zwmurray23/ncsu-freedm-srdes-21/Existing IC Models/CONMMCX001/CONMMCX001.step

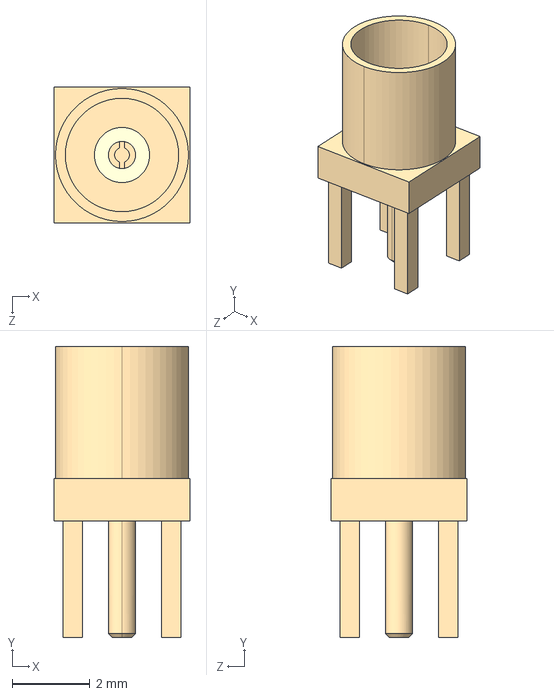
[picture p2: CAD file, 2022-02-21]
Existing IC Models/CONMMCX001/CONMMCX001.step
3.50 x 7.50 x 3.50 mm
