zwmurray23/ncsu-freedm-srdes-21/Existing IC Models/TLV3501AID/3D/TLV3501AID.stp

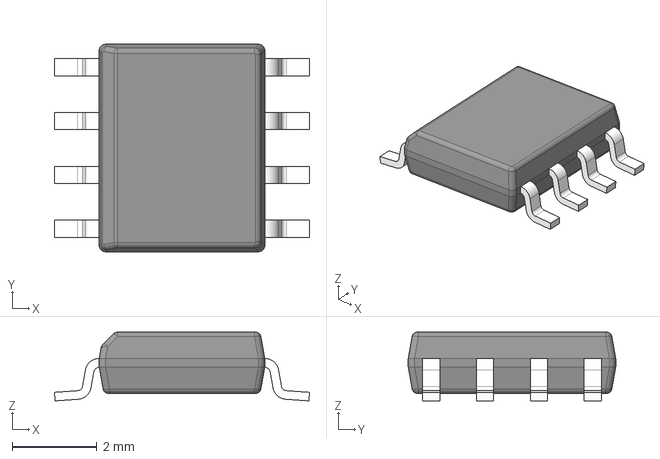
[picture p3: CAD file, 2021-10-21]
Existing IC Models/TLV3501AID/3D/TLV3501AID.stp
6.02 x 4.90 x 1.63 mm
BODY-SO
LEAD-D0008A x 8
