zwmurray23/ncsu-freedm-srdes-21/Existing IC Models/TPS3305-33D/TPS3305-33D.step

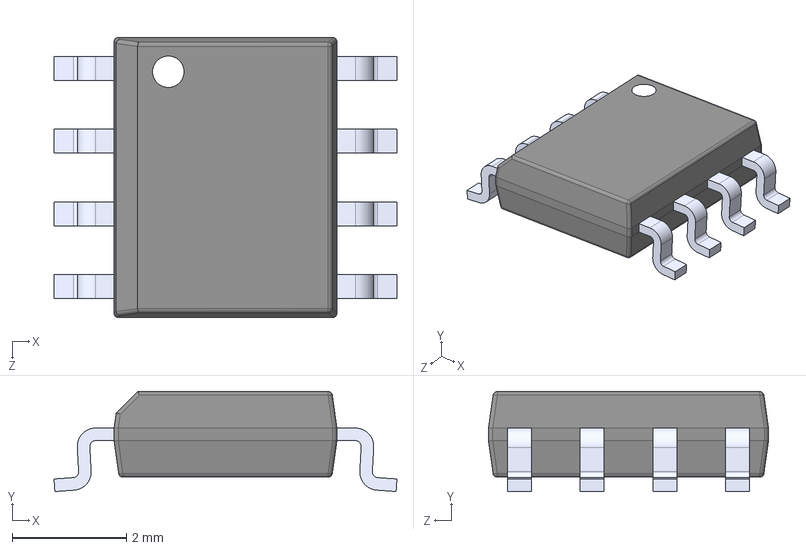
[picture p4: CAD file, 2021-11-08]
Existing IC Models/TPS3305-33D/TPS3305-33D.step
6.00 x 1.75 x 4.90 mm
