zwmurray23/ncsu-freedm-srdes-21/MC-DSP/MC-DSP Libraries/74ACT08SCX/3D/74ACT08SCX.stp

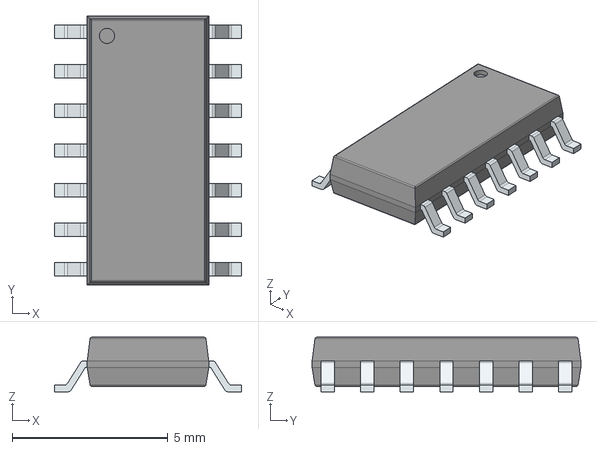
[picture p5: CAD file, 2021-10-21]
MC-DSP/MC-DSP Libraries/74ACT08SCX/3D/74ACT08SCX.stp
6.00 x 8.62 x 1.75 mm
PinsArrayLR
