zwmurray23/ncsu-freedm-srdes-21/MC-DSP/MC-DSP Libraries/CDCLVC1104PW/eec.models/Texas_Instruments_-_CDCLVC1104PW.step

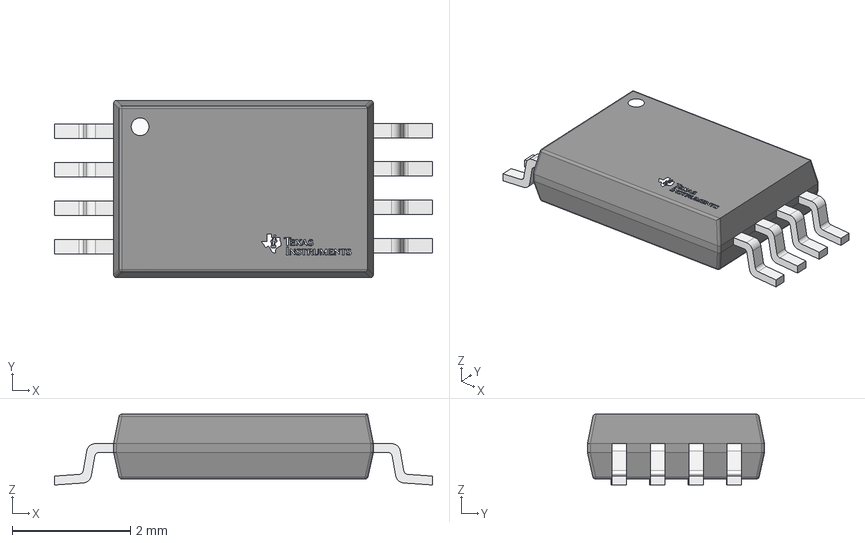
[picture p6: CAD file, 2021-11-08]
MC-DSP/MC-DSP Libraries/CDCLVC1104PW/eec.models/Texas_Instruments_-_CDCLVC1104PW.step
6.40 x 3.00 x 1.20 mm
IC_BODY
IC_LEG x 4
circle
IC_LEG_MIR7 x 4
Texas Instruments
