zwmurray23/ncsu-freedm-srdes-21/MC-DSP/MC-DSP Libraries/DSP_parts/TPS3702CX33DDCR 3.3V Supervisor/TPS3702CX33DDCR.step

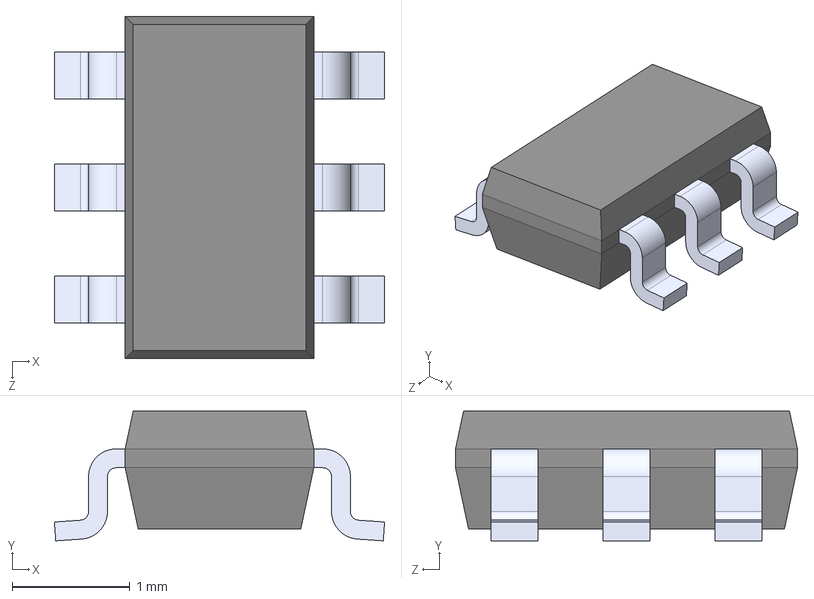
[picture p7: CAD file, 2021-11-08]
MC-DSP/MC-DSP Libraries/DSP_parts/TPS3702CX33DDCR 3.3V Supervisor/TPS3702CX33DDCR.step
2.80 x 1.10 x 2.90 mm
