zwmurray23/ncsu-freedm-srdes-21/MC-DSP/MC-DSP Libraries/R-78E5.0-0.5/3D/R-78E5.0-0.5.stp

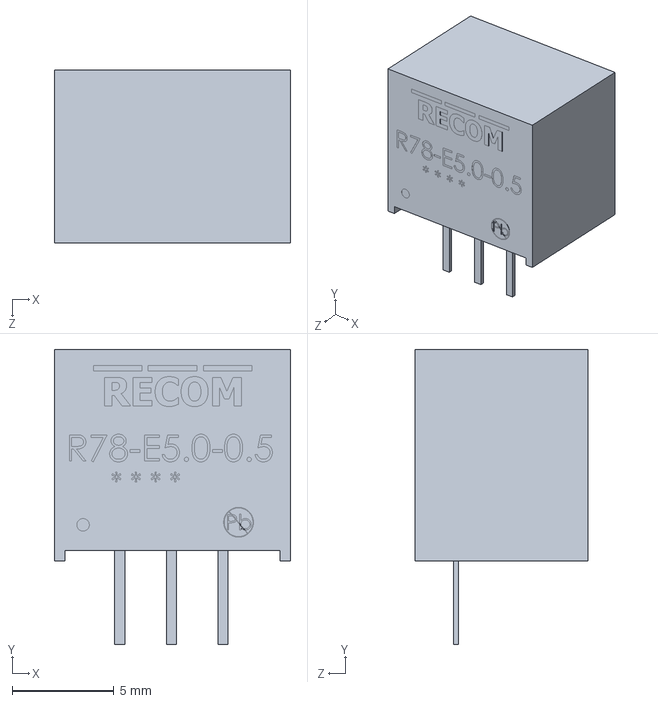
[picture p9: CAD file, 2021-10-21]
MC-DSP/MC-DSP Libraries/R-78E5.0-0.5/3D/R-78E5.0-0.5.stp
11.6 x 14.5 x 8.51 mm
