zwmurray23/ncsu-freedm-srdes-21/MC-FO/Footprints_MC-FO/FOport-IFE98-IFD97.STEP

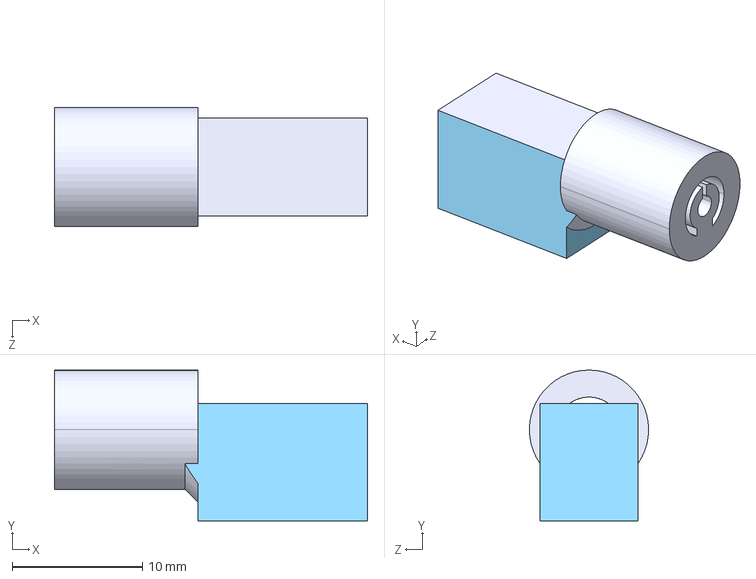
[picture p10: CAD file, 2022-01-19]
MC-FO/Footprints_MC-FO/FOport-IFE98-IFD97.STEP
24.0 x 11.6 x 9.14 mm
