zwmurray23/ncsu-freedm-srdes-21/Existing IC Models/DP83822IRHBR/DP83822IRHBR.step

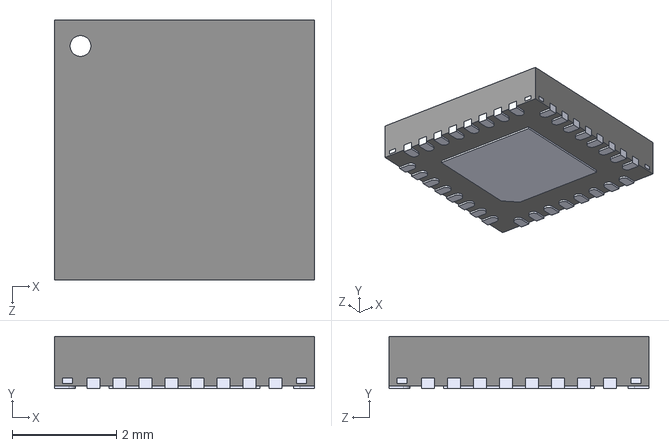
[picture p11: CAD file, 2021-11-08]
Existing IC Models/DP83822IRHBR/DP83822IRHBR.step
5.00 x 1.00 x 5.00 mm
