zwmurray23/ncsu-freedm-srdes-21/(list of files, cad)

Other CAD files:
MC-DSP/MC-DSP Libraries/74ACT08SCX/3D/74ACT08SCX.stl
MC-DSP/MC-DSP Libraries/TPS3703A5500DSER/3D/TPS3703A5500DSER.stl
