zwmurray23/ncsu-freedm-srdes-21/LTSpice/senior_design_attenuator_offset.asc

C1: cap; 470p
C2: cap; 43n
R1: res; 1.5k
R2: res; 5k
R3: res; 1.75k
R4: res; 1.5k
R16: res; {Ri}
R17: res; {Rf}
U1: LT6238
U3: LT6238
V1: voltage; 3
V2: voltage; 3.3
V3: voltage; 0.4
V4: voltage; SINE(0 1 10k); AC 0.1
V5: voltage; 5
V6: voltage; 5
V9: voltage; {Vref}
V11: voltage; SINE(0 10 10k); AC 0.1
Named nets: VSE+, 0, VSE-, V2+, V2-
.tran 0 150u 0 1n
;.ac dec 30 1k 100Meg
.param Rf=330 G=3/20 Ri=Rf/G Vref=Ri/(Rf+Ri) *1.5
;.step param Cs list 15n 16n 18n 20n 22n 24n 27n 30n 33n 36n 39n 43n 47n 51n 56n 62n 68n 75n
Schematic Design
Proposed Alternative Design
