zwmurray23/ncsu-freedm-srdes-21/LTSpice/TI_DSP_single_ended_adc_with_offset.asc

C1: cap; 470p
C2: cap; 43n
C31: cap; 6p
C33: cap; 14.5p
C34: cap; 1p
E4: e2; -1
L7: ind; 1f
R1: res; {Ri}
R2: res; 250
R3: res; {Rf}
S10: sw; SW3
S12: sw; SW2
U1: LT6238
V1: voltage; 3.3
V2: voltage; 5
V3: voltage; 0.4
V4: voltage; {Vref}
V5: voltage; SINE(0 10 10k); AC 0.1
V7: voltage; PULSE(0 1 0 1n 1n 75n 295n)
V9: voltage; 5
Named nets: 0, 5V, sw2+, -5V, VSE+, VSE-
.tran 0 150u 0 1n
.model SW1 SW(Ron=700 Roff=1Meg Vt=.5 Vh=-.4)
.model SW2 SW(Ron=1 Roff=1Meg Vt=-.5 Vh=-0.1)
;.ac dec 30 1k 10G
.model SW3 SW(Ron=425 Roff=1Meg Vt=.5 Vh=-.4)
TI Single-ended 12-Bit, 3MSPS ADC Model
.param Rf=330 G=3/20 Ri=Rf/G Vref=Ri/(Rf+Ri) *1.5
;.step param Cs list 15n 16n 18n 20n 22n 24n 27n 30n 33n 36n 39n 43n 47n 51n 56n 62n 68n 75n
