zwmurray23/ncsu-freedm-srdes-21/MC-FO/MC-FO.kicad_pcb

## KiCad design MC-FO/MC-FO.kicad_pcb (2022-04-28)

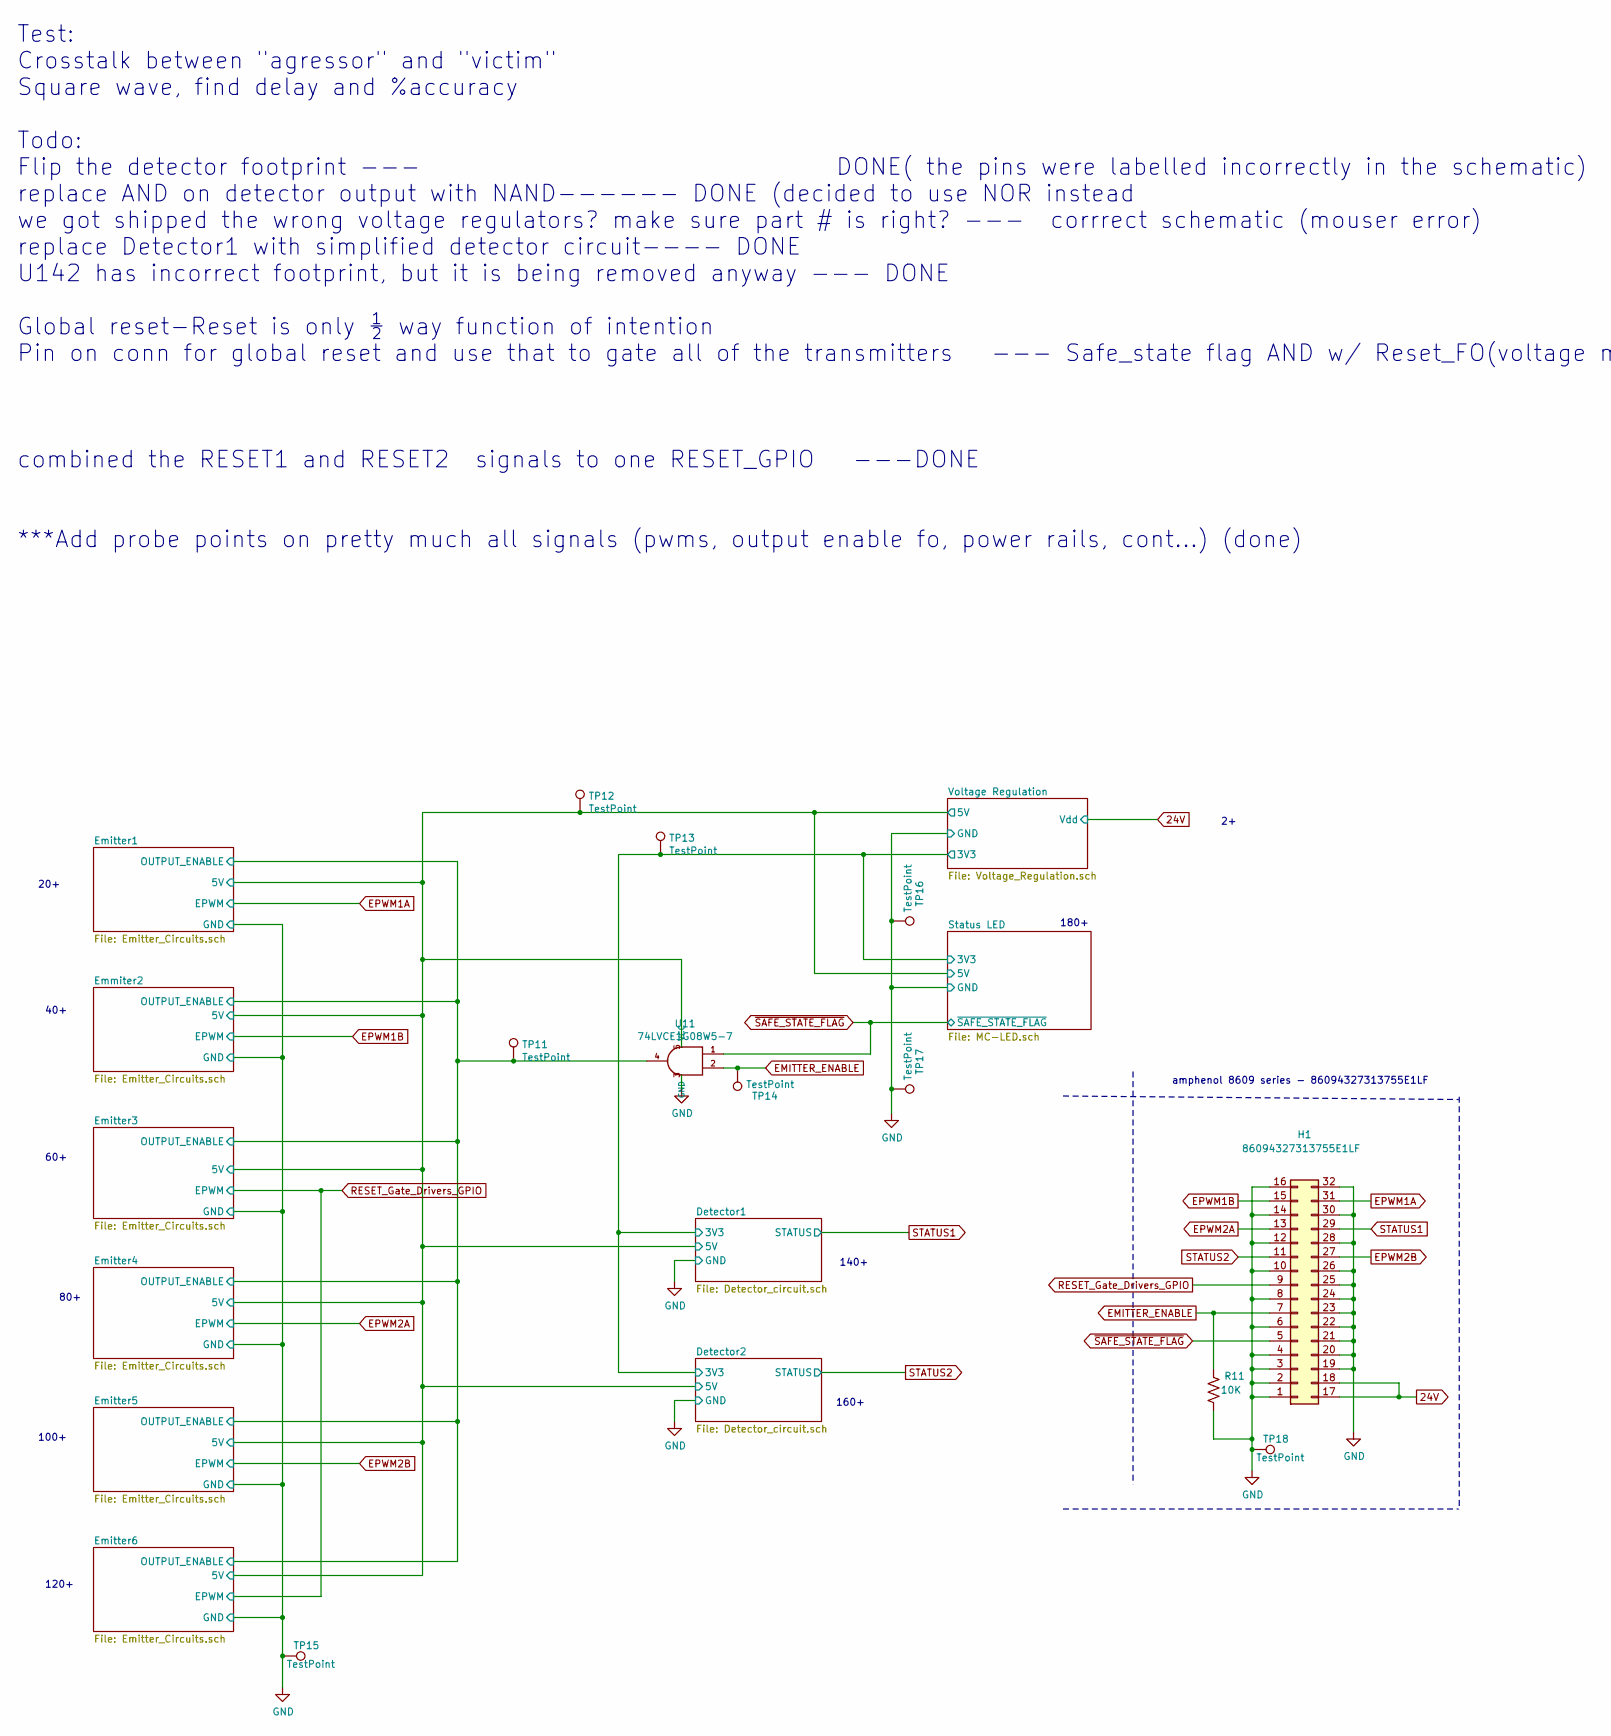
[picture p12: schematic MC-FO.sch, part in row 1, column 1]

Parts:
H1: 86094327313755E1LF
R11: 10K; R_0603_1608Metric
TP11, TP12, TP13, TP14, TP15, TP16, TP17, TP18: TestPoint; TestPoint_Pad_D2.0mm
U11: 74LVCE1G08W5-7; SOT-23-5_HandSoldering

Connections:
24V: H1.17, H1.18; also elsewhere on the board
/Detector1/3V3: TP13.1; also elsewhere on the board
/Detector1/5V: TP12.1, U11.5 (VCC); also elsewhere on the board
/Emitter1/OUTPUT_ENABLE: TP11.1, U11.4; also elsewhere on the board
EMITTER_ENABLE: H1.7, R11.2, TP14.1, U11.2
EPWM1A: H1.31; also elsewhere on the board
EPWM1B: H1.15; also elsewhere on the board
EPWM2A: H1.13; also elsewhere on the board
EPWM2B: H1.27; also elsewhere on the board
GND: H1.1, H1.2, H1.3, H1.4, H1.6, H1.8, H1.10, H1.12, H1.14, H1.16, H1.19, H1.20, H1.21, H1.22, H1.23, H1.24, H1.25, H1.26, H1.28, H1.30, H1.32, R11.1, TP15.1, TP16.1, TP17.1, TP18.1, U11.3 (GND); also elsewhere on the board
RESET_Gate_Drivers_GPIO: H1.9; also elsewhere on the board
STATUS1: H1.29; also elsewhere on the board
STATUS2: H1.11; also elsewhere on the board
~SAFE_STATE_FLAG~: H1.5, U11.1; also elsewhere on the board

Notes on the sheet:
amphenol 8609 series - 86094327313755E1LF
20+
40+
60+
80+
100+
120+
180+
Test: Crosstalk between "agressor" and "victim" Square wave, find delay and %accuracy Todo: Flip the detector footprint --- DONE( the pins were labelled incorrectly in the schematic) replace AND on detector output with NAND------ DONE (decided to use NOR instead we got shipped the wrong voltage reg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
140+
160+

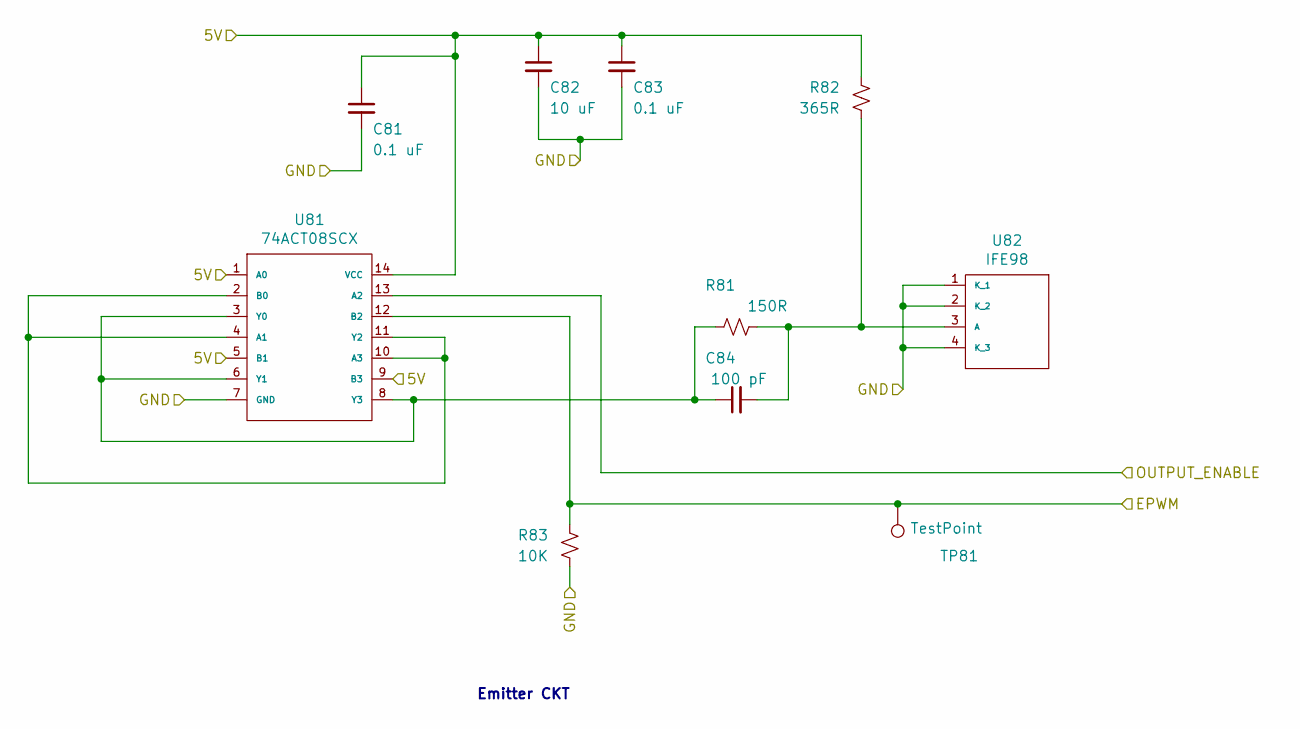
[picture p13: schematic Emitter_Circuits.sch]

Parts:
C21, C23: 0.1 uF; C_0603_1608Metric
C22: 10 uF; C_0603_1608Metric
C24: 100 pF; C_0603_1608Metric
R21: 10K; R_0603_1608Metric
R22: 150R; R_0603_1608Metric
R23: 365R; R_0603_1608Metric
TP21: TestPoint; TestPoint_Pad_D2.0mm
U21: 74ACT08SCX; SOIC-14_3.9x8.7mm_P1.27mm
U22: IFE98

Connections:
/Detector1/5V: C21.1, C22.1, C23.1, R23.2, U21.1 (A0), U21.5 (B1), U21.9 (B3), U21.14 (VCC); also elsewhere on the board
/Emitter1/OUTPUT_ENABLE: U21.13 (A2); also elsewhere on the board
EPWM1A: R21.2, TP21.1, U21.12 (B2); also elsewhere on the board
GND: C21.2, C22.2, C23.2, R21.1, U21.7 (GND), U22.1 (K_1), U22.2 (K_2), U22.4 (K_3); also elsewhere on the board
unnamed: C24.1, R22.1, U21.3 (Y0), U21.6 (Y1), U21.8 (Y3)
unnamed: C24.2, R22.2, R23.1, U22.3 (A)
unnamed: U21.2 (B0), U21.4 (A1), U21.10 (A3), U21.11 (Y2)

Parts of its further copies:
C41, C43, C61, C63, C81, C83, C101, C103, C121, C123: 0.1 uF; C_0603_1608Metric
C42, C62, C82, C102, C122: 10 uF; C_0603_1608Metric
C44, C64, C84, C104, C124: 100 pF; C_0603_1608Metric
R41, R61, R81, R101, R121: 150R; R_0603_1608Metric
R42, R62, R82, R102, R122: 365R; R_0603_1608Metric
R43, R63, R83, R103, R123: 10K; R_0603_1608Metric
TP41, TP61, TP81, TP101, TP121: TestPoint; TestPoint_Pad_D2.0mm
U41, U61, U81, U101, U121: 74ACT08SCX; SOIC-14_3.9x8.7mm_P1.27mm
U42, U62, U82, U102, U122: IFE98

Connections of its further copies:
/Detector1/5V: C41.1, C42.1, C43.1, C61.1, C62.1, C63.1, C81.1, C82.1, C83.1, C101.1, C102.1, C103.1, C121.1, C122.1, C123.1, R42.2, R62.2, R82.2, R102.2, R122.2, U41.1 (A0), U41.5 (B1), U41.9 (B3), U41.14 (VCC), U61.1 (A0), U61.5 (B1), U61.9 (B3), U61.14 (VCC), U81.1 (A0), U81.5 (B1), U81.9 (B3), U81.14 (VCC), U101.1 (A0), U101.5 (B1), U101.9 (B3), U101.14 (VCC), U121.1 (A0), U121.5 (B1), U121.9 (B3), U121.14 (VCC); also elsewhere on the board
/Emitter1/OUTPUT_ENABLE: U41.13 (A2), U61.13 (A2), U81.13 (A2), U101.13 (A2), U121.13 (A2); also elsewhere on the board
EPWM1B: R43.2, TP41.1, U41.12 (B2); also elsewhere on the board
EPWM2A: R83.2, TP81.1, U81.12 (B2); also elsewhere on the board
EPWM2B: R103.2, TP101.1, U101.12 (B2); also elsewhere on the board
GND: C41.2, C42.2, C43.2, C61.2, C62.2, C63.2, C81.2, C82.2, C83.2, C101.2, C102.2, C103.2, C121.2, C122.2, C123.2, R43.1, R63.1, R83.1, R103.1, R123.1, U41.7 (GND), U42.1 (K_1), U42.2 (K_2), U42.4 (K_3), U61.7 (GND), U62.1 (K_1), U62.2 (K_2), U62.4 (K_3), U81.7 (GND), U82.1 (K_1), U82.2 (K_2), U82.4 (K_3), U101.7 (GND), U102.1 (K_1), U102.2 (K_2), U102.4 (K_3), U121.7 (GND), U122.1 (K_1), U122.2 (K_2), U122.4 (K_3); also elsewhere on the board
unnamed: C44.1, R41.1, U41.3 (Y0), U41.6 (Y1), U41.8 (Y3)
unnamed: C44.2, R41.2, R42.1, U42.3 (A)
unnamed: C64.1, R61.1, U61.3 (Y0), U61.6 (Y1), U61.8 (Y3)
unnamed: C64.2, R61.2, R62.1, U62.3 (A)
unnamed: C84.1, R81.1, U81.3 (Y0), U81.6 (Y1), U81.8 (Y3)
unnamed: C84.2, R81.2, R82.1, U82.3 (A)
unnamed: C104.1, R101.1, U101.3 (Y0), U101.6 (Y1), U101.8 (Y3)
unnamed: C104.2, R101.2, R102.1, U102.3 (A)
unnamed: C124.1, R121.1, U121.3 (Y0), U121.6 (Y1), U121.8 (Y3)
unnamed: C124.2, R121.2, R122.1, U122.3 (A)
unnamed: U41.2 (B0), U41.4 (A1), U41.10 (A3), U41.11 (Y2)
unnamed: U61.2 (B0), U61.4 (A1), U61.10 (A3), U61.11 (Y2)
unnamed: U81.2 (B0), U81.4 (A1), U81.10 (A3), U81.11 (Y2)
unnamed: U101.2 (B0), U101.4 (A1), U101.10 (A3), U101.11 (Y2)
unnamed: U121.2 (B0), U121.4 (A1), U121.10 (A3), U121.11 (Y2)
RESET_Gate_Drivers_GPIO: R63.2, R123.2, TP61.1, TP121.1, U61.12 (B2), U121.12 (B2); also elsewhere on the board

Notes on the sheet:
Emitter CKT

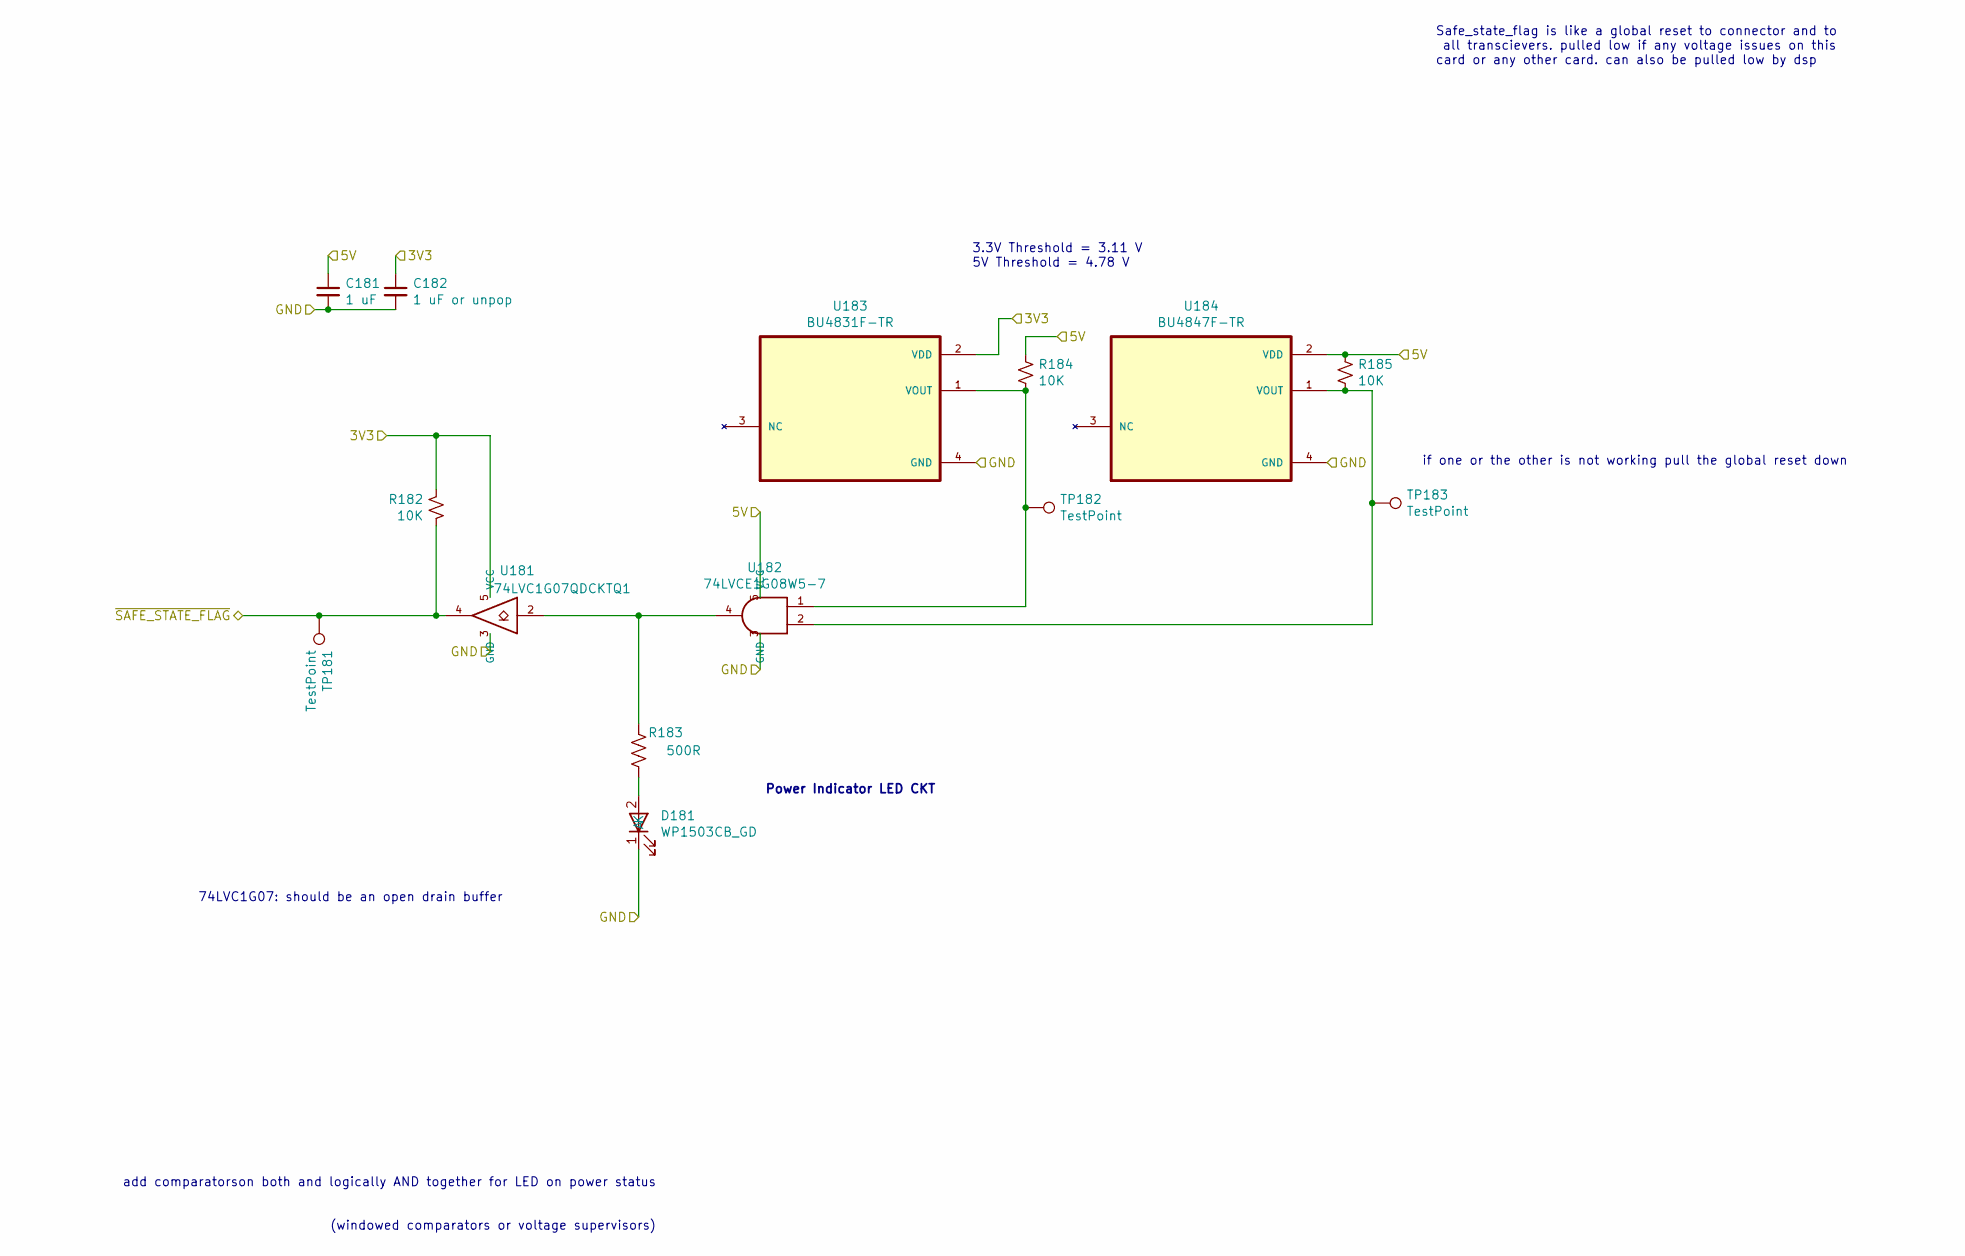
[picture p14: schematic MC-LED.sch]

Parts:
C181: 1 uF; C_0603_1608Metric
C182: 1 uF or unpop; C_0603_1608Metric
D181: WP1503CB_GD; WP1503CBGD
R182, R184, R185: 10K; R_0603_1608Metric
R183: 500R; R_0603_1608Metric
TP181, TP182, TP183: TestPoint; TestPoint_Pad_D2.0mm
U181: 74LVC1G07QDCKTQ1; SOT-353_SC-70-5_Handsoldering
U182: 74LVCE1G08W5-7; SOT-23-5_HandSoldering
U183: BU4831F-TR; BU4847F-TR
U184: BU4847F-TR

Connections:
/Detector1/3V3: C182.1, R182.1, U181.5 (VCC), U183.2 (VDD); also elsewhere on the board
/Detector1/5V: C181.1, R184.1, R185.1, U182.5 (VCC), U184.2 (VDD); also elsewhere on the board
GND: C181.2, C182.2, D181.1 (K), U181.3 (GND), U182.3 (GND), U183.4 (GND), U184.4 (GND); also elsewhere on the board
unnamed: D181.2 (A), R183.1
unnamed: R183.2, U181.2, U182.4
unnamed: R184.2, TP182.1, U182.1, U183.1 (VOUT)
unnamed: R185.2, TP183.1, U182.2, U184.1 (VOUT)
~SAFE_STATE_FLAG~: R182.2, TP181.1, U181.4; also elsewhere on the board

Notes on the sheet:
Power Indicator LED CKT
add comparatorson both and logically AND together for LED on power status (windowed comparators or voltage supervisors)
if one or the other is not working pull the global reset down
74LVC1G07: should be an open drain buffer
Safe_state_flag is like a global reset to connector and to all transcievers. pulled low if any voltage issues on this card or any other card. can also be pulled low by dsp
3.3V Threshold = 3.11 V 5V Threshold = 4.78 V

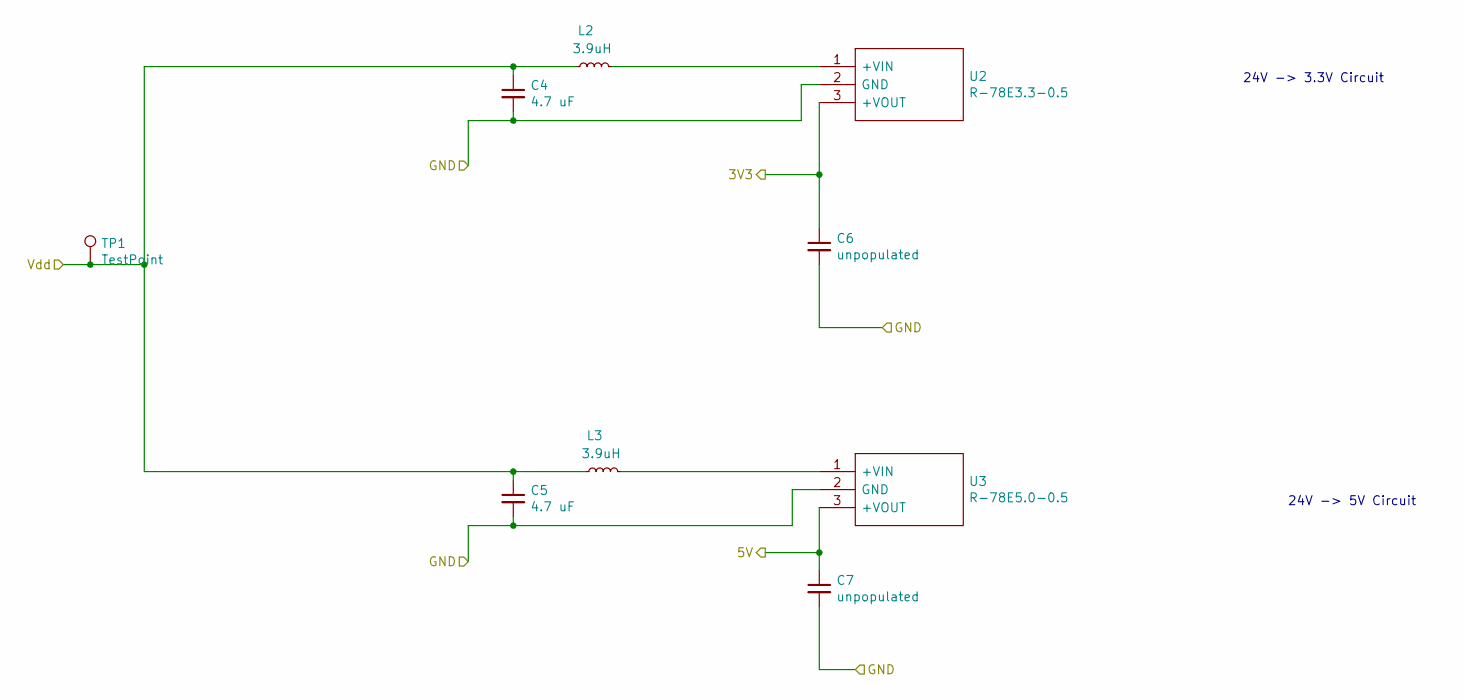
[picture p15: schematic Voltage_Regulation.sch]

Parts:
C4, C5: 4.7 uF; C_1210_3225Metric
C6, C7: unpopulated; C_1210_3225Metric
L2, L3: 3.9uH; L_1812_4532Metric_Pad1.30x3.40mm_HandSolder
TP1: TestPoint; TestPoint_Pad_D2.0mm
U2: R-78E3.3-0.5; SIP3_11.6x8.5mm; Manufacturer_Part_Number R-78E3.3-0.5; Mouser Part Number 919-R-78E3.3-0.5
U3: R-78E5.0-0.5; SIP3_11.6x8.5mm; Manufacturer_Part_Number R-78E5.0-0.5; Mouser Part Number 919-R-78E5.0-0.5

Connections:
24V: C4.1, C5.1, L2.1, L3.1, TP1.1; also elsewhere on the board
/Detector1/3V3: C6.1, U2.3 (+VOUT); also elsewhere on the board
/Detector1/5V: C7.1, U3.3 (+VOUT); also elsewhere on the board
GND: C4.2, C5.2, C6.2, C7.2, U2.2 (GND), U3.2 (GND); also elsewhere on the board
unnamed: L2.2, U2.1 (+VIN)
unnamed: L3.2, U3.1 (+VIN)

Notes on the sheet:
24V -> 5V Circuit
24V -> 3.3V Circuit

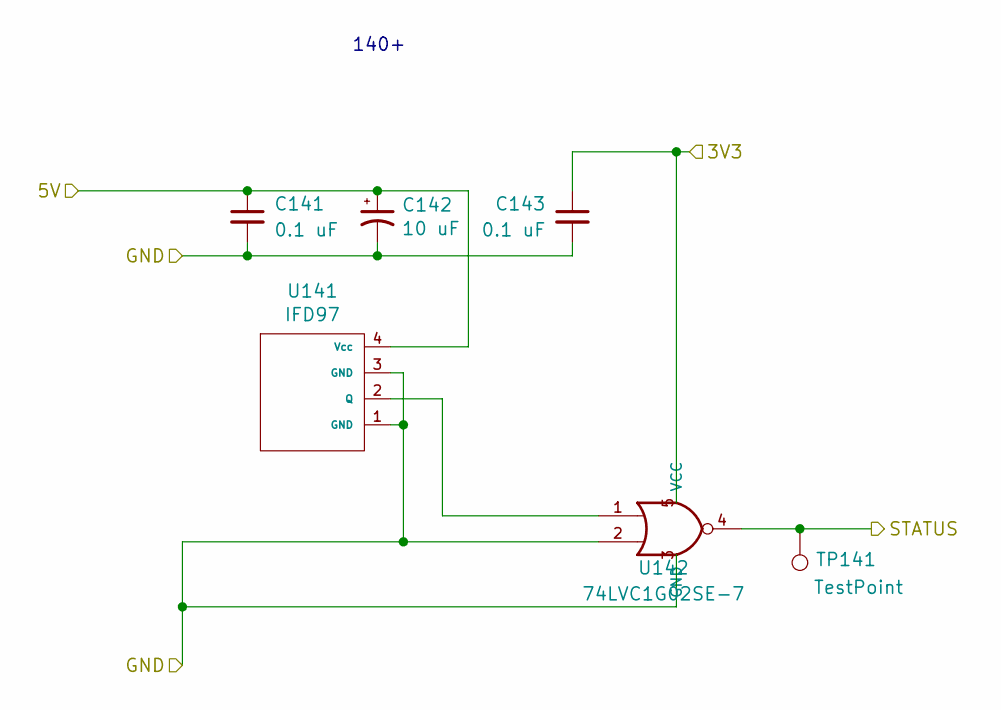
[picture p16: schematic Detector_circuit.sch]

Parts:
C141, C143: 0.1 uF; C_0603_1608Metric
C142: 10 uF; C_0603_1608Metric
TP141: TestPoint; TestPoint_Pad_D2.0mm
U141: IFD97
U142: 74LVC1G02SE-7; SOT-353_SC-70-5_Handsoldering

Connections:
/Detector1/3V3: C143.1, U142.5 (VCC); also elsewhere on the board
/Detector1/5V: C141.1, C142.1, U141.4 (Vcc); also elsewhere on the board
GND: C141.2, C142.2, C143.2, U141.1 (GND), U141.3 (GND), U142.2, U142.3 (GND); also elsewhere on the board
unnamed: U141.2 (Q), U142.1
STATUS1: TP141.1, U142.4; also elsewhere on the board

Parts of its further copies:
C161, C163: 0.1 uF; C_0603_1608Metric
C162: 10 uF; C_0603_1608Metric
TP161: TestPoint; TestPoint_Pad_D2.0mm
U161: IFD97
U162: 74LVC1G02SE-7; SOT-353_SC-70-5_Handsoldering

Connections of its further copies:
/Detector1/3V3: C163.1, U162.5 (VCC); also elsewhere on the board
/Detector1/5V: C161.1, C162.1, U161.4 (Vcc); also elsewhere on the board
GND: C161.2, C162.2, C163.2, U161.1 (GND), U161.3 (GND), U162.2, U162.3 (GND); also elsewhere on the board
unnamed: U161.2 (Q), U162.1
STATUS2: TP161.1, U162.4; also elsewhere on the board

Notes on the sheet:
140+

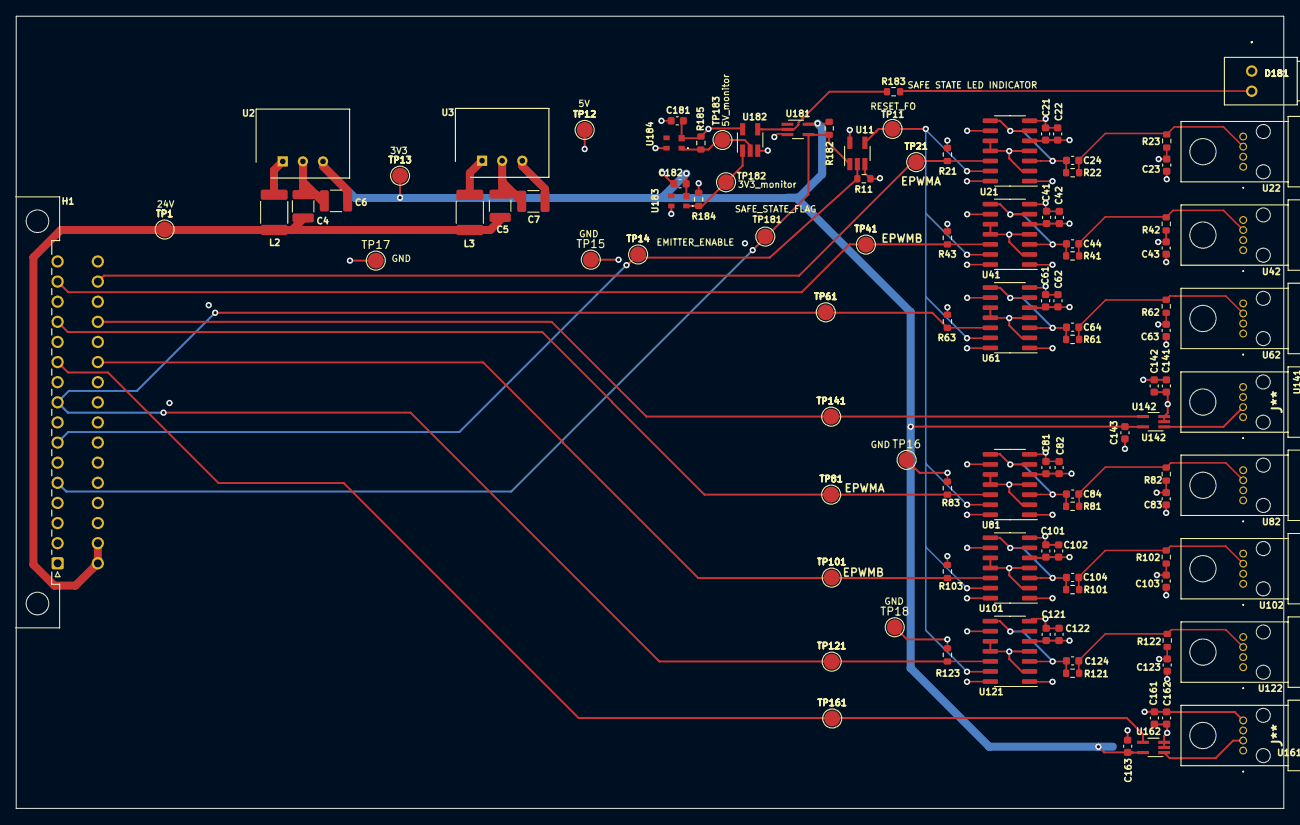
[picture p17: board MC-FO.kicad_pcb from above]

Board: 4 copper layers, 160.0 x 100.0 mm, 106 parts (0 on the bottom side), 40 nets.
