zwmurray23/ncsu-freedm-srdes-21/MC-Backplane/Backplane.kicad_pcb

## KiCad design MC-Backplane/Backplane.kicad_pcb (2022-04-28)

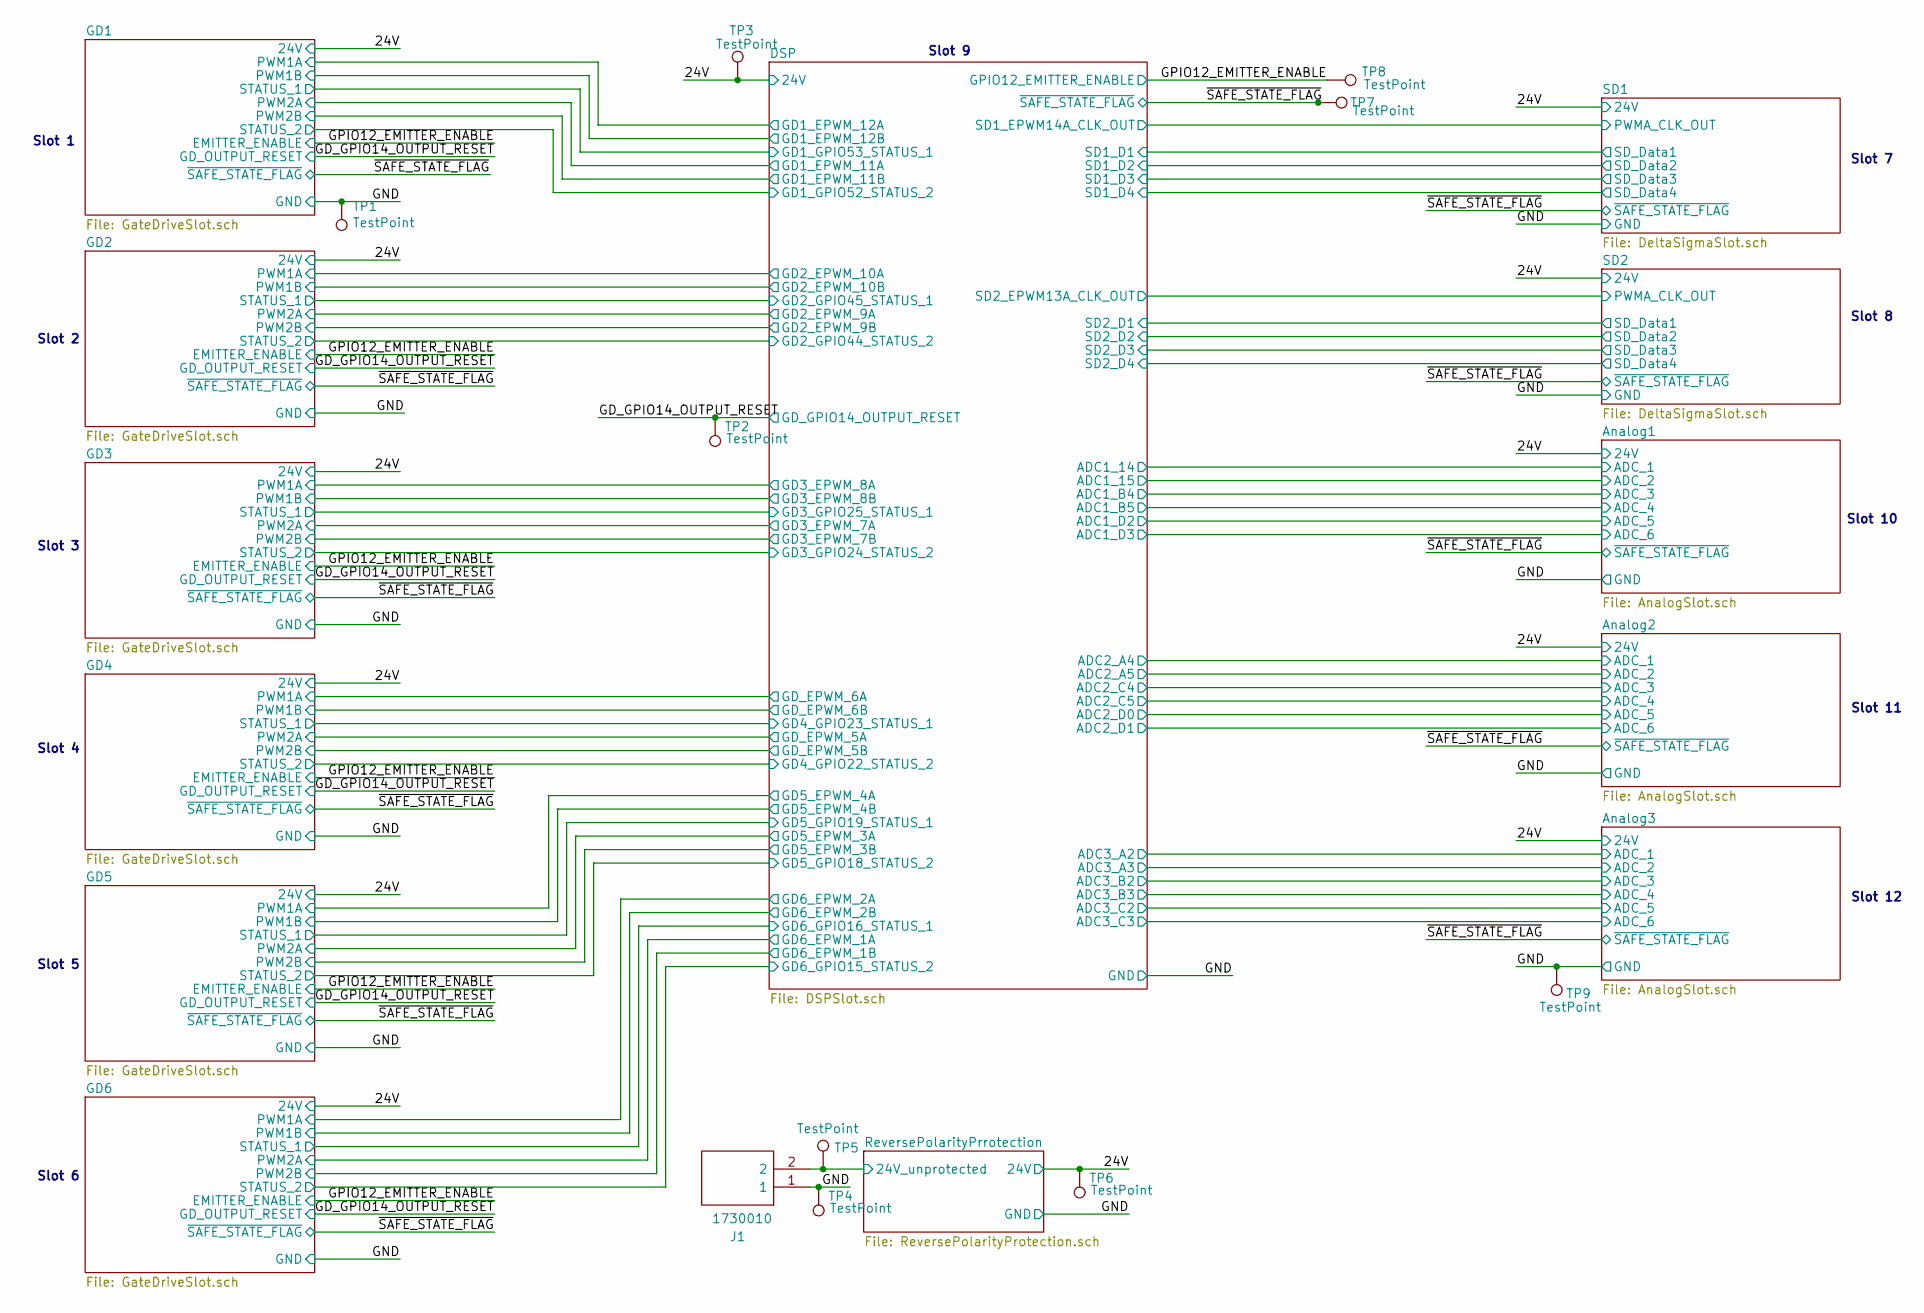
[picture p18: schematic Backplane.sch]

Parts:
J1: 1730010
TP1, TP2, TP3, TP4, TP5, TP6, TP7, TP8, TP9: TestPoint; TestPoint_Plated_Hole_D2.0mm

Connections:
/24V: TP3.1, TP6.1; also elsewhere on the board
/GD_GPIO14_OUTPUT_RESET: TP2.1; also elsewhere on the board
/GND: J1.1, TP1.1, TP4.1, TP9.1; also elsewhere on the board
/GPIO12_EMITTER_ENABLE: TP8.1; also elsewhere on the board
/ReversePolarityPrrotection/24V_unprotected: J1.2, TP5.1; also elsewhere on the board
/~SAFE_STATE_FLAG~: TP7.1; also elsewhere on the board

Notes on the sheet:
Slot 1
Slot 2
Slot 3
Slot 4
Slot 5
Slot 6
Slot 8
Slot 10
Slot 7
Slot 9
Slot 12
Slot 11

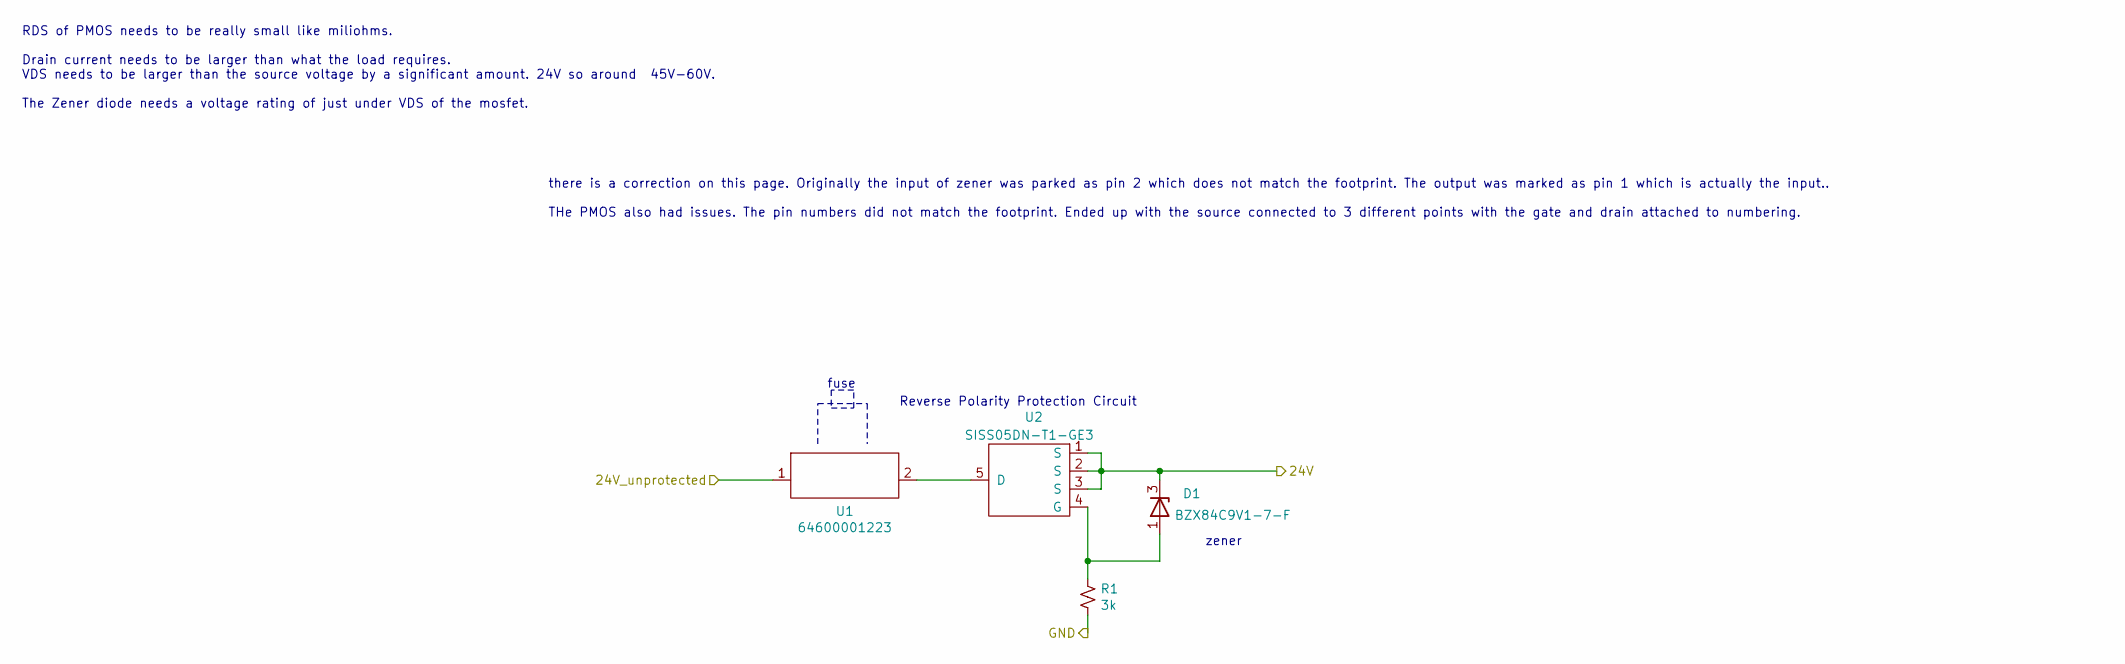
[picture p19: schematic ReversePolarityProtection.sch]

Parts:
D1: BZX84C9V1-7-F; SOT-23_Handsoldering
R1: 3k; R_1206_3216Metric
U1: 64600001223
U2: SISS05DN-T1-GE3; Vishay_PowerPAK_1212-8_Single

Connections:
/24V: D1.3 (out), U2.1 (S), U2.2 (S), U2.3 (S); also elsewhere on the board
/GND: R1.2; also elsewhere on the board
/ReversePolarityPrrotection/24V_unprotected: U1.1 (in); also elsewhere on the board
unnamed: D1.1 (A), R1.1, U2.4 (G)
unnamed: U1.2 (out), U2.5 (D)

Notes on the sheet:
Reverse Polarity Protection Circuit
RDS of PMOS needs to be really small like miliohms. Drain current needs to be larger than what the load requires. VDS needs to be larger than the source voltage by a significant amount. 24V so around 45V-60V. The Zener diode needs a voltage rating of just under VDS of the mosfet.
zener
fuse
there is a correction on this page. Originally the input of zener was parked as pin 2 which does not match the footprint. The output was marked as pin 1 which is actually the input.. THe PMOS also had issues. The pin numbers did not match the footprint. Ended up with the source connected to 3 diffe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

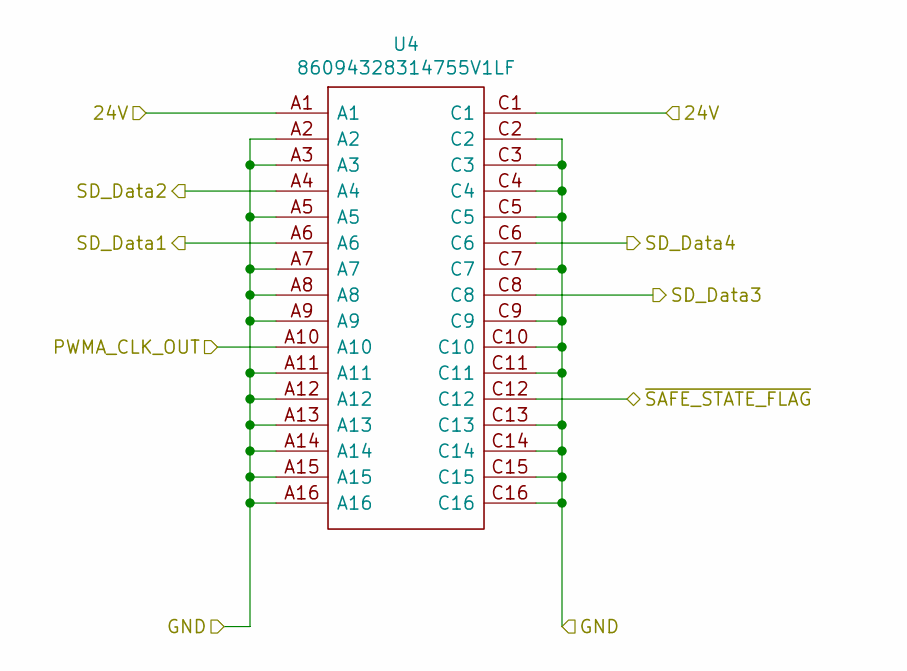
[picture p20: schematic DeltaSigmaSlot.sch]

Parts:
U3: 86094328314755V1LF; Manufacturer_Part_Number 86094328314755V1LF; Mouser Part Number 649-94328314755V1LF

Connections:
/24V: U3.A1, U3.C1; also elsewhere on the board
/DSP/SD1_D1: U3.A6; also elsewhere on the board
/DSP/SD1_D2: U3.A4; also elsewhere on the board
/DSP/SD1_D3: U3.C8; also elsewhere on the board
/DSP/SD1_D4: U3.C6; also elsewhere on the board
/GND: U3.A2, U3.A3, U3.A5, U3.A7, U3.A8, U3.A9, U3.A11, U3.A12, U3.A13, U3.A14, U3.A15, U3.A16, U3.C2, U3.C3, U3.C4, U3.C5, U3.C7, U3.C9, U3.C10, U3.C11, U3.C13, U3.C14, U3.C15, U3.C16; also elsewhere on the board
/SD1/PWMA_CLK_OUT: U3.A10; also elsewhere on the board
/~SAFE_STATE_FLAG~: U3.C12; also elsewhere on the board

Parts of its further copies:
U4: 86094328314755V1LF; Manufacturer_Part_Number 86094328314755V1LF; Mouser Part Number 649-94328314755V1LF

Connections of its further copies:
/24V: U4.A1, U4.C1; also elsewhere on the board
/DSP/SD2_D1: U4.A6; also elsewhere on the board
/DSP/SD2_D2: U4.A4; also elsewhere on the board
/DSP/SD2_D3: U4.C8; also elsewhere on the board
/DSP/SD2_D4: U4.C6; also elsewhere on the board
/GND: U4.A2, U4.A3, U4.A5, U4.A7, U4.A8, U4.A9, U4.A11, U4.A12, U4.A13, U4.A14, U4.A15, U4.A16, U4.C2, U4.C3, U4.C4, U4.C5, U4.C7, U4.C9, U4.C10, U4.C11, U4.C13, U4.C14, U4.C15, U4.C16; also elsewhere on the board
/SD2/PWMA_CLK_OUT: U4.A10; also elsewhere on the board
/~SAFE_STATE_FLAG~: U4.C12; also elsewhere on the board

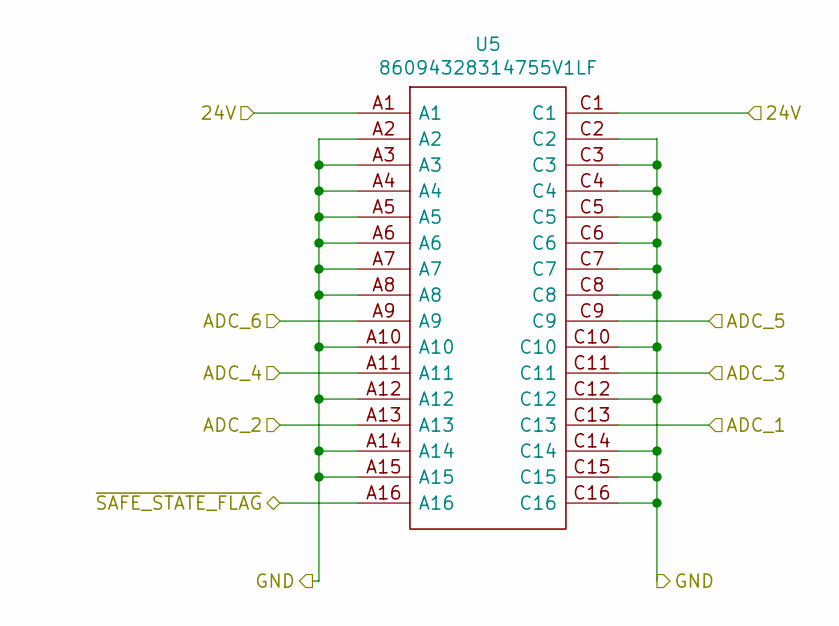
[picture p21: schematic AnalogSlot.sch]

Parts:
U5: 86094328314755V1LF; Manufacturer_Part_Number 86094328314755V1LF; Mouser Part Number 649-94328314755V1LF

Connections:
/24V: U5.A1, U5.C1; also elsewhere on the board
/DSP/ADC2_A4: U5.C13; also elsewhere on the board
/DSP/ADC2_A5: U5.A13; also elsewhere on the board
/DSP/ADC2_C4: U5.C11; also elsewhere on the board
/DSP/ADC2_C5: U5.A11; also elsewhere on the board
/DSP/ADC2_D0: U5.C9; also elsewhere on the board
/DSP/ADC2_D1: U5.A9; also elsewhere on the board
/GND: U5.A2, U5.A3, U5.A4, U5.A5, U5.A6, U5.A7, U5.A8, U5.A10, U5.A12, U5.A14, U5.A15, U5.C2, U5.C3, U5.C4, U5.C5, U5.C6, U5.C7, U5.C8, U5.C10, U5.C12, U5.C14, U5.C15, U5.C16; also elsewhere on the board
/~SAFE_STATE_FLAG~: U5.A16; also elsewhere on the board

Parts of its further copies:
U10, U11: 86094328314755V1LF; Manufacturer_Part_Number 86094328314755V1LF; Mouser Part Number 649-94328314755V1LF

Connections of its further copies:
/24V: U10.A1, U10.C1, U11.A1, U11.C1; also elsewhere on the board
/DSP/ADC1_14: U10.C13; also elsewhere on the board
/DSP/ADC1_15: U10.A13; also elsewhere on the board
/DSP/ADC1_B4: U10.C11; also elsewhere on the board
/DSP/ADC1_B5: U10.A11; also elsewhere on the board
/DSP/ADC1_D2: U10.C9; also elsewhere on the board
/DSP/ADC1_D3: U10.A9; also elsewhere on the board
/DSP/ADC3_A2: U11.C13; also elsewhere on the board
/DSP/ADC3_A3: U11.A13; also elsewhere on the board
/DSP/ADC3_B2: U11.C11; also elsewhere on the board
/DSP/ADC3_B3: U11.A11; also elsewhere on the board
/DSP/ADC3_C2: U11.C9; also elsewhere on the board
/DSP/ADC3_C3: U11.A9; also elsewhere on the board
/GND: U10.A2, U10.A3, U10.A4, U10.A5, U10.A6, U10.A7, U10.A8, U10.A10, U10.A12, U10.A14, U10.A15, U10.C2, U10.C3, U10.C4, U10.C5, U10.C6, U10.C7, U10.C8, U10.C10, U10.C12, U10.C14, U10.C15, U10.C16, U11.A2, U11.A3, U11.A4, U11.A5, U11.A6, U11.A7, U11.A8, U11.A10, U11.A12, U11.A14, U11.A15, U11.C2, U11.C3, U11.C4, U11.C5, U11.C6, U11.C7, U11.C8, U11.C10, U11.C12, U11.C14, U11.C15, U11.C16; also elsewhere on the board
/~SAFE_STATE_FLAG~: U10.A16, U11.A16; also elsewhere on the board
