zwmurray23/ncsu-freedm-srdes-21/MC-Backplane/Backplane.kicad_pcb

## KiCad design MC-Backplane/Backplane.kicad_pcb (continued)

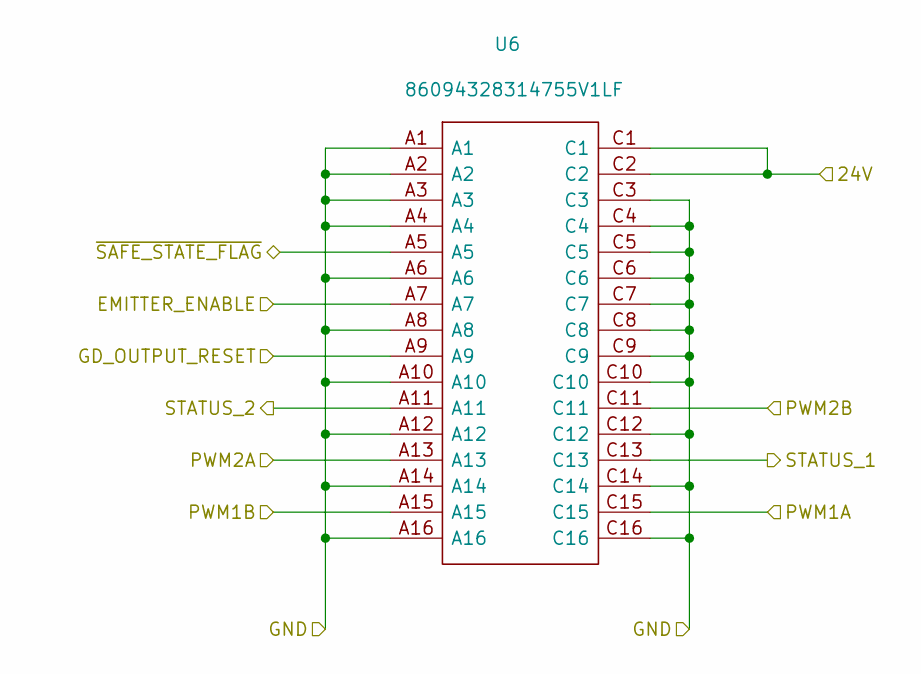
[picture p22: schematic GateDriveSlot.sch]

Parts:
U6: 86094328314755V1LF

Connections:
/24V: U6.C1, U6.C2; also elsewhere on the board
/DSP/GD1_EPWM_11A: U6.A13; also elsewhere on the board
/DSP/GD1_EPWM_11B: U6.C11; also elsewhere on the board
/DSP/GD1_EPWM_12A: U6.C15; also elsewhere on the board
/DSP/GD1_EPWM_12B: U6.A15; also elsewhere on the board
/DSP/GD1_GPIO52_STATUS_2: U6.A11; also elsewhere on the board
/DSP/GD1_GPIO53_STATUS_1: U6.C13; also elsewhere on the board
/GD_GPIO14_OUTPUT_RESET: U6.A9; also elsewhere on the board
/GND: U6.A1, U6.A2, U6.A3, U6.A4, U6.A6, U6.A8, U6.A10, U6.A12, U6.A14, U6.A16, U6.C3, U6.C4, U6.C5, U6.C6, U6.C7, U6.C8, U6.C9, U6.C10, U6.C12, U6.C14, U6.C16; also elsewhere on the board
/GPIO12_EMITTER_ENABLE: U6.A7; also elsewhere on the board
/~SAFE_STATE_FLAG~: U6.A5; also elsewhere on the board

Parts of its further copies:
U7, U8, U9, U13, U14: 86094328314755V1LF

Connections of its further copies:
/24V: U7.C1, U7.C2, U8.C1, U8.C2, U9.C1, U9.C2, U13.C1, U13.C2, U14.C1, U14.C2; also elsewhere on the board
/DSP/GD2_EPWM_9A: U13.A13; also elsewhere on the board
/DSP/GD2_EPWM_9B: U13.C11; also elsewhere on the board
/DSP/GD2_EPWM_10A: U13.C15; also elsewhere on the board
/DSP/GD2_EPWM_10B: U13.A15; also elsewhere on the board
/DSP/GD2_GPIO44_STATUS_2: U13.A11; also elsewhere on the board
/DSP/GD2_GPIO45_STATUS_1: U13.C13; also elsewhere on the board
/DSP/GD3_EPWM_7A: U14.A13; also elsewhere on the board
/DSP/GD3_EPWM_7B: U14.C11; also elsewhere on the board
/DSP/GD3_EPWM_8A: U14.C15; also elsewhere on the board
/DSP/GD3_EPWM_8B: U14.A15; also elsewhere on the board
/DSP/GD3_GPIO24_STATUS_2: U14.A11; also elsewhere on the board
/DSP/GD3_GPIO25_STATUS_1: U14.C13; also elsewhere on the board
/DSP/GD4_GPIO22_STATUS_2: U7.A11; also elsewhere on the board
/DSP/GD4_GPIO23_STATUS_1: U7.C13; also elsewhere on the board
/DSP/GD5_EPWM_3A: U9.A13; also elsewhere on the board
/DSP/GD5_EPWM_3B: U9.C11; also elsewhere on the board
/DSP/GD5_EPWM_4A: U9.C15; also elsewhere on the board
/DSP/GD5_EPWM_4B: U9.A15; also elsewhere on the board
/DSP/GD5_GPIO18_STATUS_2: U9.A11; also elsewhere on the board
/DSP/GD5_GPIO19_STATUS_1: U9.C13; also elsewhere on the board
/DSP/GD6_EPWM_1A: U8.A13; also elsewhere on the board
/DSP/GD6_EPWM_1B: U8.C11; also elsewhere on the board
/DSP/GD6_EPWM_2A: U8.C15; also elsewhere on the board
/DSP/GD6_EPWM_2B: U8.A15; also elsewhere on the board
/DSP/GD6_GPIO15_STATUS_2: U8.A11; also elsewhere on the board
/DSP/GD6_GPIO16_STATUS_1: U8.C13; also elsewhere on the board
/DSP/GD_EPWM_5A: U7.A13; also elsewhere on the board
/DSP/GD_EPWM_5B: U7.C11; also elsewhere on the board
/DSP/GD_EPWM_6A: U7.C15; also elsewhere on the board
/DSP/GD_EPWM_6B: U7.A15; also elsewhere on the board
/GD_GPIO14_OUTPUT_RESET: U7.A9, U8.A9, U9.A9, U13.A9, U14.A9; also elsewhere on the board
/GND: U7.A1, U7.A2, U7.A3, U7.A4, U7.A6, U7.A8, U7.A10, U7.A12, U7.A14, U7.A16, U7.C3, U7.C4, U7.C5, U7.C6, U7.C7, U7.C8, U7.C9, U7.C10, U7.C12, U7.C14, U7.C16, U8.A1, U8.A2, U8.A3, U8.A4, U8.A6, U8.A8, U8.A10, U8.A12, U8.A14, U8.A16, U8.C3, U8.C4, U8.C5, U8.C6, U8.C7, U8.C8, U8.C9, U8.C10, U8.C12, U8.C14, U8.C16, U9.A1, U9.A2, U9.A3, U9.A4, U9.A6, U9.A8, U9.A10, U9.A12, U9.A14, U9.A16, U9.C3, U9.C4, U9.C5, U9.C6, U9.C7, U9.C8, U9.C9, U9.C10, U9.C12, U9.C14, U9.C16, U13.A1, U13.A2, U13.A3, U13.A4, U13.A6, U13.A8, U13.A10, U13.A12, U13.A14, U13.A16, U13.C3, U13.C4, U13.C5, U13.C6, U13.C7, U13.C8, U13.C9, U13.C10, U13.C12, U13.C14, U13.C16, U14.A1, U14.A2, U14.A3, U14.A4, U14.A6, U14.A8, U14.A10, U14.A12, U14.A14, U14.A16, U14.C3, U14.C4, U14.C5, U14.C6, U14.C7, U14.C8, U14.C9, U14.C10, U14.C12, U14.C14, U14.C16; also elsewhere on the board
/GPIO12_EMITTER_ENABLE: U7.A7, U8.A7, U9.A7, U13.A7, U14.A7; also elsewhere on the board
/~SAFE_STATE_FLAG~: U7.A5, U8.A5, U9.A5, U13.A5, U14.A5; also elsewhere on the board

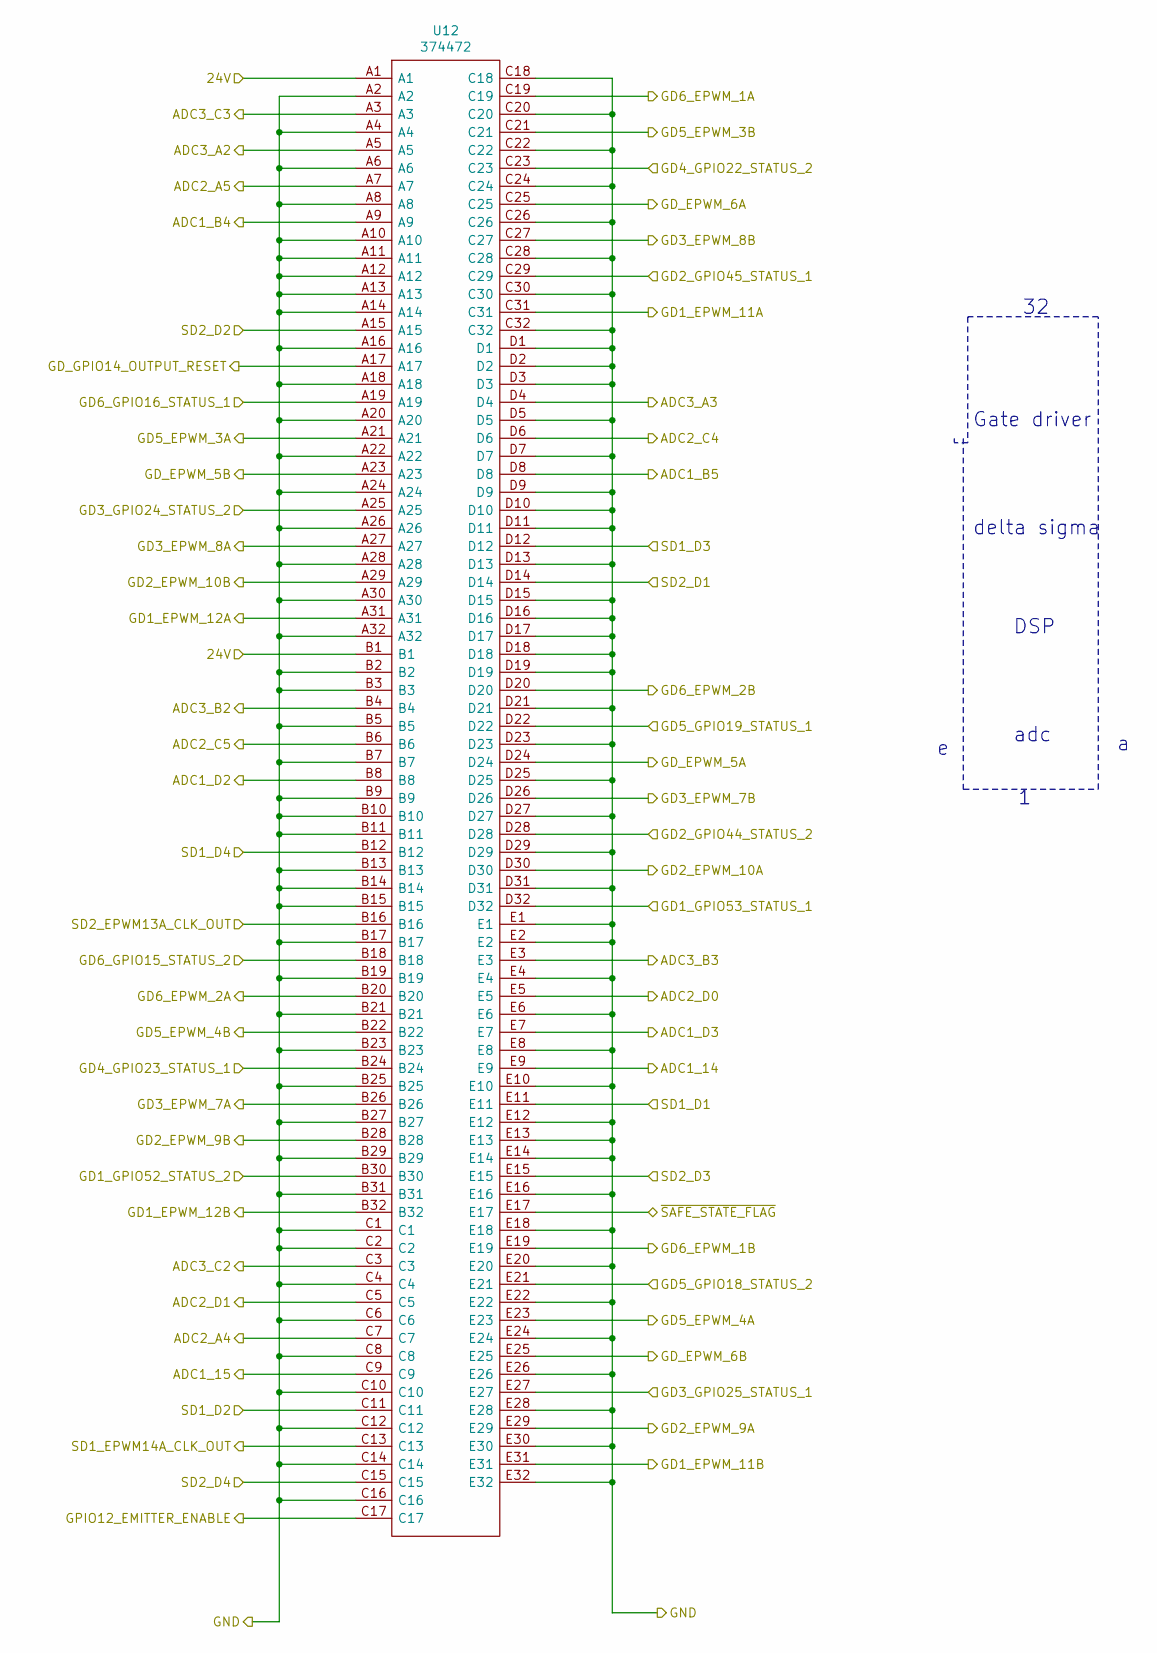
[picture p23: schematic DSPSlot.sch]

Parts:
U12: 374472; Manufacturer_Part_Number 374472; Mouser Part Number 305-374472

Connections:
/24V: U12.A1, U12.B1; also elsewhere on the board
/DSP/ADC1_14: U12.E9; also elsewhere on the board
/DSP/ADC1_15: U12.C9; also elsewhere on the board
/DSP/ADC1_B4: U12.A9; also elsewhere on the board
/DSP/ADC1_B5: U12.D8; also elsewhere on the board
/DSP/ADC1_D2: U12.B8; also elsewhere on the board
/DSP/ADC1_D3: U12.E7; also elsewhere on the board
/DSP/ADC2_A4: U12.C7; also elsewhere on the board
/DSP/ADC2_A5: U12.A7; also elsewhere on the board
/DSP/ADC2_C4: U12.D6; also elsewhere on the board
/DSP/ADC2_C5: U12.B6; also elsewhere on the board
/DSP/ADC2_D0: U12.E5; also elsewhere on the board
/DSP/ADC2_D1: U12.C5; also elsewhere on the board
/DSP/ADC3_A2: U12.A5; also elsewhere on the board
/DSP/ADC3_A3: U12.D4; also elsewhere on the board
/DSP/ADC3_B2: U12.B4; also elsewhere on the board
/DSP/ADC3_B3: U12.E3; also elsewhere on the board
/DSP/ADC3_C2: U12.C3; also elsewhere on the board
/DSP/ADC3_C3: U12.A3; also elsewhere on the board
/DSP/GD1_EPWM_11A: U12.C31; also elsewhere on the board
/DSP/GD1_EPWM_11B: U12.E31; also elsewhere on the board
/DSP/GD1_EPWM_12A: U12.A31; also elsewhere on the board
/DSP/GD1_EPWM_12B: U12.B32; also elsewhere on the board
/DSP/GD1_GPIO52_STATUS_2: U12.B30; also elsewhere on the board
/DSP/GD1_GPIO53_STATUS_1: U12.D32; also elsewhere on the board
/DSP/GD2_EPWM_9A: U12.E29; also elsewhere on the board
/DSP/GD2_EPWM_9B: U12.B28; also elsewhere on the board
/DSP/GD2_EPWM_10A: U12.D30; also elsewhere on the board
/DSP/GD2_EPWM_10B: U12.A29; also elsewhere on the board
/DSP/GD2_GPIO44_STATUS_2: U12.D28; also elsewhere on the board
/DSP/GD2_GPIO45_STATUS_1: U12.C29; also elsewhere on the board
/DSP/GD3_EPWM_7A: U12.B26; also elsewhere on the board
/DSP/GD3_EPWM_7B: U12.D26; also elsewhere on the board
/DSP/GD3_EPWM_8A: U12.A27; also elsewhere on the board
/DSP/GD3_EPWM_8B: U12.C27; also elsewhere on the board
/DSP/GD3_GPIO24_STATUS_2: U12.A25; also elsewhere on the board
/DSP/GD3_GPIO25_STATUS_1: U12.E27; also elsewhere on the board
/DSP/GD4_GPIO22_STATUS_2: U12.C23; also elsewhere on the board
/DSP/GD4_GPIO23_STATUS_1: U12.B24; also elsewhere on the board
/DSP/GD5_EPWM_3A: U12.A21; also elsewhere on the board
/DSP/GD5_EPWM_3B: U12.C21; also elsewhere on the board
/DSP/GD5_EPWM_4A: U12.E23; also elsewhere on the board
/DSP/GD5_EPWM_4B: U12.B22; also elsewhere on the board
/DSP/GD5_GPIO18_STATUS_2: U12.E21; also elsewhere on the board
/DSP/GD5_GPIO19_STATUS_1: U12.D22; also elsewhere on the board
/DSP/GD6_EPWM_1A: U12.C19; also elsewhere on the board
/DSP/GD6_EPWM_1B: U12.E19; also elsewhere on the board
/DSP/GD6_EPWM_2A: U12.B20; also elsewhere on the board
/DSP/GD6_EPWM_2B: U12.D20; also elsewhere on the board
/DSP/GD6_GPIO15_STATUS_2: U12.B18; also elsewhere on the board
/DSP/GD6_GPIO16_STATUS_1: U12.A19; also elsewhere on the board
/DSP/GD_EPWM_5A: U12.D24; also elsewhere on the board
/DSP/GD_EPWM_5B: U12.A23; also elsewhere on the board
/DSP/GD_EPWM_6A: U12.C25; also elsewhere on the board
/DSP/GD_EPWM_6B: U12.E25; also elsewhere on the board
/DSP/SD1_D1: U12.E11; also elsewhere on the board
/DSP/SD1_D2: U12.C11; also elsewhere on the board
/DSP/SD1_D3: U12.D12; also elsewhere on the board
/DSP/SD1_D4: U12.B12; also elsewhere on the board
/DSP/SD2_D1: U12.D14; also elsewhere on the board
/DSP/SD2_D2: U12.A15; also elsewhere on the board
/DSP/SD2_D3: U12.E15; also elsewhere on the board
/DSP/SD2_D4: U12.C15; also elsewhere on the board
/GD_GPIO14_OUTPUT_RESET: U12.A17; also elsewhere on the board
/GND: U12.A2, U12.A4, U12.A6, U12.A8, U12.A10, U12.A11, U12.A12, U12.A13, U12.A14, U12.A16, U12.A18, U12.A20, U12.A22, U12.A24, U12.A26, U12.A28, U12.A30, U12.A32, U12.B2, U12.B3, U12.B5, U12.B7, U12.B9, U12.B10, U12.B11, U12.B13, U12.B14, U12.B15, U12.B17, U12.B19, U12.B21, U12.B23, U12.B25, U12.B27, U12.B29, U12.B31, U12.C1, U12.C2, U12.C4, U12.C6, U12.C8, U12.C10, U12.C12, U12.C14, U12.C16, U12.C18, U12.C20, U12.C22, U12.C24, U12.C26, U12.C28, U12.C30, U12.C32, U12.D1, U12.D2, U12.D3, U12.D5, U12.D7, U12.D9, U12.D10, U12.D11, U12.D13, U12.D15, U12.D16, U12.D17, U12.D18, U12.D19, U12.D21, U12.D23, U12.D25, U12.D27, U12.D29, U12.D31, U12.E1, U12.E2, U12.E4, U12.E6, U12.E8, U12.E10, U12.E12, U12.E13, U12.E14, U12.E16, U12.E18, U12.E20, U12.E22, U12.E24, U12.E26, U12.E28, U12.E30, U12.E32; also elsewhere on the board
/GPIO12_EMITTER_ENABLE: U12.C17; also elsewhere on the board
/SD1/PWMA_CLK_OUT: U12.C13; also elsewhere on the board
/SD2/PWMA_CLK_OUT: U12.B16; also elsewhere on the board
/~SAFE_STATE_FLAG~: U12.E17; also elsewhere on the board

Notes on the sheet:
adc
DSP
delta sigma
Gate driver

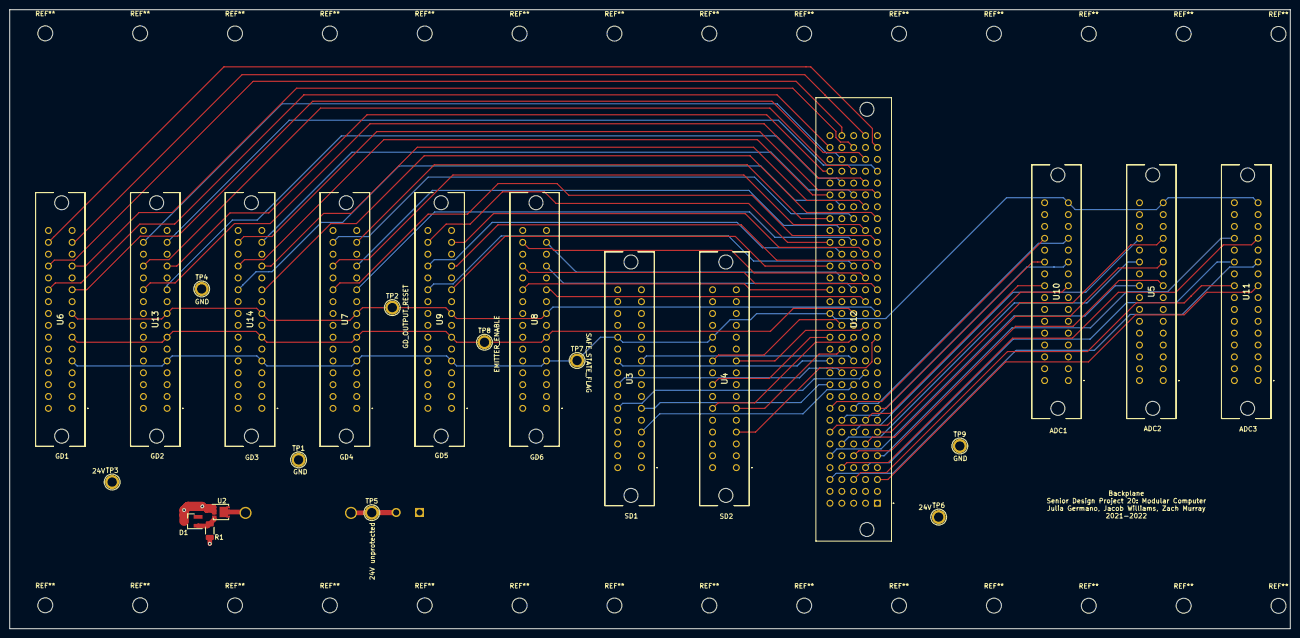
[picture p24: board Backplane.kicad_pcb from above]

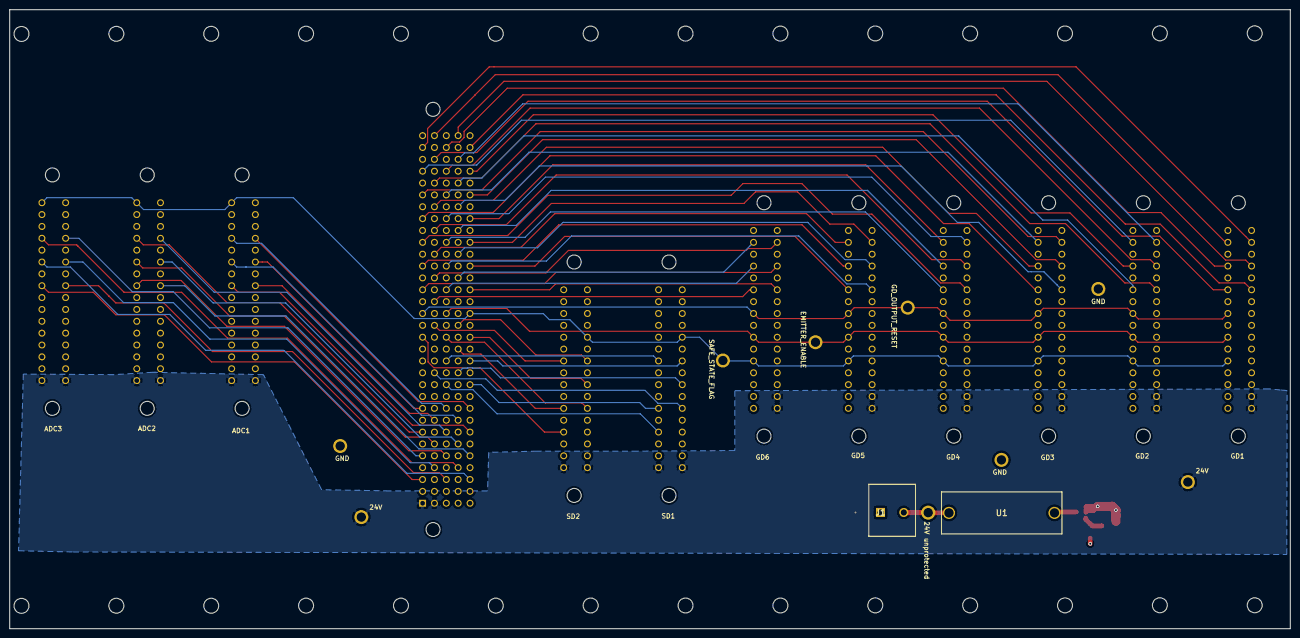
[picture p25: board Backplane.kicad_pcb from below]

Board: 4 copper layers, 274.3 x 132.6 mm, 26 parts (2 on the bottom side), 72 nets.
