zwmurray23/ncsu-freedm-srdes-21/MC-DSP/MC-DSP.kicad_pcb

## KiCad design MC-DSP/MC-DSP.kicad_pcb (2022-04-01)

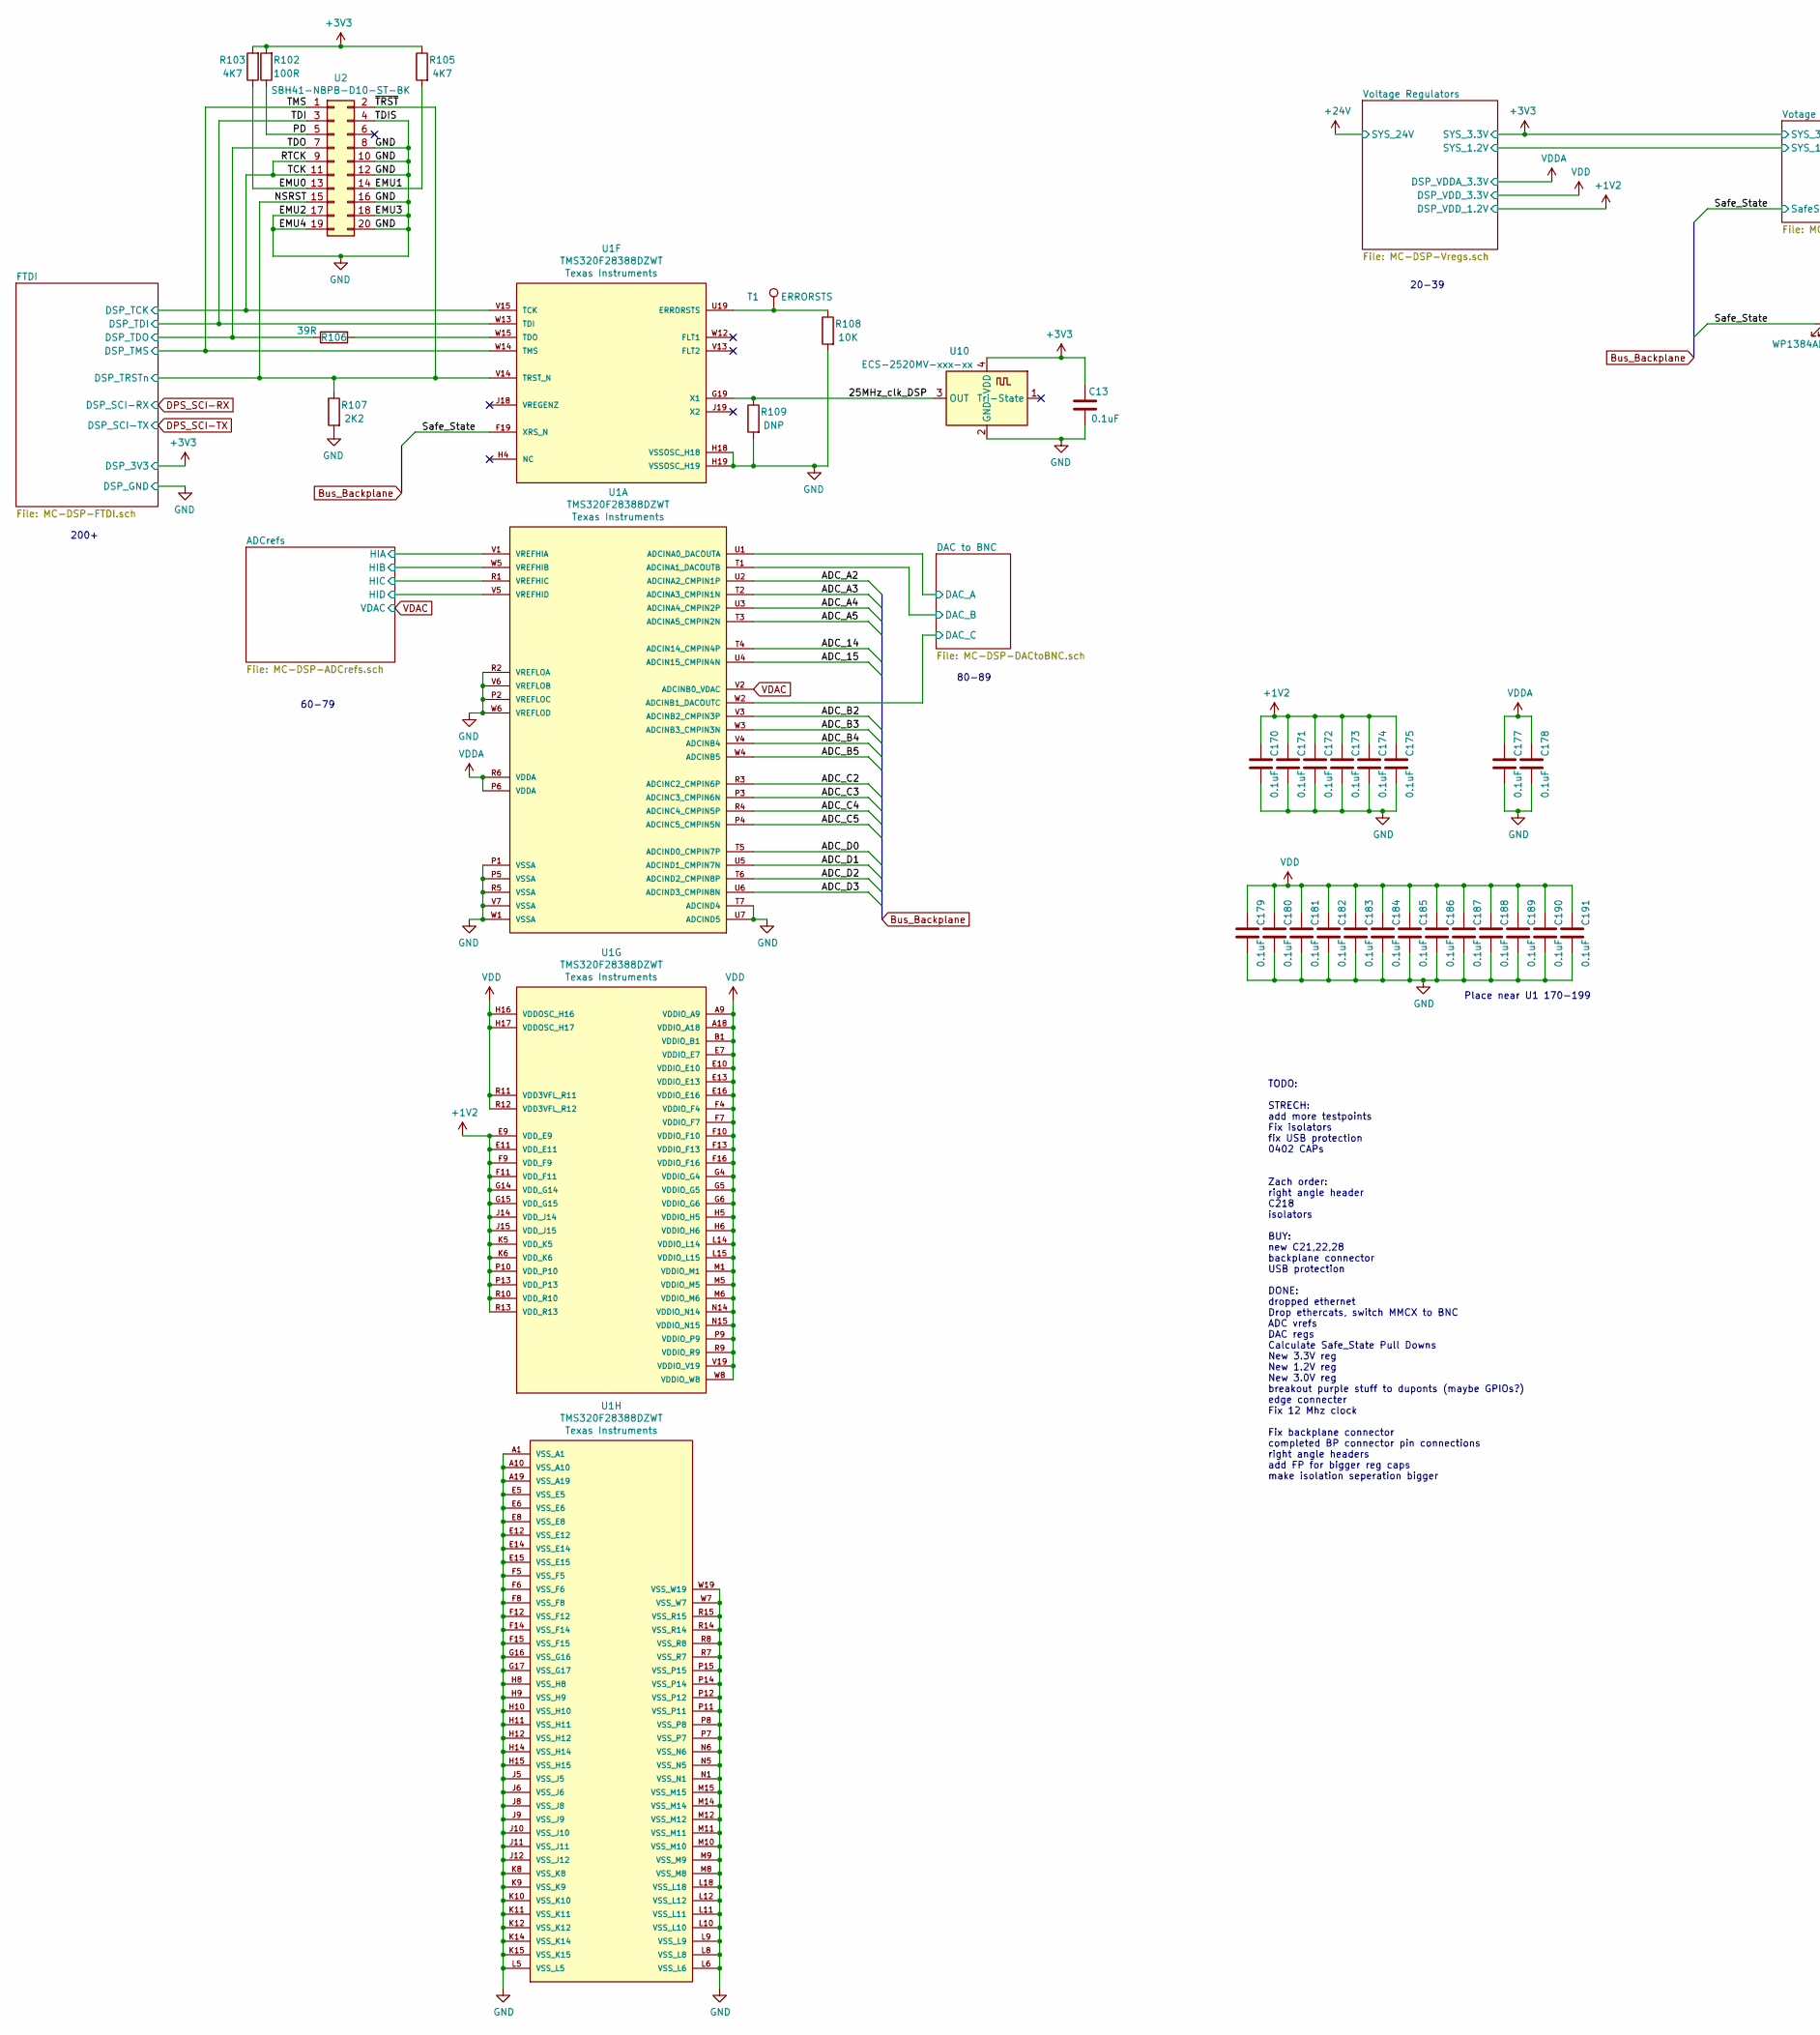
[picture p26: schematic MC-DSP.sch, part in row 1, column 1]

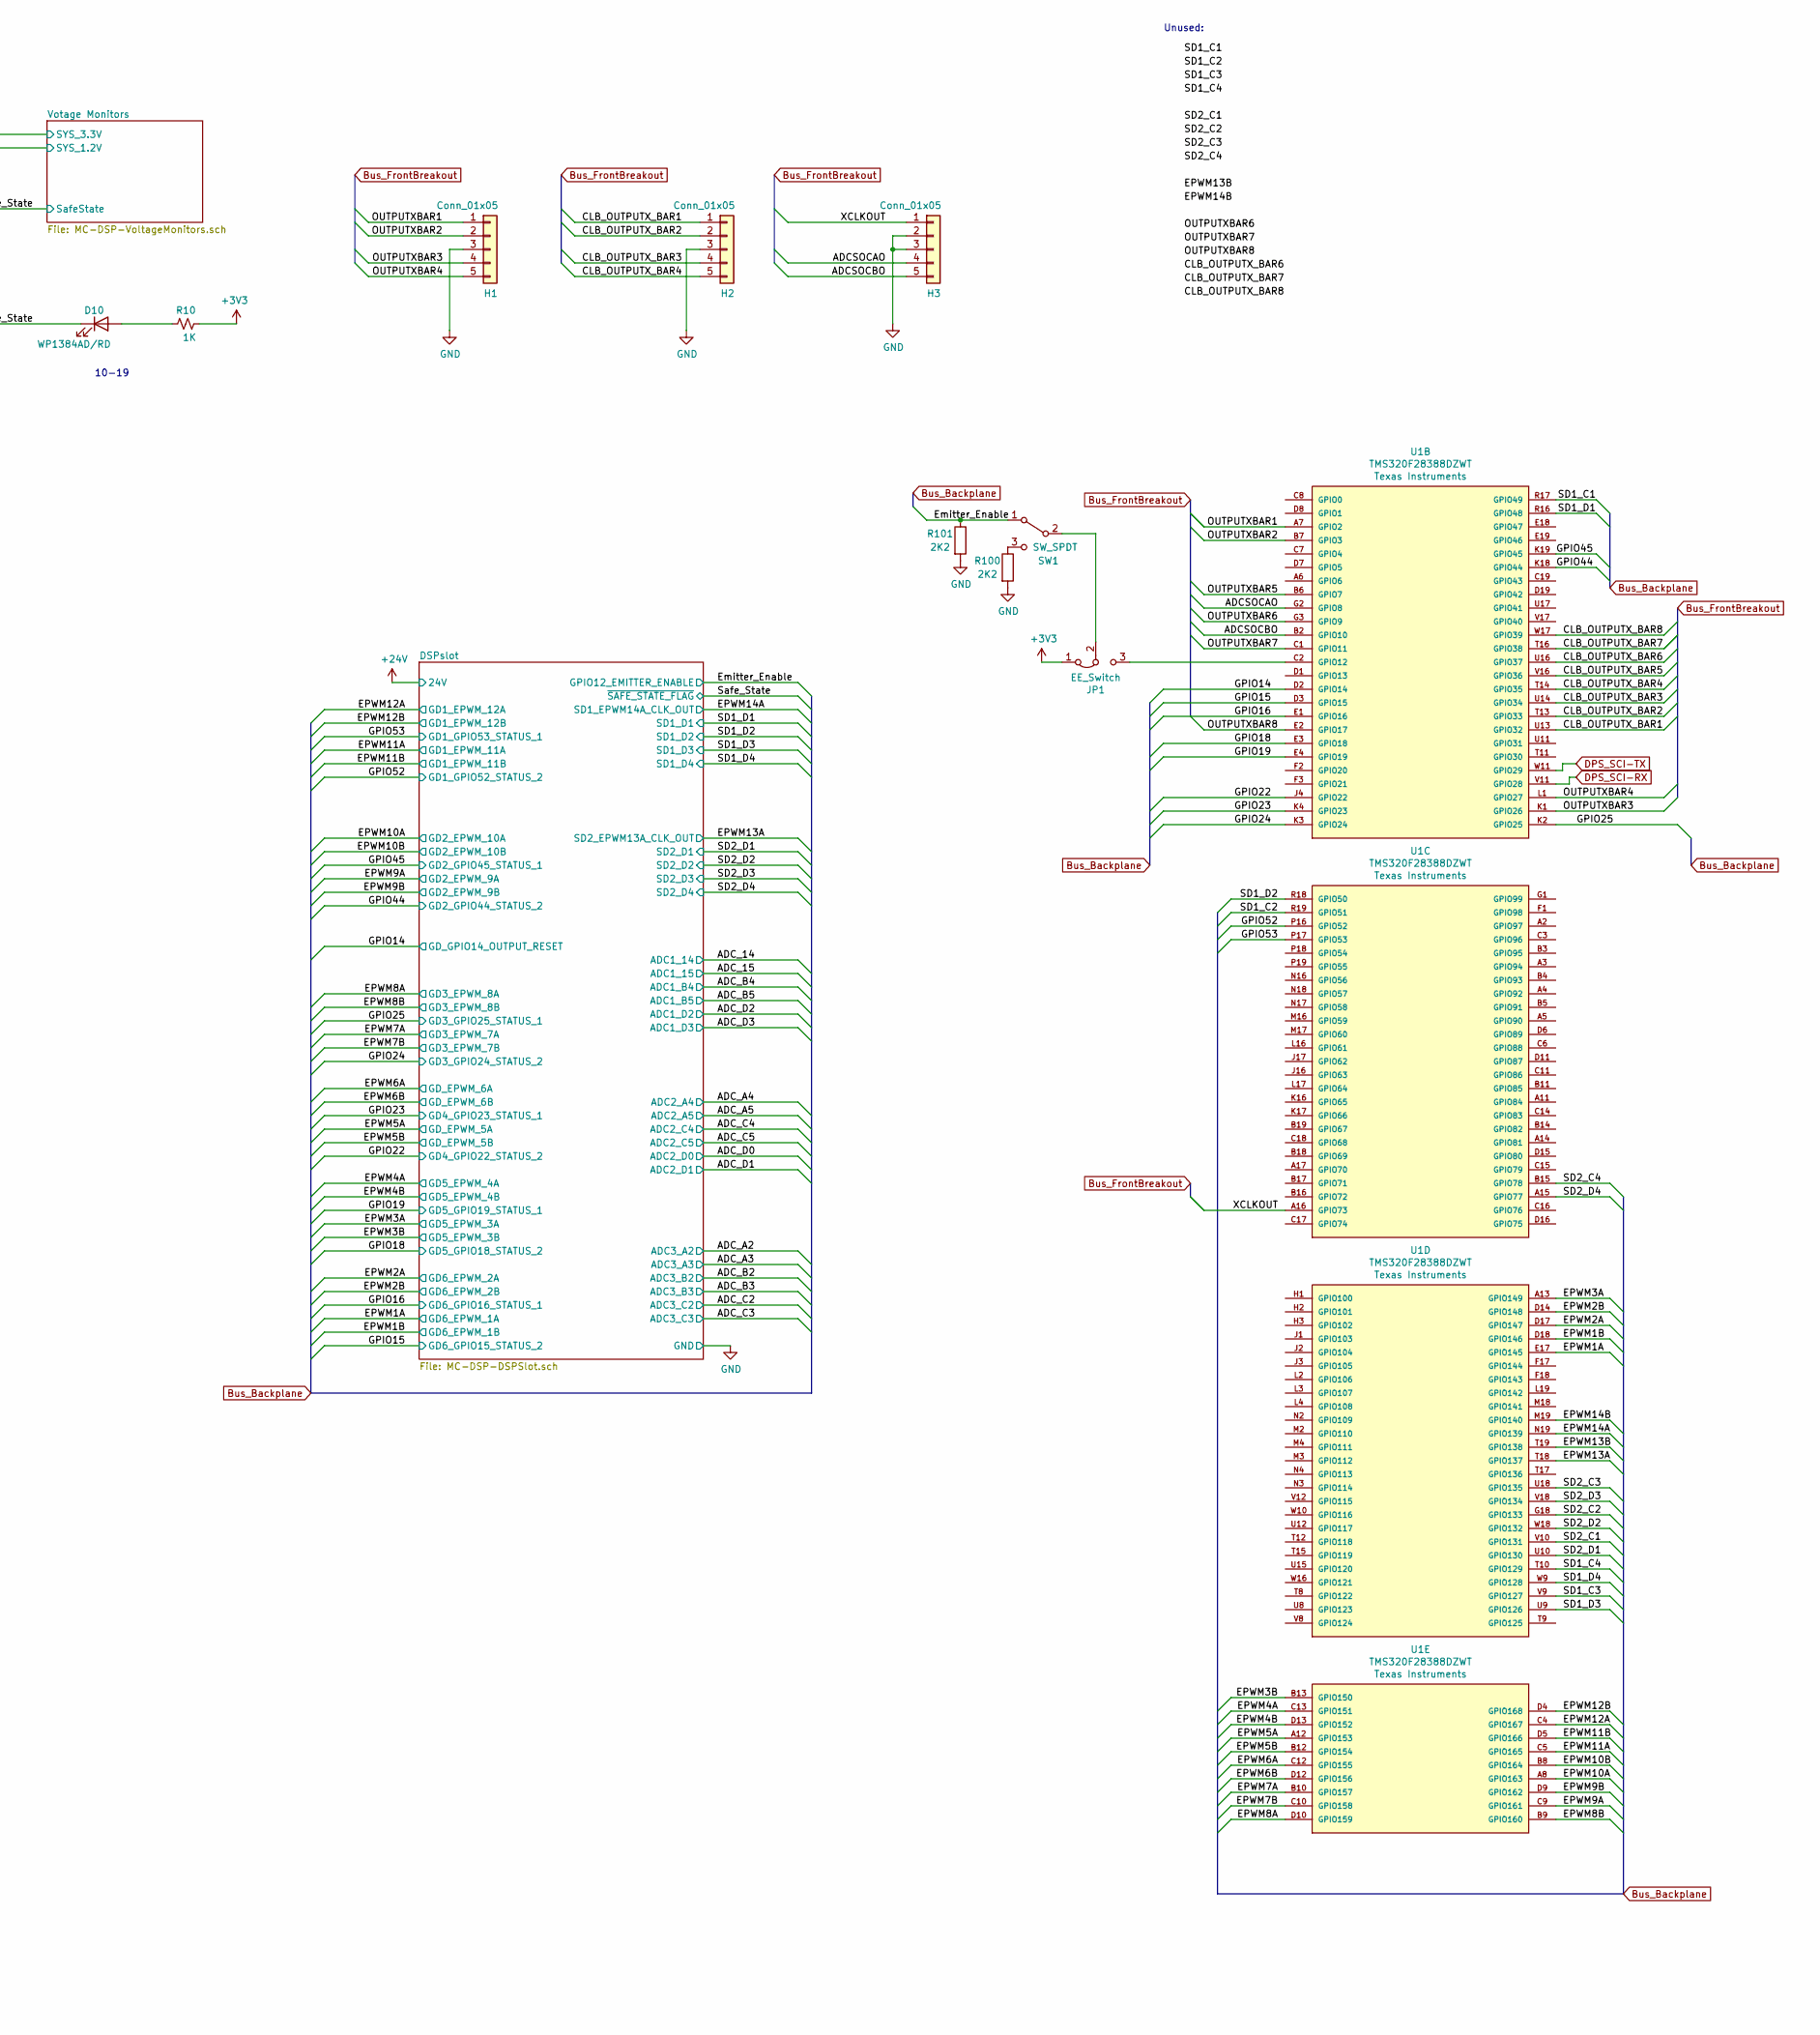
[picture p27: schematic MC-DSP.sch, part in row 1, column 2]

Parts:
C13: 0.1uF; C_0603_1608Metric_Pad1.08x0.95mm_HandSolder
C170, C171, C172, C173, C174, C175, C177, C178, C179, C180, C181, C182, C183, C184, C185, C186, C187, C188, C189, C190, C191: 0.1uF; C_0402_1005Metric_Pad0.74x0.62mm_HandSolder
D10: WP1384AD/RD; LED_D3.0mm
H1, H2, H3: Conn_01x05; PinSocket_1x05_P2.54mm_Vertical
JP1: EE_Switch; PinSocket_1x03_P2.54mm_Vertical
R10: 1K; R_0603_1608Metric_Pad0.98x0.95mm_HandSolder
R100, R101, R107: 2K2; R_0603_1608Metric_Pad0.98x0.95mm_HandSolder
R102: 100R; R_0603_1608Metric_Pad0.98x0.95mm_HandSolder
R103, R105: 4K7; R_0603_1608Metric_Pad0.98x0.95mm_HandSolder
R106: 39R; R_0603_1608Metric_Pad0.98x0.95mm_HandSolder
R108: 10K; R_0603_1608Metric_Pad0.98x0.95mm_HandSolder
R109: DNP; R_0603_1608Metric_Pad0.98x0.95mm_HandSolder
SW1: SW_SPDT; GT12MABE
T1: ERRORSTS; TestPoint_Pad_D1.5mm
U1: TMS320F28388DZWT; BGA337C80P19X19_1600X1600X140N
U2: SBH41-NBPB-D10-ST-BK
U10: ECS-2520MV-xxx-xx; Oscillator_SMD_ECS_2520MV-xxx-xx-4Pin_2.5x2.0mm

Connections:
+1V2: C170.2, C171.2, C172.2, C173.2, C174.2, C175.2, U1.E9 (VDD_E9), U1.E11 (VDD_E11), U1.F9 (VDD_F9), U1.F11 (VDD_F11), U1.G14 (VDD_G14), U1.G15 (VDD_G15), U1.J14 (VDD_J14), U1.J15 (VDD_J15), U1.K5 (VDD_K5), U1.K6 (VDD_K6), U1.P10 (VDD_P10), U1.P13 (VDD_P13), U1.R10 (VDD_R10), U1.R13 (VDD_R13); also elsewhere on the board
+3V3: C13.2, JP1.1 (A), R10.1, R102.2, R103.2, R105.1, U10.4 (VDD); also elsewhere on the board
/25MHz_clk_DSP: R109.1, U1.G19 (X1), U10.3 (OUT)
/ADCSOCAO: H3.4, U1.G2 (GPIO8)
/ADCSOCBO: H3.5, U1.B2 (GPIO10)
/ADC_14: U1.T4 (ADCIN14_CMPIN4P); also elsewhere on the board
/ADC_15: U1.U4 (ADCIN15_CMPIN4N); also elsewhere on the board
/ADC_A2: U1.U2 (ADCINA2_CMPIN1P); also elsewhere on the board
/ADC_A3: U1.T2 (ADCINA3_CMPIN1N); also elsewhere on the board
/ADC_A4: U1.U3 (ADCINA4_CMPIN2P); also elsewhere on the board
/ADC_A5: U1.T3 (ADCINA5_CMPIN2N); also elsewhere on the board
/ADC_B2: U1.V3 (ADCINB2_CMPIN3P); also elsewhere on the board
/ADC_B3: U1.W3 (ADCINB3_CMPIN3N); also elsewhere on the board
/ADC_B4: U1.V4 (ADCINB4); also elsewhere on the board
/ADC_B5: U1.W4 (ADCINB5); also elsewhere on the board
/ADC_C2: U1.R3 (ADCINC2_CMPIN6P); also elsewhere on the board
/ADC_C3: U1.P3 (ADCINC3_CMPIN6N); also elsewhere on the board
/ADC_C4: U1.R4 (ADCINC4_CMPIN5P); also elsewhere on the board
/ADC_C5: U1.P4 (ADCINC5_CMPIN5N); also elsewhere on the board
/ADC_D0: U1.T5 (ADCIND0_CMPIN7P); also elsewhere on the board
/ADC_D1: U1.U5 (ADCIND1_CMPIN7N); also elsewhere on the board
/ADC_D2: U1.T6 (ADCIND2_CMPIN8P); also elsewhere on the board
/ADC_D3: U1.U6 (ADCIND3_CMPIN8N); also elsewhere on the board
/ADCrefs/HIA: U1.V1 (VREFHIA); also elsewhere on the board
/ADCrefs/HIB: U1.W5 (VREFHIB); also elsewhere on the board
/ADCrefs/HIC: U1.R1 (VREFHIC); also elsewhere on the board
/ADCrefs/HID: U1.V5 (VREFHID); also elsewhere on the board
/CLB_OUTPUTX_BAR1: H2.1, U1.U13 (GPIO32)
/CLB_OUTPUTX_BAR2: H2.2, U1.T13 (GPIO33)
/CLB_OUTPUTX_BAR3: H2.4, U1.U14 (GPIO34)
/CLB_OUTPUTX_BAR4: H2.5, U1.T14 (GPIO35)
/CLB_OUTPUTX_BAR5: U1.V16 (GPIO36)
/CLB_OUTPUTX_BAR6: U1.U16 (GPIO37)
/CLB_OUTPUTX_BAR7: U1.T16 (GPIO38)
/CLB_OUTPUTX_BAR8: U1.W17 (GPIO39)
/DAC to BNC/DAC_A: U1.U1 (ADCINA0_DACOUTA); also elsewhere on the board
/DAC to BNC/DAC_B: U1.T1 (ADCINA1_DACOUTB); also elsewhere on the board
/DAC to BNC/DAC_C: U1.W2 (ADCINB1_DACOUTC); also elsewhere on the board
/EMU0: R103.1, U2.13
/EMU1: R105.2, U2.14
/EPWM1A: U1.E17 (GPIO145); also elsewhere on the board
/EPWM1B: U1.D18 (GPIO146); also elsewhere on the board
/EPWM2A: U1.D17 (GPIO147); also elsewhere on the board
/EPWM2B: U1.D14 (GPIO148); also elsewhere on the board
/EPWM3A: U1.A13 (GPIO149); also elsewhere on the board
/EPWM3B: U1.B13 (GPIO150); also elsewhere on the board
/EPWM4A: U1.C13 (GPIO151); also elsewhere on the board
/EPWM4B: U1.D13 (GPIO152); also elsewhere on the board
/EPWM5A: U1.A12 (GPIO153); also elsewhere on the board
/EPWM5B: U1.B12 (GPIO154); also elsewhere on the board
/EPWM6A: U1.C12 (GPIO155); also elsewhere on the board
/EPWM6B: U1.D12 (GPIO156); also elsewhere on the board
/EPWM7A: U1.B10 (GPIO157); also elsewhere on the board
/EPWM7B: U1.C10 (GPIO158); also elsewhere on the board
/EPWM8A: U1.D10 (GPIO159); also elsewhere on the board
/EPWM8B: U1.B9 (GPIO160); also elsewhere on the board
/EPWM9A: U1.C9 (GPIO161); also elsewhere on the board
/EPWM9B: U1.D9 (GPIO162); also elsewhere on the board
/EPWM10A: U1.A8 (GPIO163); also elsewhere on the board
/EPWM10B: U1.B8 (GPIO164); also elsewhere on the board
/EPWM11A: U1.C5 (GPIO165); also elsewhere on the board
/EPWM11B: U1.D5 (GPIO166); also elsewhere on the board
/EPWM12A: U1.C4 (GPIO167); also elsewhere on the board
/EPWM12B: U1.D4 (GPIO168); also elsewhere on the board
/EPWM13A: U1.T18 (GPIO137); also elsewhere on the board
/EPWM13B: U1.T19 (GPIO138)
/EPWM14A: U1.N19 (GPIO139); also elsewhere on the board
/EPWM14B: U1.M19 (GPIO140)
/Emitter_Enable: R101.1, SW1.1 (A); also elsewhere on the board
/GPIO14: U1.D2 (GPIO14); also elsewhere on the board
/GPIO15: U1.D3 (GPIO15); also elsewhere on the board
/GPIO16: U1.E1 (GPIO16); also elsewhere on the board
/GPIO18: U1.E3 (GPIO18); also elsewhere on the board
/GPIO19: U1.E4 (GPIO19); also elsewhere on the board
/GPIO22: U1.J4 (GPIO22); also elsewhere on the board
/GPIO23: U1.K4 (GPIO23); also elsewhere on the board
/GPIO24: U1.K3 (GPIO24); also elsewhere on the board
/GPIO25: U1.K2 (GPIO25); also elsewhere on the board
/GPIO44: U1.K18 (GPIO44); also elsewhere on the board
/GPIO45: U1.K19 (GPIO45); also elsewhere on the board
/GPIO52: U1.P16 (GPIO52); also elsewhere on the board
/GPIO53: U1.P17 (GPIO53); also elsewhere on the board
/NSRST: R107.1, U1.V14 (TRST_N), U2.2, U2.15; also elsewhere on the board
/OUTPUTXBAR1: H1.1, U1.A7 (GPIO2)
/OUTPUTXBAR2: H1.2, U1.B7 (GPIO3)
/OUTPUTXBAR3: H1.4, U1.K1 (GPIO26)
/OUTPUTXBAR4: H1.5, U1.L1 (GPIO27)
/OUTPUTXBAR5: U1.B6 (GPIO7)
/OUTPUTXBAR6: U1.G3 (GPIO9)
/OUTPUTXBAR7: U1.C1 (GPIO11)
/OUTPUTXBAR8: U1.E2 (GPIO17)
/PD: R102.1, U2.5
/RTCK: U1.V15 (TCK), U2.9, U2.11; also elsewhere on the board
/SD1_C1: U1.R17 (GPIO49)
/SD1_C2: U1.R19 (GPIO51)
/SD1_C3: U1.V9 (GPIO127)
/SD1_C4: U1.T10 (GPIO129)
/SD1_D1: U1.R16 (GPIO48); also elsewhere on the board
/SD1_D2: U1.R18 (GPIO50); also elsewhere on the board
/SD1_D3: U1.U9 (GPIO126); also elsewhere on the board
/SD1_D4: U1.W9 (GPIO128); also elsewhere on the board
/SD2_C1: U1.V10 (GPIO131)
/SD2_C2: U1.G18 (GPIO133)
/SD2_C3: U1.U18 (GPIO135)
/SD2_C4: U1.B15 (GPIO78)
/SD2_D1: U1.U10 (GPIO130); also elsewhere on the board
/SD2_D2: U1.W18 (GPIO132); also elsewhere on the board
/SD2_D3: U1.V18 (GPIO134); also elsewhere on the board
/SD2_D4: U1.A15 (GPIO77); also elsewhere on the board
/Safe_State: D10.1 (K), U1.F19 (XRS_N); also elsewhere on the board
/TDI: U1.W13 (TDI), U2.3; also elsewhere on the board
/TDO: R106.1, U2.7; also elsewhere on the board
/TMS: U1.W14 (TMS), U2.1; also elsewhere on the board
/XCLKOUT: H3.1, U1.A16 (GPIO73)
DPS_SCI-RX: U1.V11 (GPIO28); also elsewhere on the board
DPS_SCI-TX: U1.W11 (GPIO29); also elsewhere on the board
GND: C13.1, C170.1, C171.1, C172.1, C173.1, C174.1, C175.1, C177.1, C178.1, C179.1, C180.1, C181.1, C182.1, C183.1, C184.1, C185.1, C186.1, C187.1, C188.1, C189.1, C190.1, C191.1, H1.3, H2.3, H3.2, H3.3, R100.2, R101.2, R107.2, R108.2, R109.2, U1.A1 (VSS_A1), U1.A10 (VSS_A10), U1.A19 (VSS_A19), U1.E5 (VSS_E5), U1.E6 (VSS_E6), U1.E8 (VSS_E8), U1.E12 (VSS_E12), U1.E14 (VSS_E14), U1.E15 (VSS_E15), U1.F5 (VSS_F5), U1.F6 (VSS_F6), U1.F8 (VSS_F8), U1.F12 (VSS_F12), U1.F14 (VSS_F14), U1.F15 (VSS_F15), U1.G16 (VSS_G16), U1.G17 (VSS_G17), U1.H8 (VSS_H8), U1.H9 (VSS_H9), U1.H10 (VSS_H10), U1.H11 (VSS_H11), U1.H12 (VSS_H12), U1.H14 (VSS_H14), U1.H15 (VSS_H15), U1.H18 (VSSOSC_H18), U1.H19 (VSSOSC_H19), U1.J5 (VSS_J5), U1.J6 (VSS_J6), U1.J8 (VSS_J8), U1.J9 (VSS_J9), U1.J10 (VSS_J10), U1.J11 (VSS_J11), U1.J12 (VSS_J12), U1.K8 (VSS_K8), U1.K9 (VSS_K9), U1.K10 (VSS_K10), U1.K11 (VSS_K11), U1.K12 (VSS_K12), U1.K14 (VSS_K14), U1.K15 (VSS_K15), U1.L5 (VSS_L5), U1.L6 (VSS_L6), U1.L8 (VSS_L8), U1.L9 (VSS_L9), U1.L10 (VSS_L10), U1.L11 (VSS_L11), U1.L12 (VSS_L12), U1.L18 (VSS_L18), U1.M8 (VSS_M8), U1.M9 (VSS_M9), U1.M10 (VSS_M10), U1.M11 (VSS_M11), U1.M12 (VSS_M12), U1.M14 (VSS_M14), U1.M15 (VSS_M15), U1.N1 (VSS_N1), U1.N5 (VSS_N5), U1.N6 (VSS_N6), U1.P1 (VSSA), U1.P2 (VREFLOC), U1.P5 (VSSA), U1.P7 (VSS_P7), U1.P8 (VSS_P8), U1.P11 (VSS_P11), U1.P12 (VSS_P12), U1.P14 (VSS_P14), U1.P15 (VSS_P15), U1.R2 (VREFLOA), U1.R5 (VSSA), U1.R7 (VSS_R7), U1.R8 (VSS_R8), U1.R14 (VSS_R14), U1.R15 (VSS_R15), U1.T7 (ADCIND4), U1.U7 (ADCIND5), U1.V6 (VREFLOB), U1.V7 (VSSA), U1.W1 (VSSA), U1.W6 (VREFLOD), U1.W7 (VSS_W7), U1.W19 (VSS_W19), U2.4, U2.8, U2.10, U2.12, U2.16, U2.17, U2.18, U2.19, U2.20, U10.2 (GND); also elsewhere on the board
unnamed: D10.2 (A), R10.2
unnamed: JP1.2 (C), SW1.2 (B)
unnamed: JP1.3 (B), U1.C2 (GPIO12)
unnamed: R100.1, SW1.3 (C)
unnamed: R106.2, U1.W15 (TDO)
unnamed: R108.1, T1.1, U1.U19 (ERRORSTS)
VDAC: U1.V2 (ADCINB0_VDAC); also elsewhere on the board
VDD: C179.2, C180.2, C181.2, C182.2, C183.2, C184.2, C185.2, C186.2, C187.2, C188.2, C189.2, C190.2, C191.2, U1.A9 (VDDIO_A9), U1.A18 (VDDIO_A18), U1.B1 (VDDIO_B1), U1.E7 (VDDIO_E7), U1.E10 (VDDIO_E10), U1.E13 (VDDIO_E13), U1.E16 (VDDIO_E16), U1.F4 (VDDIO_F4), U1.F7 (VDDIO_F7), U1.F10 (VDDIO_F10), U1.F13 (VDDIO_F13), U1.F16 (VDDIO_F16), U1.G4 (VDDIO_G4), U1.G5 (VDDIO_G5), U1.G6 (VDDIO_G6), U1.H5 (VDDIO_H5), U1.H6 (VDDIO_H6), U1.H16 (VDDOSC_H16), U1.H17 (VDDOSC_H17), U1.L14 (VDDIO_L14), U1.L15 (VDDIO_L15), U1.M1 (VDDIO_M1), U1.M5 (VDDIO_M5), U1.M6 (VDDIO_M6), U1.N14 (VDDIO_N14), U1.N15 (VDDIO_N15), U1.P9 (VDDIO_P9), U1.R9 (VDDIO_R9), U1.R11 (VDD3VFL_R11), U1.R12 (VDD3VFL_R12), U1.V19 (VDDIO_V19), U1.W8 (VDDIO_W8); also elsewhere on the board
VDDA: C177.2, C178.2, U1.P6 (VDDA), U1.R6 (VDDA); also elsewhere on the board

Notes on the sheet:
60-79
80-89
200+
10-19
20-39
Place near U1 170-199
TODO: STRECH: add more testpoints Fix isolators fix USB protection 0402 CAPs Zach order: right angle header C218 isolators BUY: new C21,22,28 backplane connector USB protection DONE: dropped ethernet Drop ethercats, switch MMCX to BNC ADC vrefs DAC regs Calculate Safe_State Pull Downs New 3.3V reg 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
Unused:

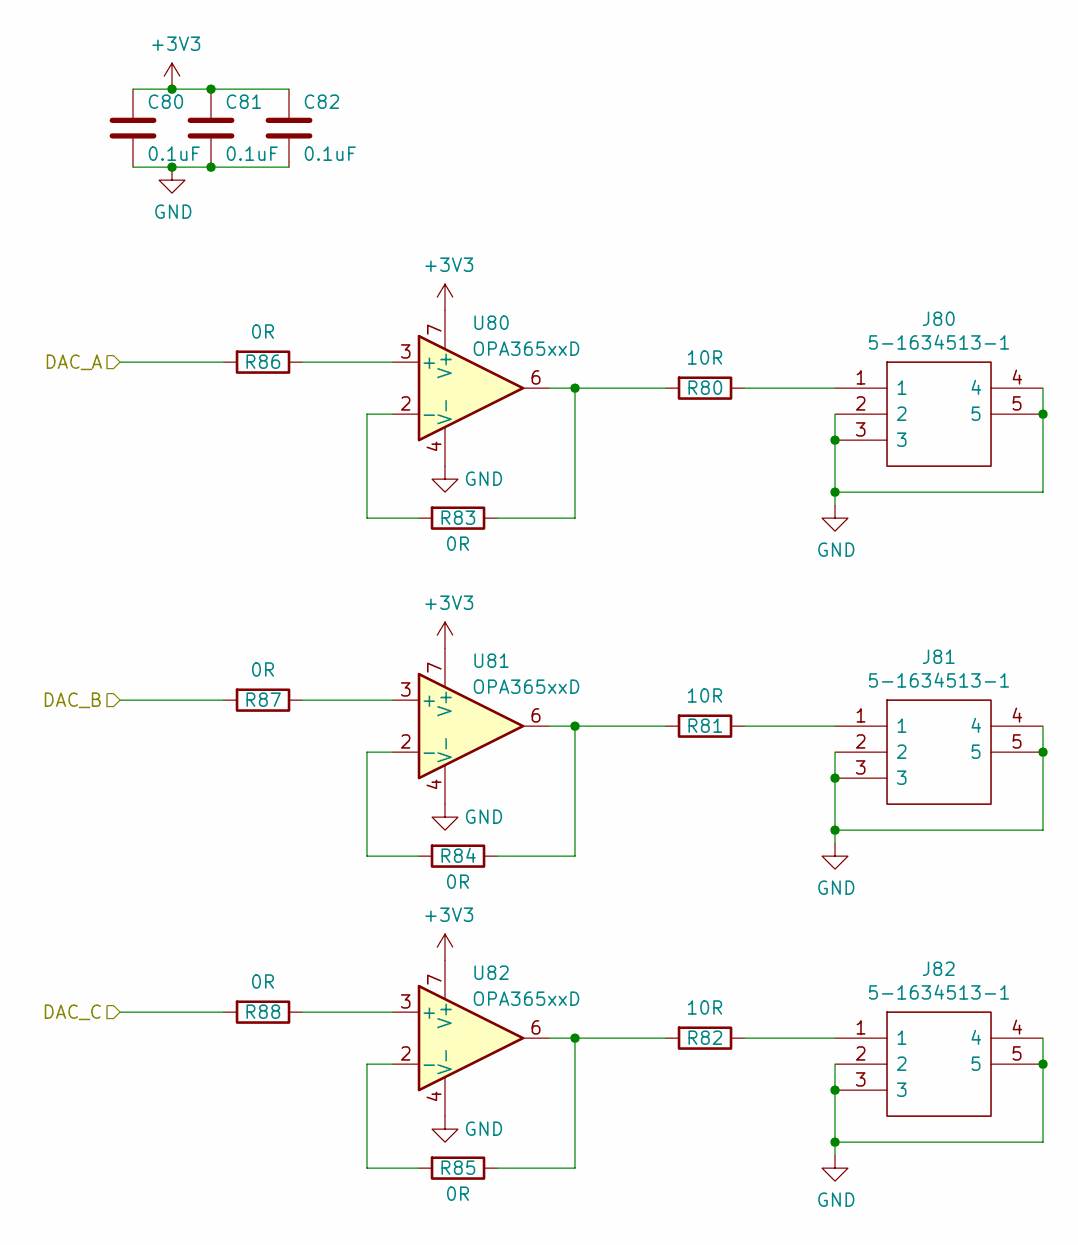
[picture p28: schematic MC-DSP-DACtoBNC.sch]

Parts:
C80, C81, C82: 0.1uF; C_0603_1608Metric_Pad1.08x0.95mm_HandSolder
J80, J81, J82: 5-1634513-1; 516345131; Manufacturer_Part_Number 5-1634513-1; Mouser Part Number 571-5-1634513-1
R80, R81, R82: 10R; R_0603_1608Metric_Pad0.98x0.95mm_HandSolder
R83, R84, R85, R86, R87, R88: 0R; R_0603_1608Metric_Pad0.98x0.95mm_HandSolder
U80, U81, U82: OPA365xxD; SOIC-8_3.9x4.9mm_P1.27mm

Connections:
+3V3: C80.2, C81.2, C82.2, U80.7 (V+), U81.7 (V+), U82.7 (V+); also elsewhere on the board
/DAC to BNC/DAC_A: R86.2; also elsewhere on the board
/DAC to BNC/DAC_B: R87.2; also elsewhere on the board
/DAC to BNC/DAC_C: R88.2; also elsewhere on the board
GND: C80.1, C81.1, C82.1, J80.2, J80.3, J80.4, J80.5, J81.2, J81.3, J81.4, J81.5, J82.2, J82.3, J82.4, J82.5, U80.4 (V-), U81.4 (V-), U82.4 (V-); also elsewhere on the board
unnamed: J80.1, R80.1
unnamed: J81.1, R81.1
unnamed: J82.1, R82.1
unnamed: R80.2, R83.1, U80.6
unnamed: R81.2, R84.1, U81.6
unnamed: R82.2, R85.1, U82.6
unnamed: R83.2, U80.2 (-)
unnamed: R84.2, U81.2 (-)
unnamed: R85.2, U82.2 (-)
unnamed: R86.1, U80.3 (+)
unnamed: R87.1, U81.3 (+)
unnamed: R88.1, U82.3 (+)

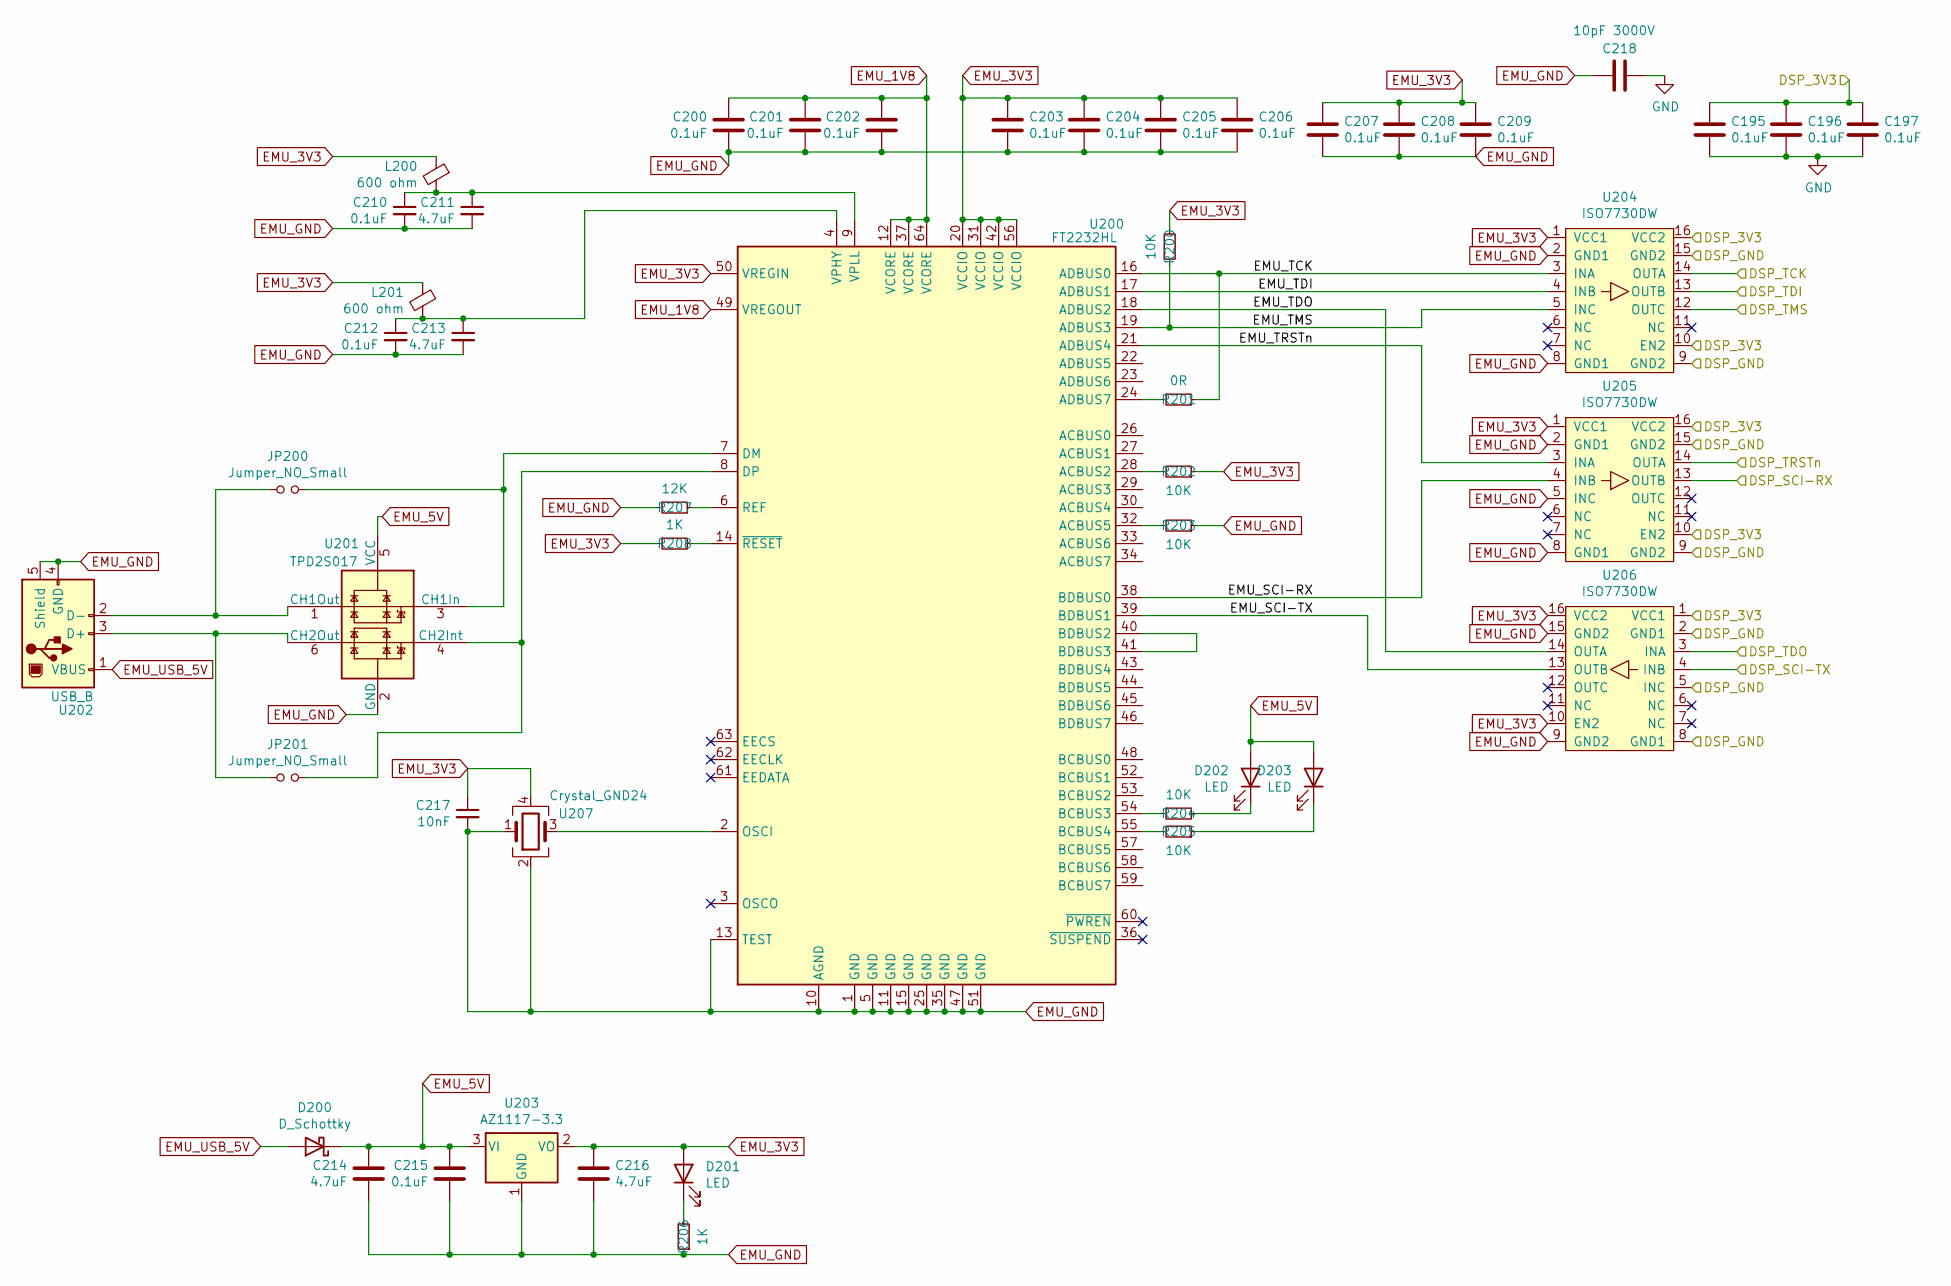
[picture p29: schematic MC-DSP-FTDI.sch]

Parts:
C195, C196, C197, C200, C201, C202, C203, C204, C205, C206, C207, C208, C209, C210, C212, C215: 0.1uF; C_0603_1608Metric_Pad1.08x0.95mm_HandSolder
C211, C213, C214, C216: 4.7uF; C_0603_1608Metric_Pad1.08x0.95mm_HandSolder
C217: 10nF; C_0603_1608Metric_Pad1.08x0.95mm_HandSolder
C218: 10pF 3000V; C_1812_4532Metric_Pad1.57x3.40mm_HandSolder
D200: D_Schottky; D_SMF
D201, D202, D203: LED; LED_D3.0mm
JP200, JP201: Jumper_NO_Small; SolderJumper-2_P1.3mm_Open_RoundedPad1.0x1.5mm
L200, L201: 600 ohm; L_0805_2012Metric_Pad1.05x1.20mm_HandSolder
R200, R202, R203, R204, R205: 10K; R_0603_1608Metric_Pad0.98x0.95mm_HandSolder
R201: 0R; R_0603_1608Metric_Pad0.98x0.95mm_HandSolder
R206, R208: 1K; R_0603_1608Metric_Pad0.98x0.95mm_HandSolder
R207: 12K; R_0603_1608Metric_Pad0.98x0.95mm_HandSolder
U200: FT2232HL; LQFP-64_10x10mm_P0.5mm
U201: TPD2S017; SOT-23-6
U202: USB_B; USB_B_OST_USB-B1HSxx_Horizontal
U203: AZ1117-3.3; SOT-89-3_Handsoldering
U204, U205, U206: ISO7730DW; SOIC-16W_7.5x10.3mm_P1.27mm
U207: Crystal_GND24; Oscillator_SMD_TXC_7C-4Pin_5.0x3.2mm_HandSoldering

Connections:
+3V3: C195.1, C196.1, C197.1, U204.10 (EN2), U204.16 (VCC2), U205.10 (EN2), U205.16 (VCC2), U206.1 (VCC1); also elsewhere on the board
/FTDI/EMU_SCI-RX: U200.38 (BDBUS0), U205.4 (INB)
/FTDI/EMU_SCI-TX: U200.39 (BDBUS1), U206.13 (OUTB)
/FTDI/EMU_TCK: R201.2, U200.16 (ADBUS0), U204.3 (INA)
/FTDI/EMU_TDI: U200.17 (ADBUS1), U204.4 (INB)
/FTDI/EMU_TDO: U200.18 (ADBUS2), U206.14 (OUTA)
/FTDI/EMU_TMS: R200.1, U200.19 (ADBUS3), U204.5 (INC)
/FTDI/EMU_TRSTn: U200.21 (ADBUS4), U205.3 (INA)
/NSRST: U205.14 (OUTA); also elsewhere on the board
/RTCK: U204.14 (OUTA); also elsewhere on the board
/TDI: U204.13 (OUTB); also elsewhere on the board
/TDO: U206.3 (INA); also elsewhere on the board
/TMS: U204.12 (OUTC); also elsewhere on the board
DPS_SCI-RX: U205.13 (OUTB); also elsewhere on the board
DPS_SCI-TX: U206.4 (INB); also elsewhere on the board
EMU_1V8: C200.1, C201.1, C202.1, U200.12 (VCORE), U200.37 (VCORE), U200.49 (VREGOUT), U200.64 (VCORE)
EMU_3V3: C203.1, C204.1, C205.1, C206.1, C207.1, C208.1, C209.1, C216.1, C217.1, D201.2 (A), L200.1, L201.1, R200.2, R202.1, R208.1, U200.20 (VCCIO), U200.31 (VCCIO), U200.42 (VCCIO), U200.50 (VREGIN), U200.56 (VCCIO), U203.2 (VO), U204.1 (VCC1), U205.1 (VCC1), U206.10 (EN2), U206.16 (VCC2), U207.4
EMU_5V: C214.1, C215.1, D200.1 (K), D202.2 (A), D203.2 (A), U201.5 (VCC), U203.3 (VI)
EMU_GND: C200.2, C201.2, C202.2, C203.2, C204.2, C205.2, C206.2, C207.2, C208.2, C209.2, C210.2, C211.2, C212.2, C213.2, C214.2, C215.2, C216.2, C217.2, C218.1, R203.1, R206.1, R207.1, U200.1 (GND), U200.5 (GND), U200.10 (AGND), U200.11 (GND), U200.13 (TEST), U200.15 (GND), U200.25 (GND), U200.35 (GND), U200.47 (GND), U200.51 (GND), U201.2 (GND), U202.4 (GND), U202.5 (Shield), U203.1 (GND), U204.2 (GND1), U204.8 (GND1), U205.2 (GND1), U205.5 (INC), U205.8 (GND1), U206.9 (GND2), U206.15 (GND2), U207.1, U207.2
EMU_USB_5V: D200.2 (A), U202.1 (VBUS)
GND: C195.2, C196.2, C197.2, C218.2, U204.9 (GND2), U204.15 (GND2), U205.9 (GND2), U205.15 (GND2), U206.2 (GND1), U206.5 (INC), U206.8 (GND1); also elsewhere on the board
unnamed: C210.1, C211.1, L200.2, U200.9 (VPLL)
unnamed: C212.1, C213.1, L201.2, U200.4 (VPHY)
unnamed: D201.1 (K), R206.2
unnamed: D202.1 (K), R204.2
unnamed: D203.1 (K), R205.1
unnamed: JP200.1, U201.1 (CH1Out), U202.2 (D-)
unnamed: JP200.2, U200.7 (DM), U201.3 (CH1In)
unnamed: JP201.1, U201.6 (CH2Out), U202.3 (D+)
unnamed: JP201.2, U200.8 (DP), U201.4 (CH2Int)
unnamed: R201.1, U200.24 (ADBUS7)
unnamed: R202.2, U200.28 (ACBUS2)
unnamed: R203.2, U200.32 (ACBUS5)
unnamed: R204.1, U200.54 (BCBUS3)
unnamed: R205.2, U200.55 (BCBUS4)
unnamed: R207.2, U200.6 (REF)
unnamed: R208.2, U200.14 (~RESET)
unnamed: U200.2 (OSCI), U207.3
unnamed: U200.40 (BDBUS2), U200.41 (BDBUS3)
