zwmurray23/ncsu-freedm-srdes-21/MC-DSP/MC-DSP.kicad_pcb

## KiCad design MC-DSP/MC-DSP.kicad_pcb (continued)

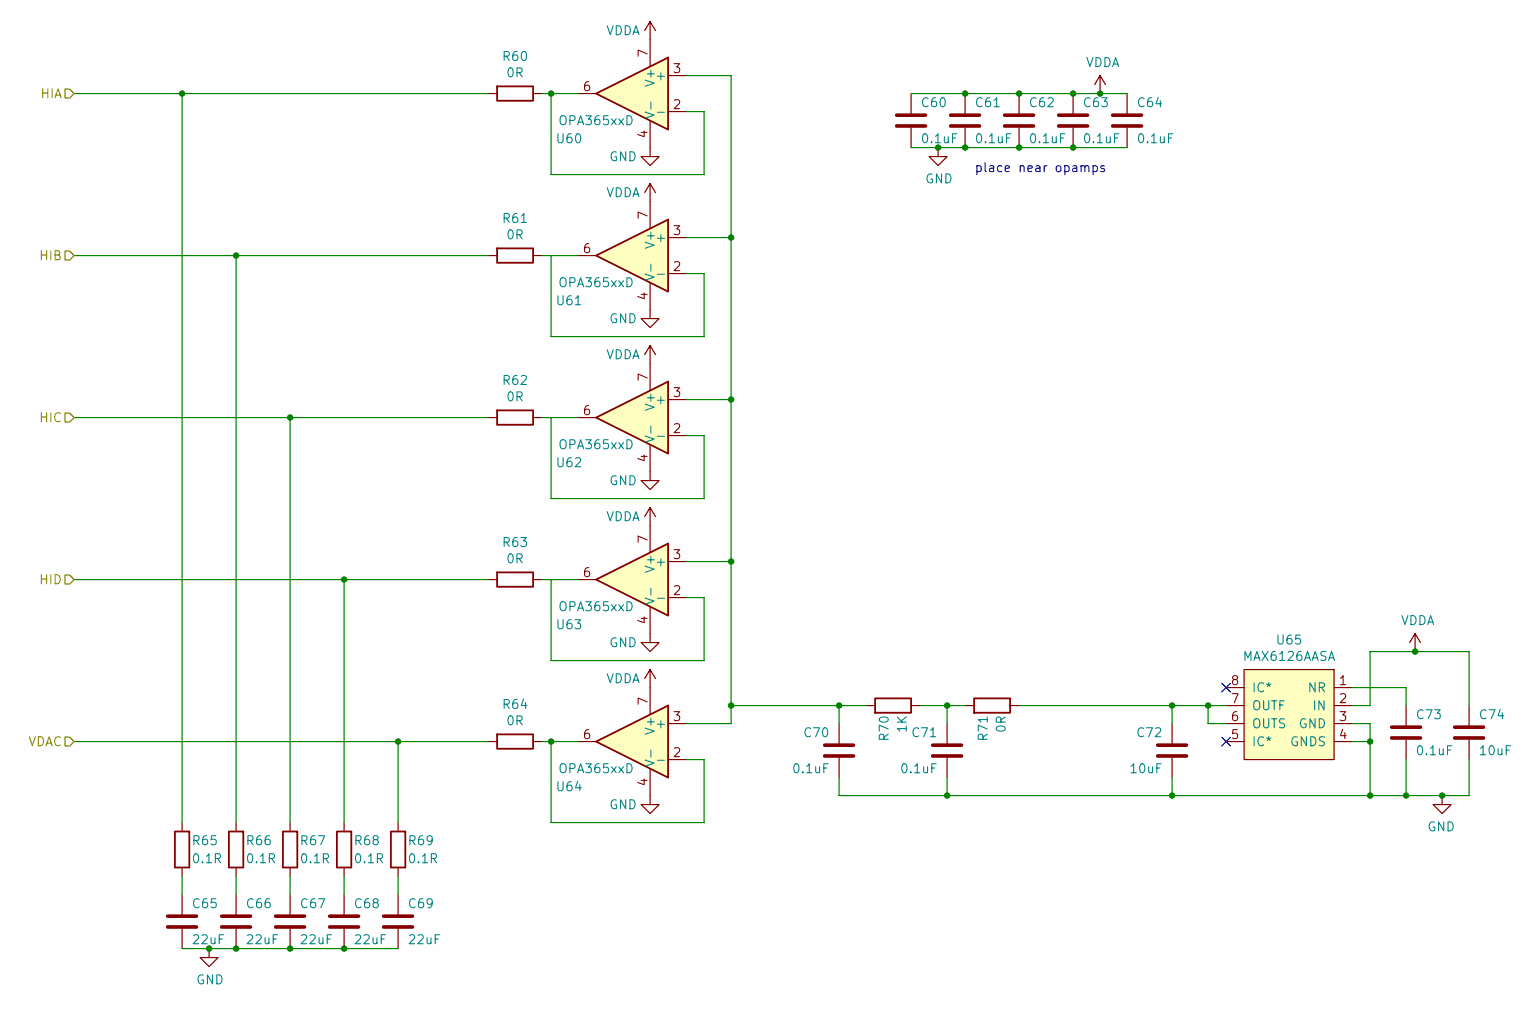
[picture p30: schematic MC-DSP-ADCrefs.sch]

Parts:
C60, C61, C62, C63, C64, C70, C71, C73: 0.1uF; C_0603_1608Metric_Pad1.08x0.95mm_HandSolder
C65, C66, C67, C68, C69: 22uF; C_0603_1608Metric_Pad1.08x0.95mm_HandSolder
C72, C74: 10uF; C_0603_1608Metric_Pad1.08x0.95mm_HandSolder
R60, R61, R62, R63, R64, R71: 0R; R_0603_1608Metric_Pad0.98x0.95mm_HandSolder
R65, R66, R67, R68, R69: 0.1R; R_0603_1608Metric_Pad0.98x0.95mm_HandSolder
R70: 1K; R_0603_1608Metric_Pad0.98x0.95mm_HandSolder
U60, U61, U62, U63, U64: OPA365xxD; SOIC-8_3.9x4.9mm_P1.27mm
U65: MAX6126AASA; SOIC-8_3.9x4.9mm_P1.27mm

Connections:
/ADCrefs/HIA: R60.2, R65.2; also elsewhere on the board
/ADCrefs/HIB: R61.2, R66.2; also elsewhere on the board
/ADCrefs/HIC: R62.2, R67.2; also elsewhere on the board
/ADCrefs/HID: R63.2, R68.2; also elsewhere on the board
GND: C60.1, C61.1, C62.1, C63.1, C64.1, C65.1, C66.1, C67.1, C68.1, C69.1, C70.1, C71.1, C72.1, C73.1, C74.1, U60.4 (V-), U61.4 (V-), U62.4 (V-), U63.4 (V-), U64.4 (V-), U65.3 (GND), U65.4 (GNDS); also elsewhere on the board
unnamed: C65.2, R65.1
unnamed: C66.2, R66.1
unnamed: C67.2, R67.1
unnamed: C68.2, R68.1
unnamed: C69.2, R69.1
unnamed: C70.2, R70.2, U60.3 (+), U61.3 (+), U62.3 (+), U63.3 (+), U64.3 (+)
unnamed: C71.2, R70.1, R71.2
unnamed: C72.2, R71.1, U65.6 (OUTS), U65.7 (OUTF)
unnamed: C73.2, U65.1 (NR)
unnamed: R60.1, U60.2 (-), U60.6
unnamed: R61.1, U61.6
unnamed: R62.1, U62.6
unnamed: R63.1, U63.6
unnamed: R64.1, U64.2 (-), U64.6
VDAC: R64.2, R69.2; also elsewhere on the board
VDDA: C60.2, C61.2, C62.2, C63.2, C64.2, C74.2, U60.7 (V+), U61.7 (V+), U62.7 (V+), U63.7 (V+), U64.7 (V+), U65.2 (IN); also elsewhere on the board

Notes on the sheet:
place near opamps

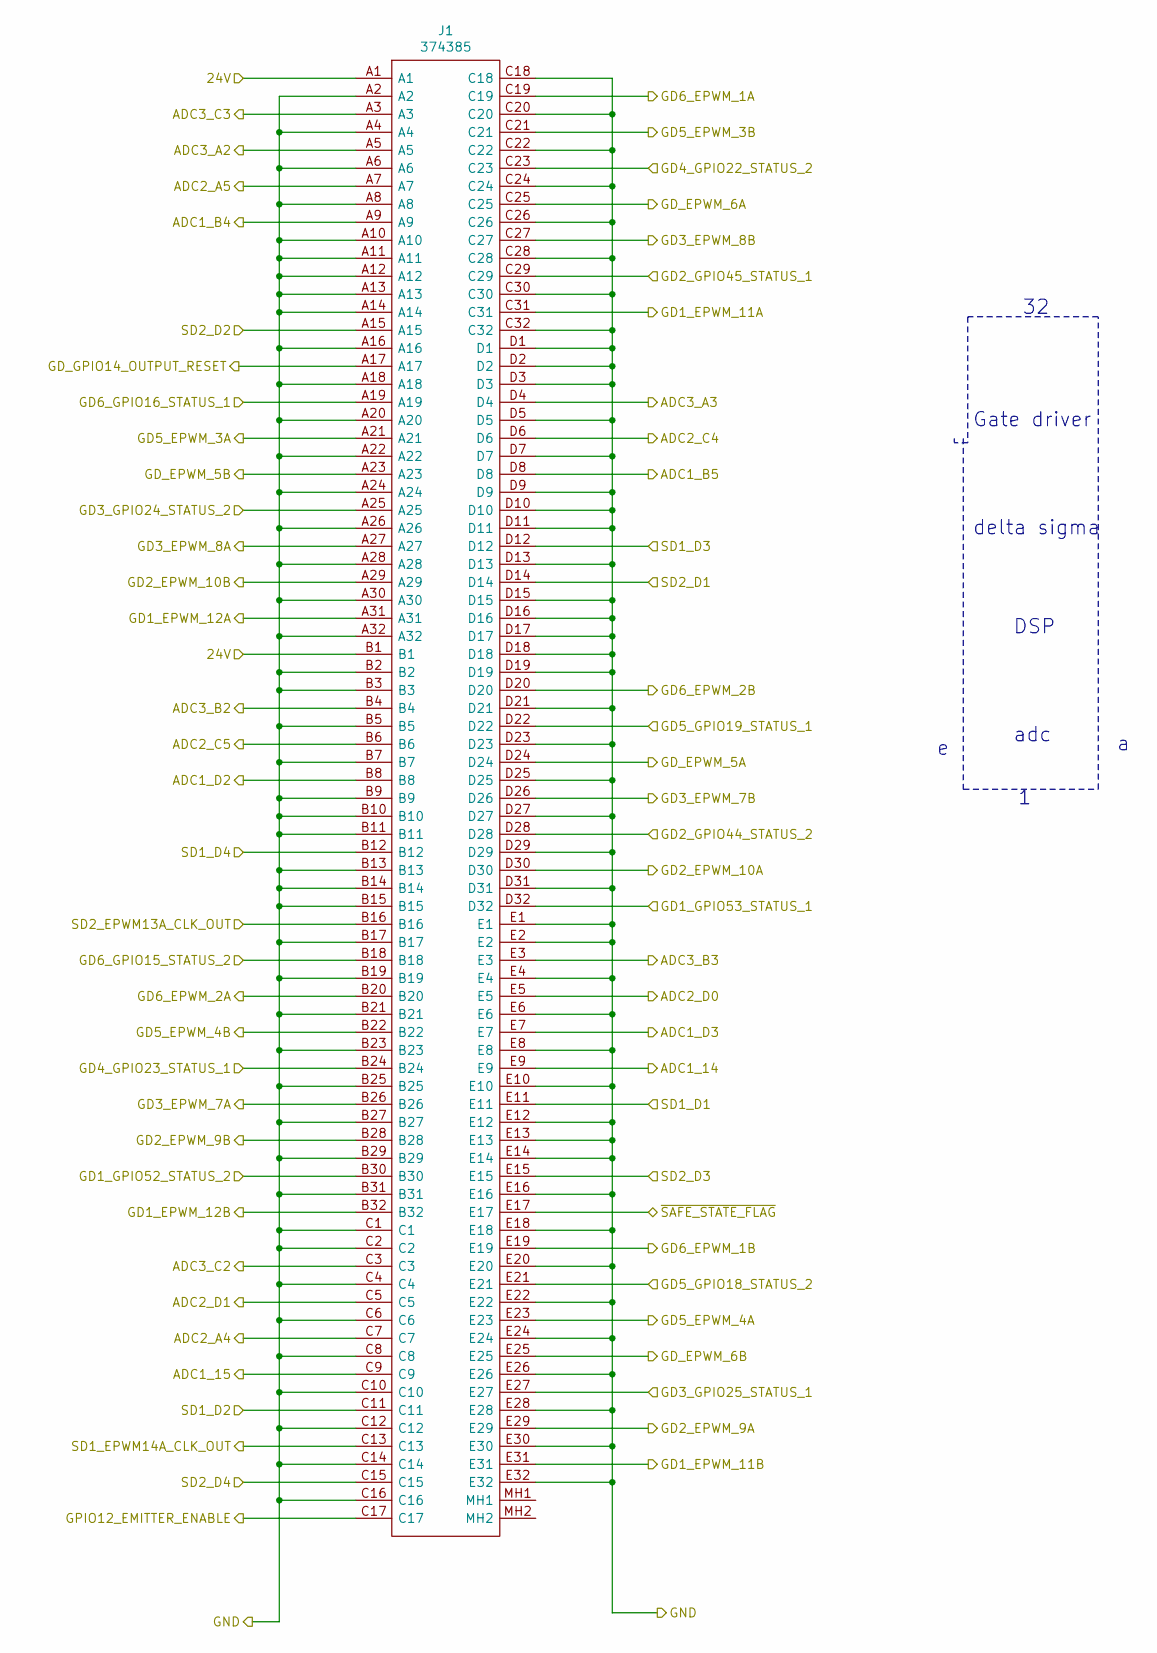
[picture p31: schematic MC-DSP-DSPSlot.sch]

Parts:
J1: 374385; Mouser Part Number 305-374385

Connections:
+24V: J1.A1, J1.B1; also elsewhere on the board
/ADC_14: J1.E9; also elsewhere on the board
/ADC_15: J1.C9; also elsewhere on the board
/ADC_A2: J1.A5; also elsewhere on the board
/ADC_A3: J1.D4; also elsewhere on the board
/ADC_A4: J1.C7; also elsewhere on the board
/ADC_A5: J1.A7; also elsewhere on the board
/ADC_B2: J1.B4; also elsewhere on the board
/ADC_B3: J1.E3; also elsewhere on the board
/ADC_B4: J1.A9; also elsewhere on the board
/ADC_B5: J1.D8; also elsewhere on the board
/ADC_C2: J1.C3; also elsewhere on the board
/ADC_C3: J1.A3; also elsewhere on the board
/ADC_C4: J1.D6; also elsewhere on the board
/ADC_C5: J1.B6; also elsewhere on the board
/ADC_D0: J1.E5; also elsewhere on the board
/ADC_D1: J1.C5; also elsewhere on the board
/ADC_D2: J1.B8; also elsewhere on the board
/ADC_D3: J1.E7; also elsewhere on the board
/EPWM1A: J1.C19; also elsewhere on the board
/EPWM1B: J1.E19; also elsewhere on the board
/EPWM2A: J1.B20; also elsewhere on the board
/EPWM2B: J1.D20; also elsewhere on the board
/EPWM3A: J1.A21; also elsewhere on the board
/EPWM3B: J1.C21; also elsewhere on the board
/EPWM4A: J1.E23; also elsewhere on the board
/EPWM4B: J1.B22; also elsewhere on the board
/EPWM5A: J1.D24; also elsewhere on the board
/EPWM5B: J1.A23; also elsewhere on the board
/EPWM6A: J1.C25; also elsewhere on the board
/EPWM6B: J1.E25; also elsewhere on the board
/EPWM7A: J1.B26; also elsewhere on the board
/EPWM7B: J1.D26; also elsewhere on the board
/EPWM8A: J1.A27; also elsewhere on the board
/EPWM8B: J1.C27; also elsewhere on the board
/EPWM9A: J1.E29; also elsewhere on the board
/EPWM9B: J1.B28; also elsewhere on the board
/EPWM10A: J1.D30; also elsewhere on the board
/EPWM10B: J1.A29; also elsewhere on the board
/EPWM11A: J1.C31; also elsewhere on the board
/EPWM11B: J1.E31; also elsewhere on the board
/EPWM12A: J1.A31; also elsewhere on the board
/EPWM12B: J1.B32; also elsewhere on the board
/EPWM13A: J1.B16; also elsewhere on the board
/EPWM14A: J1.C13; also elsewhere on the board
/Emitter_Enable: J1.C17; also elsewhere on the board
/GPIO14: J1.A17; also elsewhere on the board
/GPIO15: J1.B18; also elsewhere on the board
/GPIO16: J1.A19; also elsewhere on the board
/GPIO18: J1.E21; also elsewhere on the board
/GPIO19: J1.D22; also elsewhere on the board
/GPIO22: J1.C23; also elsewhere on the board
/GPIO23: J1.B24; also elsewhere on the board
/GPIO24: J1.A25; also elsewhere on the board
/GPIO25: J1.E27; also elsewhere on the board
/GPIO44: J1.D28; also elsewhere on the board
/GPIO45: J1.C29; also elsewhere on the board
/GPIO52: J1.B30; also elsewhere on the board
/GPIO53: J1.D32; also elsewhere on the board
/SD1_D1: J1.E11; also elsewhere on the board
/SD1_D2: J1.C11; also elsewhere on the board
/SD1_D3: J1.D12; also elsewhere on the board
/SD1_D4: J1.B12; also elsewhere on the board
/SD2_D1: J1.D14; also elsewhere on the board
/SD2_D2: J1.A15; also elsewhere on the board
/SD2_D3: J1.E15; also elsewhere on the board
/SD2_D4: J1.C15; also elsewhere on the board
/Safe_State: J1.E17; also elsewhere on the board
GND: J1.A2, J1.A4, J1.A6, J1.A8, J1.A10, J1.A11, J1.A12, J1.A13, J1.A14, J1.A16, J1.A18, J1.A20, J1.A22, J1.A24, J1.A26, J1.A28, J1.A30, J1.A32, J1.B2, J1.B3, J1.B5, J1.B7, J1.B9, J1.B10, J1.B11, J1.B13, J1.B14, J1.B15, J1.B17, J1.B19, J1.B21, J1.B23, J1.B25, J1.B27, J1.B29, J1.B31, J1.C1, J1.C2, J1.C4, J1.C6, J1.C8, J1.C10, J1.C12, J1.C14, J1.C16, J1.C18, J1.C20, J1.C22, J1.C24, J1.C26, J1.C28, J1.C30, J1.C32, J1.D1, J1.D2, J1.D3, J1.D5, J1.D7, J1.D9, J1.D10, J1.D11, J1.D13, J1.D15, J1.D16, J1.D17, J1.D18, J1.D19, J1.D21, J1.D23, J1.D25, J1.D27, J1.D29, J1.D31, J1.E1, J1.E2, J1.E4, J1.E6, J1.E8, J1.E10, J1.E12, J1.E13, J1.E14, J1.E16, J1.E18, J1.E20, J1.E22, J1.E24, J1.E26, J1.E28, J1.E30, J1.E32; also elsewhere on the board

Notes on the sheet:
adc
DSP
delta sigma
Gate driver

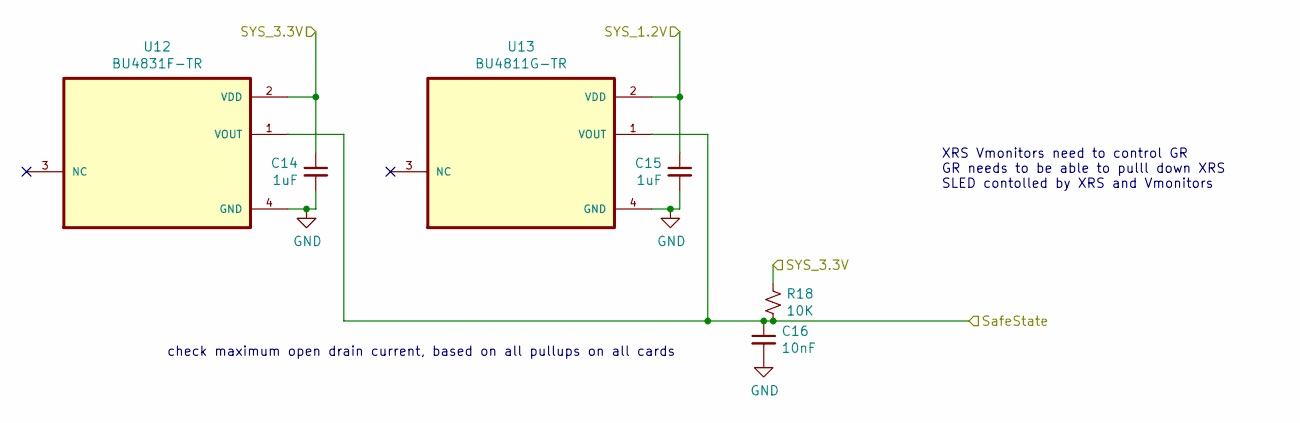
[picture p32: schematic MC-DSP-VoltageMonitors.sch]

Parts:
C14, C15: 1uF; C_0603_1608Metric_Pad1.08x0.95mm_HandSolder
C16: 10nF; C_0603_1608Metric_Pad1.08x0.95mm_HandSolder
R18: 10K; R_0603_1608Metric_Pad0.98x0.95mm_HandSolder
U12: BU4831F-TR; SOP4
U13: BU4811G-TR; TSOP-5_1.65x3.05mm_P0.95mm

Connections:
+3V3: C14.1, R18.1, U12.2 (VDD); also elsewhere on the board
/Safe_State: C16.1, R18.2, U12.1 (VOUT), U13.1 (VOUT); also elsewhere on the board
/Voltage Regulators/SYS_1.2V: C15.1, U13.2 (VDD); also elsewhere on the board
GND: C14.2, C15.2, C16.2, U12.4 (GND), U13.4 (GND); also elsewhere on the board

Notes on the sheet:
XRS Vmonitors need to control GR GR needs to be able to pulll down XRS SLED contolled by XRS and Vmonitors
check maximum open drain current, based on all pullups on all cards

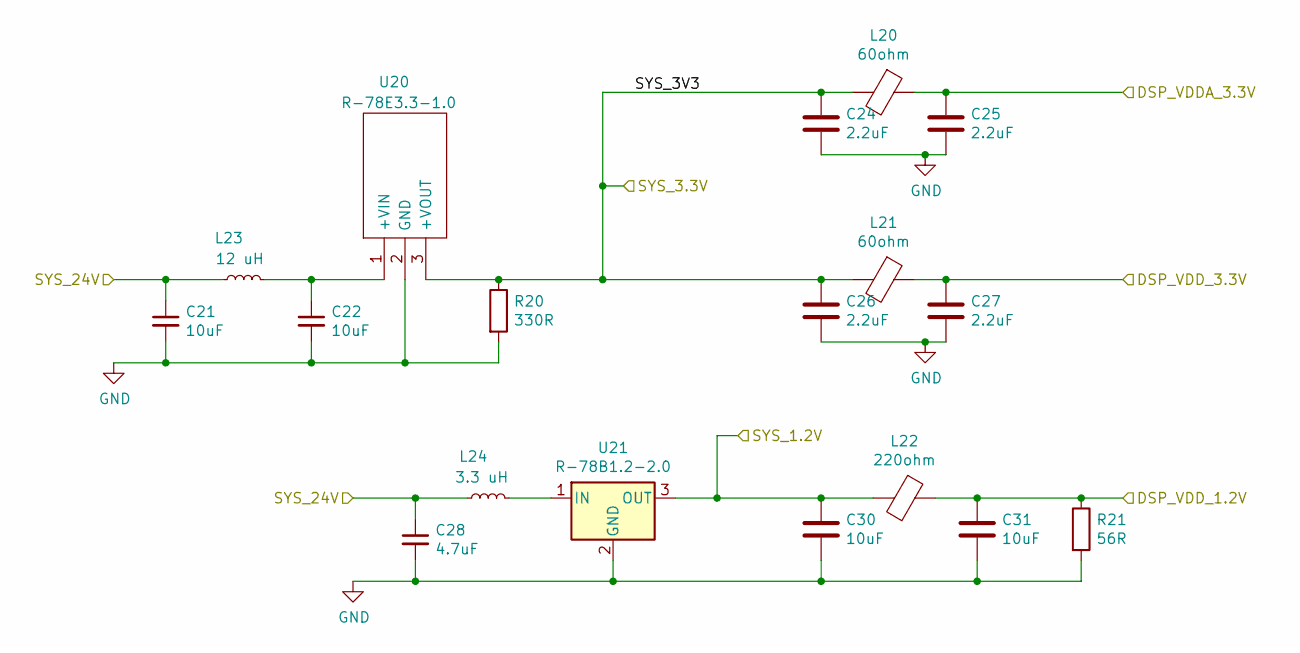
[picture p33: schematic MC-DSP-Vregs.sch]

Parts:
C21, C22: 10uF; C_1210_3225Metric
C24, C25, C26, C27: 2.2uF; C_0603_1608Metric_Pad1.08x0.95mm_HandSolder
C28: 4.7uF; C_1210_3225Metric
C30, C31: 10uF; C_0603_1608Metric_Pad1.08x0.95mm_HandSolder
L20, L21: 60ohm; L_0805_2012Metric_Pad1.05x1.20mm_HandSolder
L22: 220ohm; L_0805_2012Metric_Pad1.05x1.20mm_HandSolder
L23: 12 uH; L_Radial_D8.7mm_P5.00mm_Fastron_07HCP
L24: 3.3 uH; L_Radial_D8.7mm_P5.00mm_Fastron_07HCP
R20: 330R; R_0603_1608Metric_Pad0.98x0.95mm_HandSolder
R21: 56R; R_0603_1608Metric_Pad0.98x0.95mm_HandSolder
U20: R-78E3.3-1.0; Converter_DCDC_RECOM_R-78B-2.0_THT
U21: R-78B1.2-2.0; Converter_DCDC_RECOM_R-78B-2.0_THT

Connections:
+1V2: C31.1, L22.1, R21.1; also elsewhere on the board
+3V3: C24.2, C26.2, L20.2, L21.2, R20.1, U20.3 (+VOUT); also elsewhere on the board
+24V: C21.1, C28.1, L23.1, L24.1; also elsewhere on the board
/Voltage Regulators/SYS_1.2V: C30.2, L22.2, U21.3 (OUT); also elsewhere on the board
GND: C21.2, C22.2, C24.1, C25.2, C26.1, C27.2, C28.2, C30.1, C31.2, R20.2, R21.2, U20.2 (GND), U21.2 (GND); also elsewhere on the board
unnamed: C22.1, L23.2, U20.1 (+VIN)
unnamed: L24.2, U21.1 (IN)
VDD: C27.1, L21.1; also elsewhere on the board
VDDA: C25.1, L20.1; also elsewhere on the board

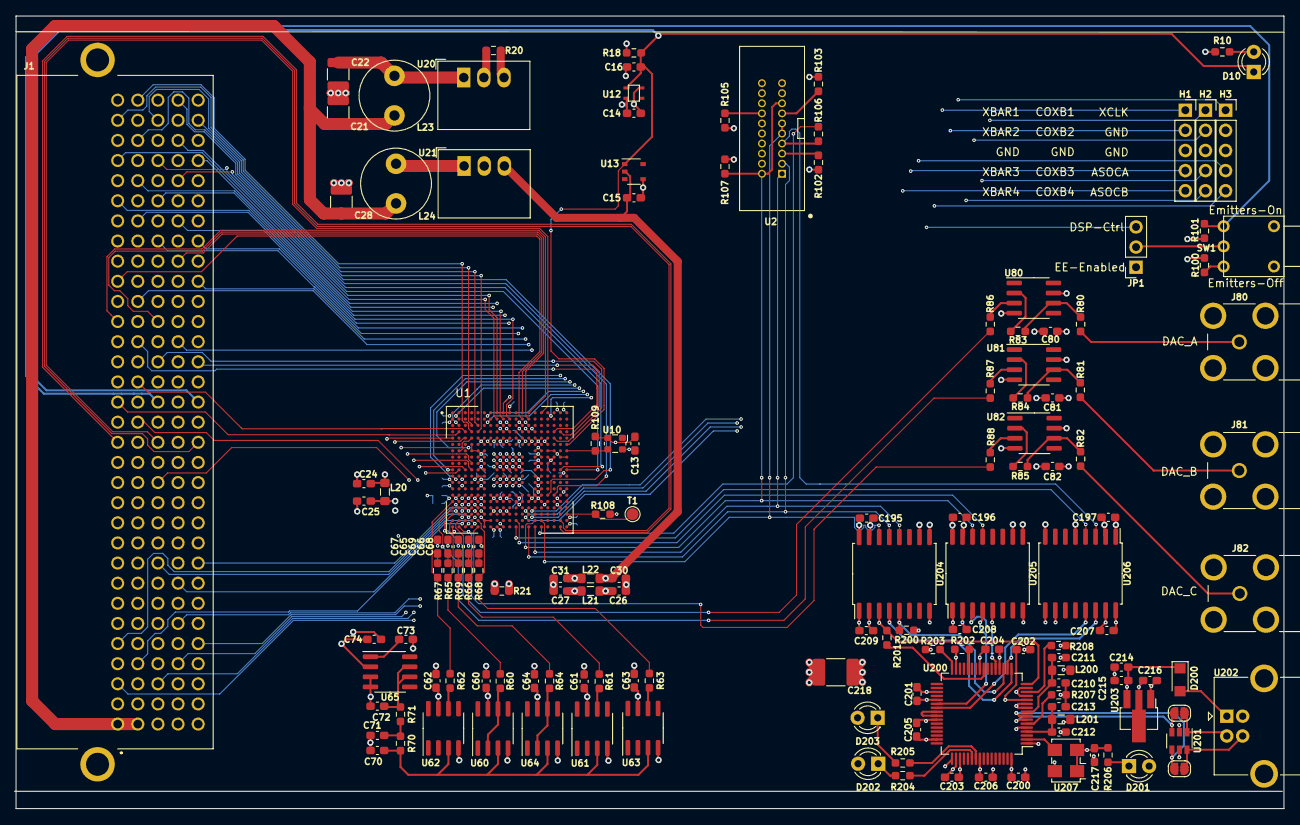
[picture p34: board MC-DSP.kicad_pcb from above]

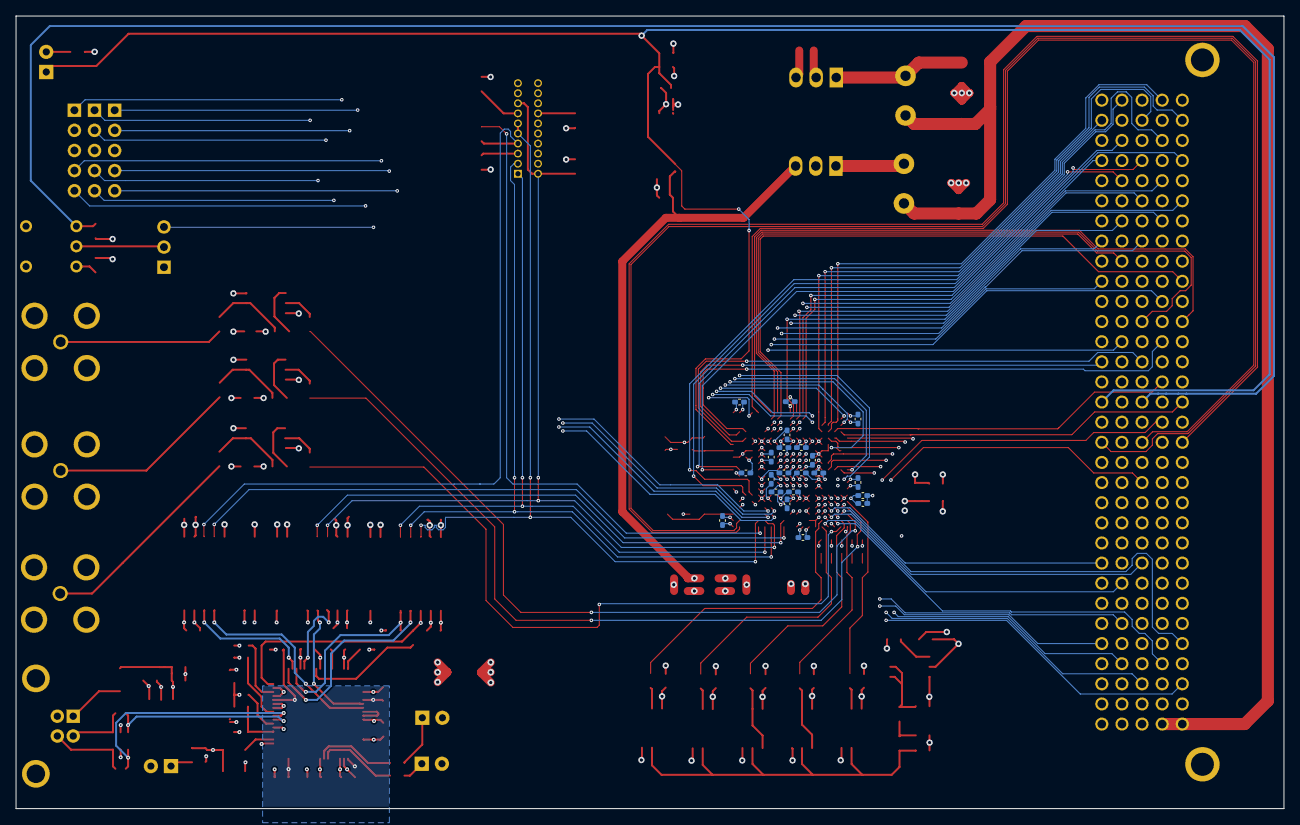
[picture p35: board MC-DSP.kicad_pcb from below]

Board: 6 copper layers, 160.0 x 100.0 mm, 165 parts (21 on the bottom side), 168 nets.
