zwmurray23/ncsu-freedm-srdes-21/MC-ADC/MC-ADC.kicad_pcb

## KiCad design MC-ADC/MC-ADC.kicad_pcb (2022-03-30)

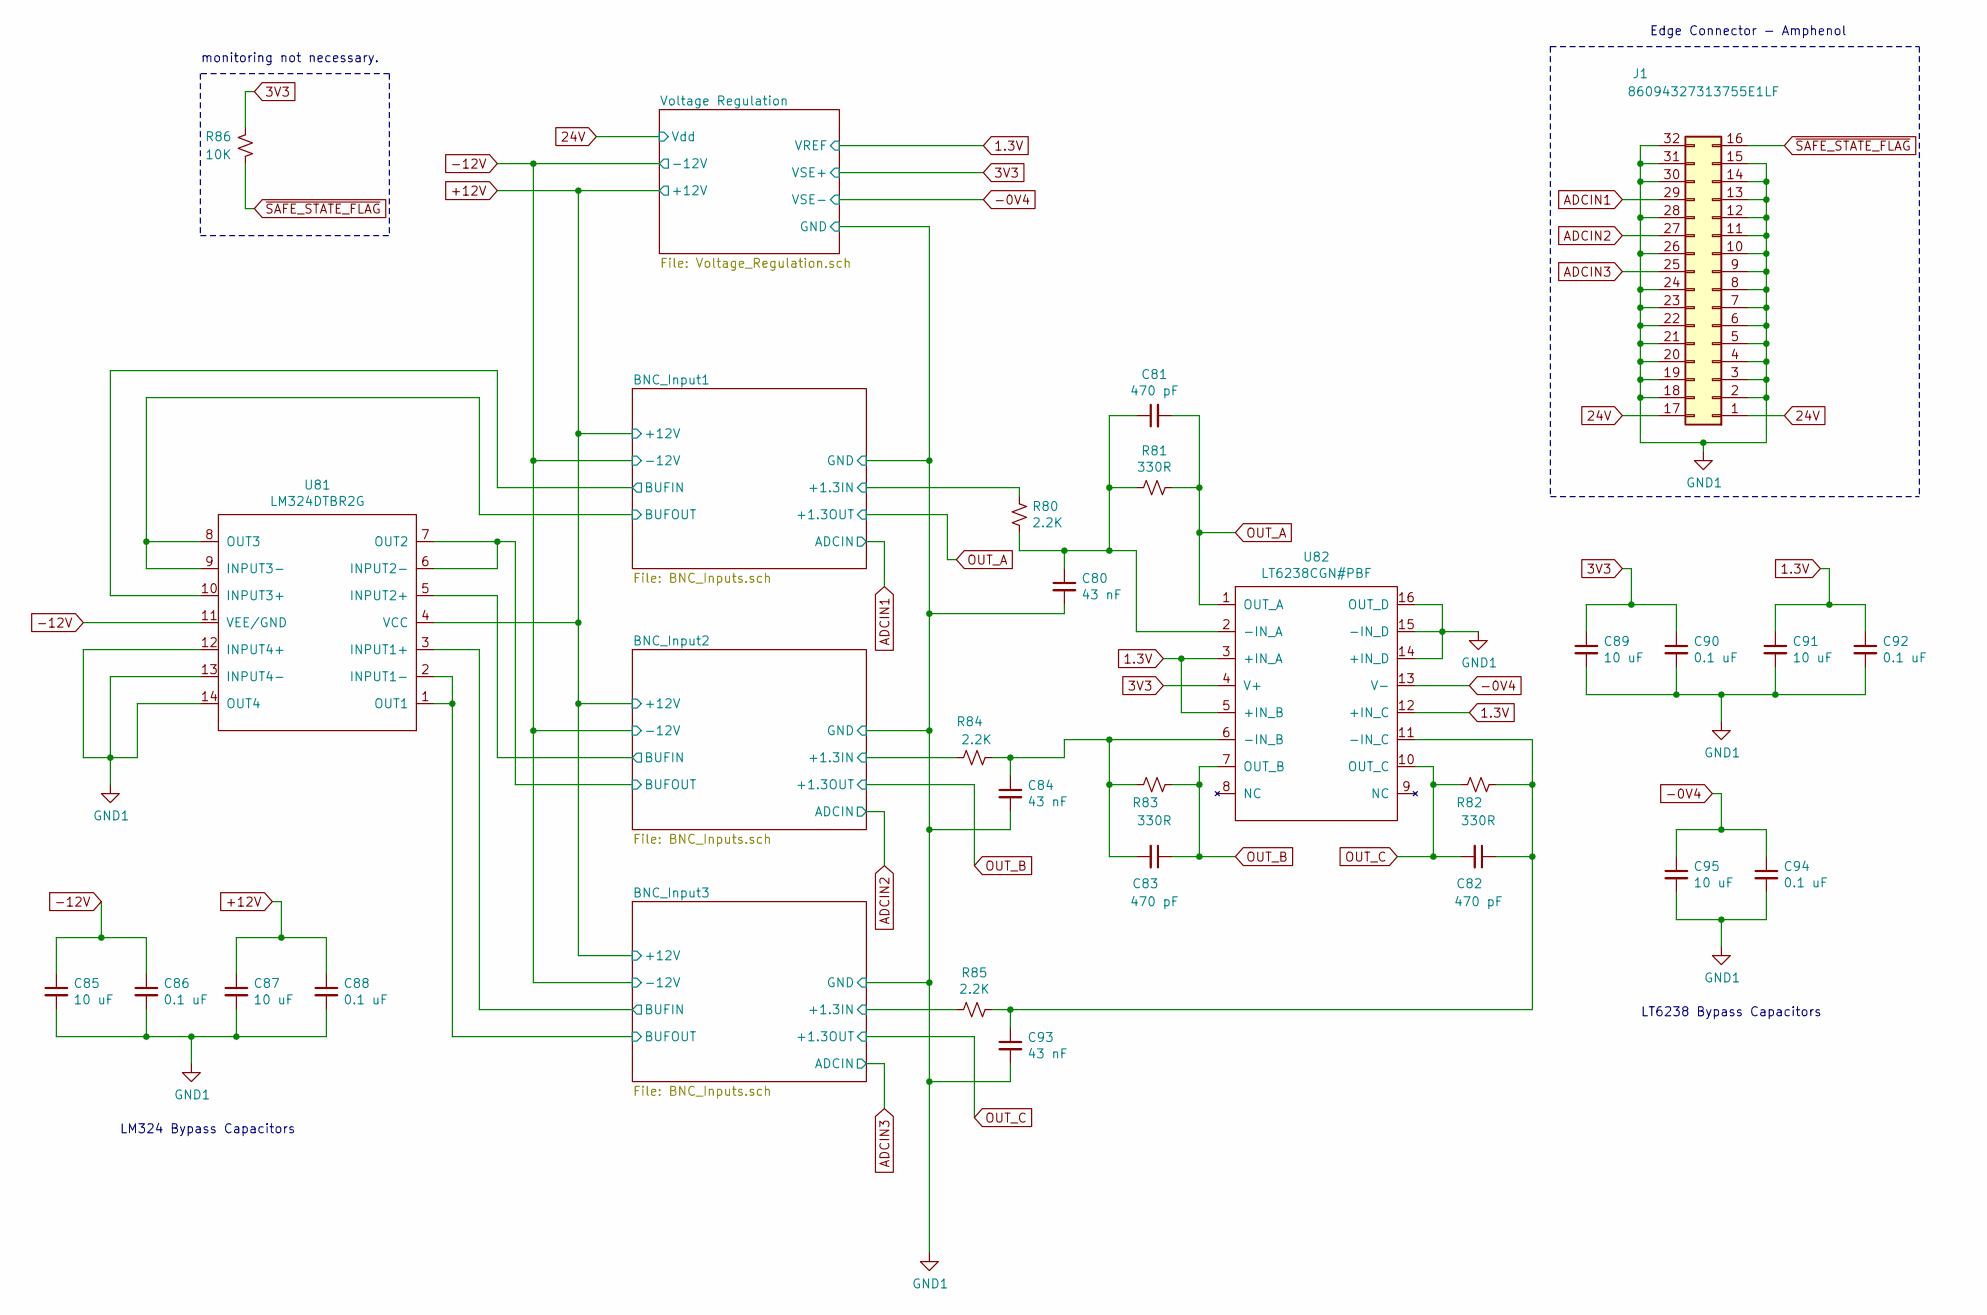
[picture p36: schematic MC-ADC.sch]

Parts:
C80, C84, C93: 43 nF; C_0805_2012Metric
C81, C82, C83: 470 pF; C_1206_3216Metric
C85, C87, C89, C91, C95: 10 uF; C_1210_3225Metric
C86, C88, C90, C92, C94: 0.1 uF; C_1210_3225Metric
J1: 86094327313755E1LF
R80, R84, R85: 2.2K; R_1206_3216Metric
R81, R82, R83: 330R; R_0603_1608Metric
R86: 10K; R_1206_3216Metric
U81: LM324DTBR2G
U82: LT6238CGN#PBF; SSOP-16_3.9x4.9mm_P0.635mm

Connections:
1.3V: C91.1, C92.1, U82.3 (+IN_A), U82.5 (+IN_B), U82.12 (+IN_C); also elsewhere on the board
3V3: C89.1, C90.1, R86.2, U82.4 (V+); also elsewhere on the board
24V: J1.1, J1.17; also elsewhere on the board
+12V: C87.1, C88.1, U81.4 (VCC); also elsewhere on the board
-0V4: C94.1, C95.1, U82.13 (V-); also elsewhere on the board
-12V: C85.1, C86.1, U81.11 (VEE/GND); also elsewhere on the board
/BNC_Input1/+1.3IN: R80.1; also elsewhere on the board
/BNC_Input1/BUFIN: U81.10 (INPUT3+); also elsewhere on the board
/BNC_Input1/BUFOUT: U81.8 (OUT3), U81.9 (INPUT3-); also elsewhere on the board
/BNC_Input2/+1.3IN: R84.1; also elsewhere on the board
/BNC_Input2/BUFIN: U81.5 (INPUT2+); also elsewhere on the board
/BNC_Input2/BUFOUT: U81.6 (INPUT2-), U81.7 (OUT2); also elsewhere on the board
/BNC_Input3/+1.3IN: R85.1; also elsewhere on the board
/BNC_Input3/BUFIN: U81.3 (INPUT1+); also elsewhere on the board
/BNC_Input3/BUFOUT: U81.1 (OUT1), U81.2 (INPUT1-); also elsewhere on the board
ADCIN1: J1.29; also elsewhere on the board
ADCIN2: J1.27; also elsewhere on the board
ADCIN3: J1.25; also elsewhere on the board
GND1: C80.2, C84.2, C85.2, C86.2, C87.2, C88.2, C89.2, C90.2, C91.2, C92.2, C93.2, C94.2, C95.2, J1.2, J1.3, J1.4, J1.5, J1.6, J1.7, J1.8, J1.9, J1.10, J1.11, J1.12, J1.13, J1.14, J1.15, J1.18, J1.19, J1.20, J1.21, J1.22, J1.23, J1.24, J1.26, J1.28, J1.30, J1.31, J1.32, U81.12 (INPUT4+), U81.13 (INPUT4-), U81.14 (OUT4), U82.14 (+IN_D), U82.15 (-IN_D), U82.16 (OUT_D); also elsewhere on the board
unnamed: C80.1, C81.1, R80.2, R81.1, U82.2 (-IN_A)
unnamed: C82.1, C93.1, R82.1, R85.2, U82.11 (-IN_C)
unnamed: C83.2, C84.1, R83.2, R84.2, U82.6 (-IN_B)
OUT_A: C81.2, R81.2, U82.1 (OUT_A); also elsewhere on the board
OUT_B: C83.1, R83.1, U82.7 (OUT_B); also elsewhere on the board
OUT_C: C82.2, R82.2, U82.10 (OUT_C); also elsewhere on the board
~SAFE_STATE_FLAG: J1.16, R86.1

Notes on the sheet:
Edge Connector - Amphenol
monitoring not necessary.
LM324 Bypass Capacitors
LT6238 Bypass Capacitors

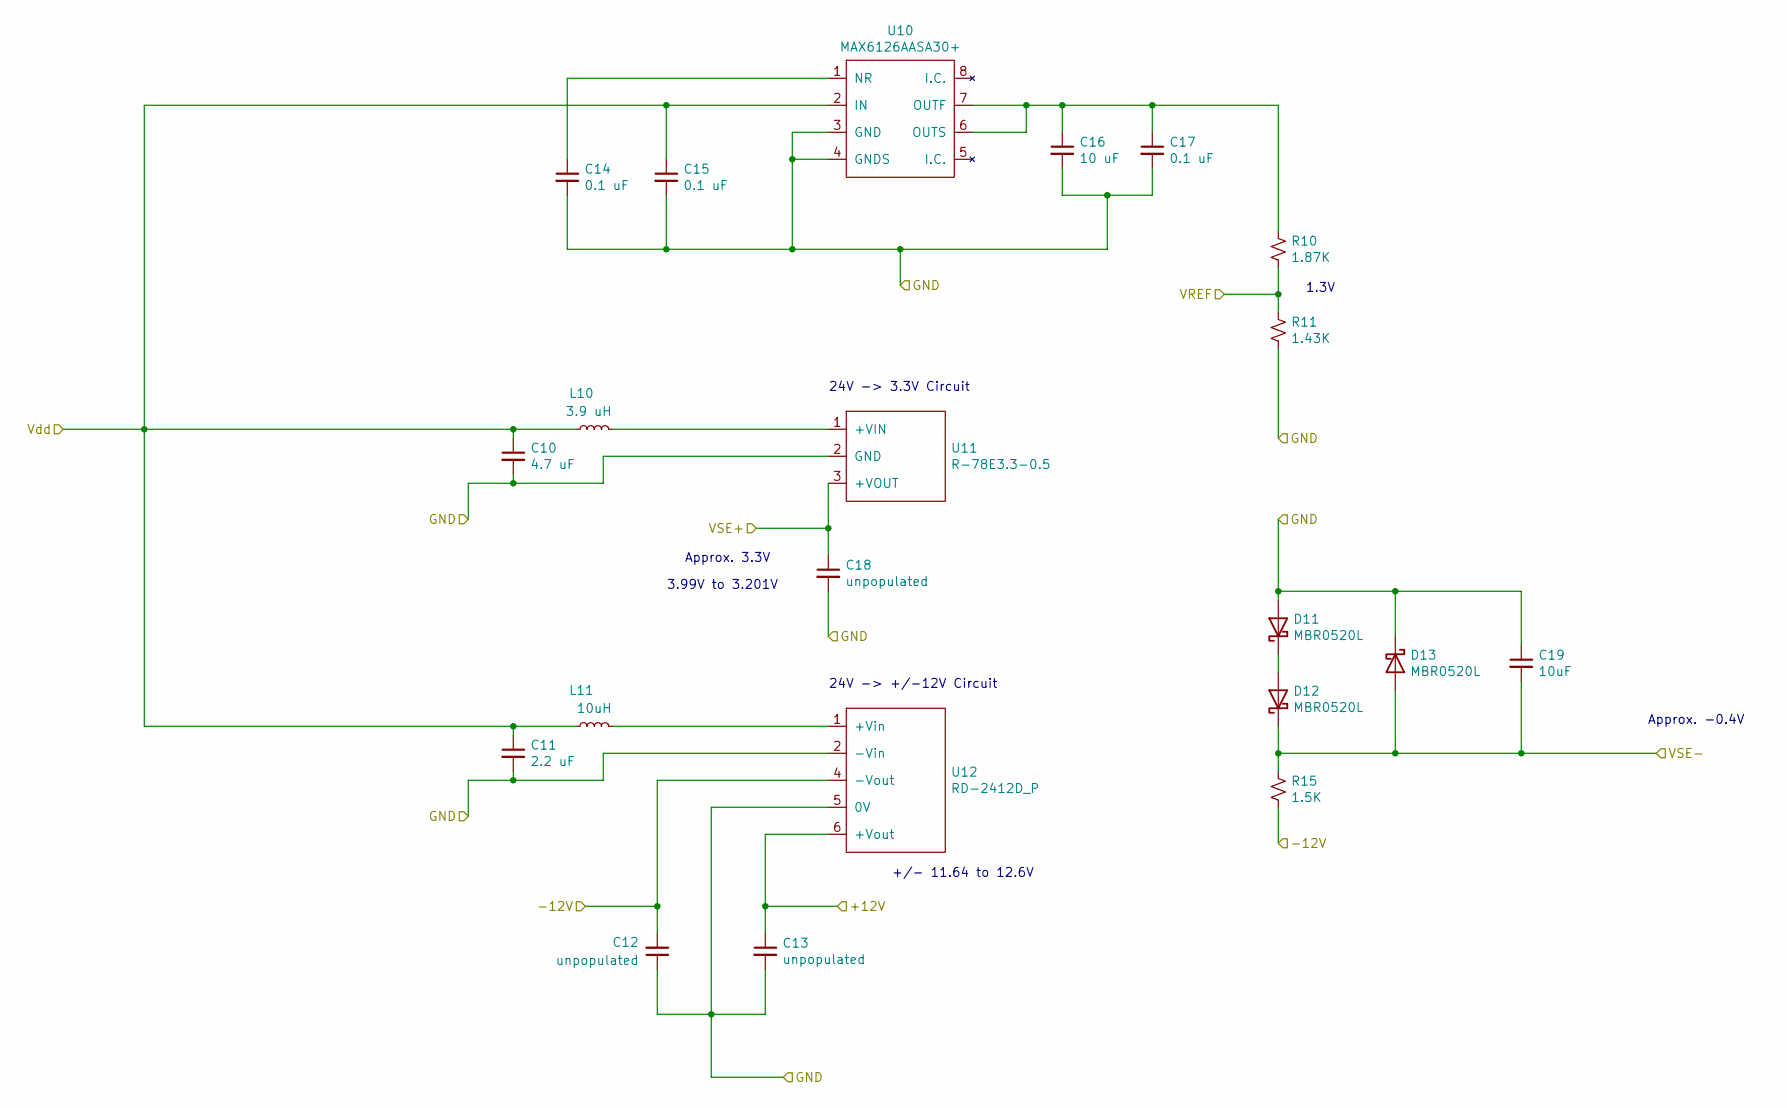
[picture p37: schematic Voltage_Regulation.sch]

Parts:
C10: 4.7 uF; C_1210_3225Metric
C11: 2.2 uF; C_1210_3225Metric
C12, C13, C18: unpopulated; C_1210_3225Metric
C14, C15, C17: 0.1 uF; C_1210_3225Metric
C16: 10 uF; C_1210_3225Metric
C19: 10uF; C_1210_3225Metric
D11, D12, D13: MBR0520L; SOD3716X135N
L10: 3.9 uH; L_1812_4532Metric_Pad1.30x3.40mm_HandSolder
L11: 10uH; INDPM4040X190N
R10: 1.87K; R_0603_1608Metric
R11: 1.43K; R_0603_1608Metric
R15: 1.5K; R_1206_3216Metric
U10: MAX6126AASA30+; SOIC-8_3.9x4.9mm_P1.27mm
U11: R-78E3.3-0.5; SIP3_11.6x8.5mm
U12: RD-2412D_P; RD-2412D

Connections:
1.3V: R10.2, R11.1; also elsewhere on the board
3V3: C18.1, U11.3 (+VOUT); also elsewhere on the board
24V: C10.1, C11.1, C15.1, L10.1, L11.1, U10.2 (IN); also elsewhere on the board
+12V: C13.1, U12.6 (+Vout); also elsewhere on the board
-0V4: C19.2, D12.1 (K), D13.2 (A), R15.1; also elsewhere on the board
-12V: C12.2, R15.2, U12.4 (-Vout); also elsewhere on the board
GND1: C10.2, C11.2, C12.1, C13.2, C14.2, C15.2, C16.2, C17.2, C18.2, C19.1, D11.2 (A), D13.1 (K), R11.2, U10.3 (GND), U10.4 (GNDS), U11.2 (GND), U12.2 (-Vin), U12.5 (0V); also elsewhere on the board
unnamed: C14.1, U10.1 (NR)
unnamed: C16.1, C17.1, R10.1, U10.6 (OUTS), U10.7 (OUTF)
unnamed: D11.1 (K), D12.2 (A)
unnamed: L10.2, U11.1 (+VIN)
unnamed: L11.2, U12.1 (+Vin)

Notes on the sheet:
24V -> +/-12V Circuit
24V -> 3.3V Circuit
1.3V
Approx. 3.3V
+/- 11.64 to 12.6V
3.99V to 3.201V
Approx. -0.4V

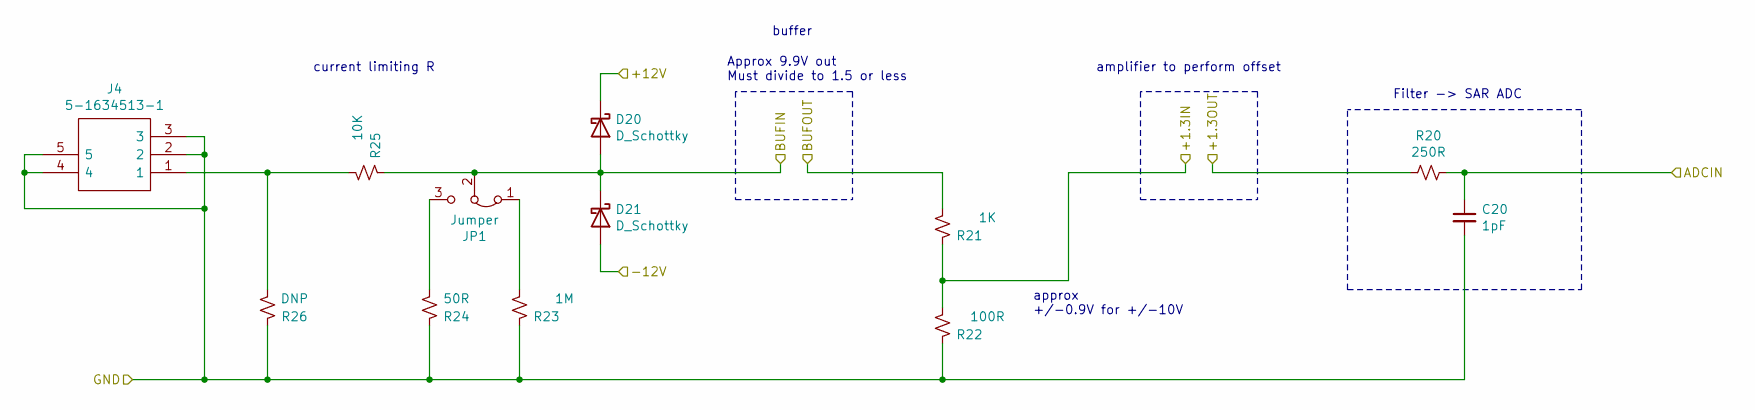
[picture p38: schematic BNC_Inputs.sch]

Parts:
C20: 1pF; C_0603_1608Metric
D20, D21: D_Schottky; SOT-23
J4: 5-1634513-1; 516345131; Manufacturer_Part_Number 5-1634513-1; Mouser Part Number 571-5-1634513-1
JP1: Jumper; PinHeader_1x03_P2.54mm_Vertical
R20: 250R; R_0603_1608Metric
R21: 1K; R_0805_2012Metric
R22: 100R; R_0603_1608Metric
R23: 1M; R_1206_3216Metric
R24: 50R; R_0603_1608Metric
R25: 10K; R_1206_3216Metric
R26: DNP; R_1206_3216Metric

Connections:
+12V: D20.1 (K); also elsewhere on the board
-12V: D21.2 (A); also elsewhere on the board
/BNC_Input1/+1.3IN: R21.2, R22.1; also elsewhere on the board
/BNC_Input1/BUFIN: D20.2 (A), D21.1 (K), JP1.2 (C), R25.2; also elsewhere on the board
/BNC_Input1/BUFOUT: R21.1; also elsewhere on the board
ADCIN1: C20.1, R20.1; also elsewhere on the board
GND1: C20.2, J4.2, J4.3, J4.4, J4.5, R22.2, R23.2, R24.2, R26.2; also elsewhere on the board
unnamed: J4.1, R25.1, R26.1
unnamed: JP1.1 (A), R23.1
unnamed: JP1.3 (B), R24.1
OUT_A: R20.2; also elsewhere on the board

Parts of its further copies:
C30, C40: 1pF; C_0603_1608Metric
D30, D31, D41, D42: D_Schottky; SOT-23
J2, J3: 5-1634513-1; 516345131; Manufacturer_Part_Number 5-1634513-1; Mouser Part Number 571-5-1634513-1
JP2, JP3: Jumper; PinHeader_1x03_P2.54mm_Vertical
R30, R40: 250R; R_0603_1608Metric
R31, R41: 100R; R_0603_1608Metric
R32, R42: 1K; R_0805_2012Metric
R33, R43: 1M; R_1206_3216Metric
R34, R44: 50R; R_0603_1608Metric
R35, R45: 10K; R_1206_3216Metric
R36, R46: DNP; R_1206_3216Metric

Connections of its further copies:
+12V: D30.1 (K), D41.1 (K); also elsewhere on the board
-12V: D31.2 (A), D42.2 (A); also elsewhere on the board
/BNC_Input2/+1.3IN: R31.1, R32.2; also elsewhere on the board
/BNC_Input2/BUFIN: D30.2 (A), D31.1 (K), JP2.2 (C), R35.2; also elsewhere on the board
/BNC_Input2/BUFOUT: R32.1; also elsewhere on the board
/BNC_Input3/+1.3IN: R41.1, R42.2; also elsewhere on the board
/BNC_Input3/BUFIN: D41.2 (A), D42.1 (K), JP3.2 (C), R45.2; also elsewhere on the board
/BNC_Input3/BUFOUT: R42.1; also elsewhere on the board
ADCIN2: C30.1, R30.1; also elsewhere on the board
ADCIN3: C40.1, R40.1; also elsewhere on the board
GND1: C30.2, C40.2, J2.2, J2.3, J2.4, J2.5, J3.2, J3.3, J3.4, J3.5, R31.2, R33.2, R34.2, R36.2, R41.2, R43.2, R44.2, R46.2; also elsewhere on the board
unnamed: J2.1, R35.1, R36.1
unnamed: J3.1, R45.1, R46.1
unnamed: JP2.1 (A), R33.1
unnamed: JP2.3 (B), R34.1
unnamed: JP3.1 (A), R43.1
unnamed: JP3.3 (B), R44.1
OUT_B: R30.2; also elsewhere on the board
OUT_C: R40.2; also elsewhere on the board

Notes on the sheet:
Filter -> SAR ADC
buffer
amplifier to perform offset
current limiting R
Approx 9.9V out Must divide to 1.5 or less
approx +/-0.9V for +/-10V

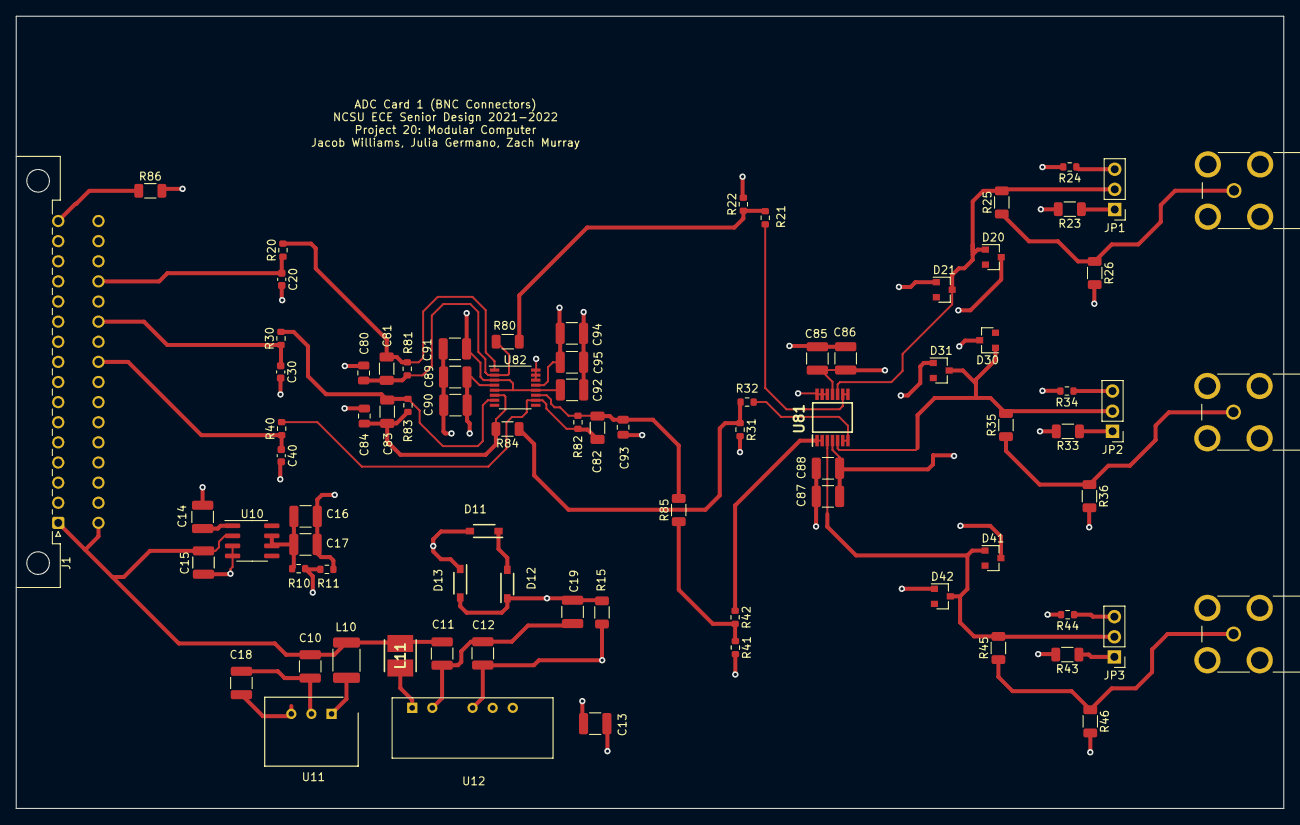
[picture p39: board MC-ADC.kicad_pcb from above]

Board: 4 copper layers, 160.0 x 100.0 mm, 83 parts (0 on the bottom side), 40 nets.
