zwmurray23/ncsu-freedm-srdes-21/(commit log)

2021-10-20 LED Prelim Schematics Upload
    [leds.sch]
2021-10-20 Emitter CKT in progress
    [Emitter_Detector_Circuits.sch]
2021-10-21 Add IC Models
    [74ACT08SCX.stl, 74ACT08SCX.stp]
2021-10-21 New model library
    [TLV3501AID.stp]
2021-10-21 Add detector schematics, update hierarchy
    [Detector_Circuits.sch, Emitter_Circuits.sch, Emitter_Detector_Circuits.sch, leds.sch]
2021-10-21 update new ic's
    [R-78E3.3-0.5.stp, R-78E5.0-0.5.stp]
2021-10-21 Added Voltage Reg. CKTs
    [Voltage_Regulation.sch]
2021-10-21 moved FO Board to using hierarchical sheets
    [Detector_Circuits.sch, Emitter_Circuits.sch, MC-DSP.kicad_pcb, MC-DSP.sch, MC-FO.kicad_pcb, MC-FO.sch, MC-LED.sch, Voltage_Regulation.sch]
2021-10-22 Add files via upload
    added rest of emitters/detectors and power led
    [Detector_Circuits.sch, Emitter_Circuits.sch, MC-FO.kicad_pcb, MC-FO.sch, MC-LED.sch, MC-Power_LED.sch, Voltage_Regulation.sch]
2021-10-25 Updated naming, Pi filters
    [Detector_Circuits.sch, Emitter_Circuits.sch, MC-LED.sch, Voltage_Regulation.sch]
2021-10-25 Updated LED Ckts, Added new IC model
    [Detector_Circuits.sch, Emitter_Circuits.sch, MC-FO.sch, MC-LED.sch, TPS3703A5500DSER.stl, TPS3703A5500DSER.stp]
2021-10-25 5V tolerant logic to Detector and designators
2021-10-26 a few more FO tweaks 10-26
    [Detector_Circuits.sch, Emitter_Circuits.sch, MC-FO.sch, MC-LED.sch, Voltage_Regulation.sch]
2021-10-27 added footprints and reference
    [Detector_Circuits.sch, Emitter_Circuits.sch, MC-FO.sch, MC-LED.sch, Voltage_Regulation.sch]
2021-10-27 LED symbol
2021-10-28 floating pins fix, signal name updates
    [Emitter_Circuits.sch, MC-FO.sch, MC-LED.sch]
2021-10-28 C31-34 larger packaging and part assignment
    [Emitter_Circuits.sch, Voltage_Regulation.sch]
2021-10-28 remove part # on Cap...getting ahead of myself
    [Voltage_Regulation.sch]
2021-10-28 Fixed floating pins, added notes
    [MC-LED.sch]
2021-10-29 unpopulated cap after voltage regulators
    and changed reference designator numbering scheme
    and moved the or gate that sends 3.3 V to comparator in detector ckt
    [Detector_Circuits.sch, Emitter_Circuits.sch, MC-FO.sch, MC-LED.sch, Voltage_Regulation.sch]
2021-10-30 many changes
    -one ground
    -RESET_FO added
    -pull down resistors on resets, status and pwm
    -Detector 1 ckt OR gate after comparator
    [Detector_Circuits.sch, Emitter_Circuits.sch, MC-FO.kicad_pcb, MC-FO.sch, MC-LED.sch, MC-Power_LED.sch, Voltage_Regulation.sch]
2021-10-30 pull down resistor footprint
    [MC-FO.sch]
2021-10-30 Fixed file hierarchy
    [Detector_Circuits.sch, Emitter_Circuits.sch, MC-FO.kicad_pcb, MC-FO.sch, MC-LED.sch, MC-Power_LED.sch, Voltage_Regulation.sch]
2021-10-30 Detector2 update, RESET integration
    [Detector_Circuits.sch, Emitter_Circuits.sch, MC-FO.sch, MC-LED.sch, Voltage_Regulation.sch]
2021-10-30 add connector, reset implementation
    [Detector_Circuits.sch, MC-FO.sch, MC-LED.sch]
2021-10-30 reset implementation, connector
    [Emitter_Circuits.sch]
2021-11-01 update footprints, resistors
    [Detector_Circuits.sch, MC-FO.sch]
2021-11-01 removed outdated FO Board files
    [Detector_Circuits.sch, Emitter_Circuits.sch, Voltage_Regulation.sch, leds.sch]
2021-11-01 add connector files
2021-11-01 Connector Footprint
2021-11-01 Linked footprint for connector
    [MC-FO.sch]
2021-11-03 changed status1 to output of detector
    reassigned footprint of 550 LED
    [Detector_Circuits.sch, Emitter_Circuits.sch, MC-FO.sch, MC-LED.sch, Voltage_Regulation.sch]
2021-11-03 PCB Layout begins
    - read in the netlist
    - drew the edge of the card
    - moved the footprints around
    - 4 layer board, parts on front only
    [MC-FO.sch]
2021-11-04 routing prep/organization
    moving detectors/emitters around to find where to put status LED
    [MC-FO.kicad_pcb]
2021-11-05 Update LED, Transc. Footprint, layout
    [MC-FO.kicad_pcb, MC-FO.sch, MC-LED.sch]
2021-11-06 Removed AND-OR gates
    [Detector_Circuits.sch, MC-FO.sch]
2021-11-08 DSP schem, FO schem, and FO layout changes
    [DP83822IRHBR.step, Detector_Circuits.sch, Emitter_Circuits.sch, MC-DSP-CLK.sch, MC-DSP-EtherCAT.sch, MC-DSP-Ethernet.sch, MC-DSP-FTDI.sch, MC-DSP-Vregs.sch]
2021-11-08 Routed FO schematic
    All FO circuits routed except LED and Detector circuits.
    [MC-FO.kicad_pcb, MC-FO.sch]
2021-11-08 Changed V-monitor circuit, V-reg circuit, finished detectors
    [Emitter_Circuits.sch, MC-FO.kicad_pcb, MC-LED.sch, TPS3305-33D.step]
2021-11-08 24V line and LED ckrt fix
    [MC-FO.kicad_pcb]
2021-11-09 First gerber file version for FO card
2021-11-09 added bottom solder mask to gerbers
    [MC-FO.kicad_pcb]
2022-01-19 updated top level of schematic with "to test" and "to do" notes
    [FOport-IFE98-IFD97.STEP, MC-DSP-CLK.sch, MC-DSP-DACtoBNC.sch, MC-DSP-EtherCAT.sch, MC-DSP-Ethernet.sch, MC-DSP-FTDI.sch, MC-DSP-StatusLEDs.sch, MC-DSP-VoltageMonitors.sch]
2022-01-21 Add ADC card project
    [MC-ADC.kicad_pcb, MC-ADC.sch]
2022-01-24 Minor ADC work
    [MC-ADC.sch]
2022-01-24 added reverse polarity protection circuit and fuse
    [ADCSlots.sch, Backplane.sch, DSPSlot.sch, DeltaSigmasSlots.sch, GateDriveSlots.sch]
2022-01-25 pmos swap, fuse cartridge, power conn
    [Backplane.sch]
2022-01-26 ADC Work
    [MC-ADC.sch, Terminations.sch]
2022-02-01 added signals for FO slots
    [ADCSlots.sch, Backplane.sch, DSPSlot.sch, DeltaSigmasSlots.sch, GateDriveSlots.sch, GateDriveSlots4-6.sch, ReversePolarityProtection.sch]
2022-02-02 Significant ADC Progress
    [MC-ADC.kicad_pcb, MC-ADC.sch, Terminations.sch, Voltage_Regulation.sch]
2022-02-14 Add files via upload
    updating net names and wires
    [ADCSlots.sch, Backplane.sch, DSPSlot.sch, DeltaSigmasSlots.sch, GateDriveSlots.sch, GateDriveSlots4-6.sch, ReversePolarityProtection.sch]
2022-02-16 ADC Updates!
    [BNC_Inputs.sch, MC-ADC.sch, Voltage_Regulation.sch]
2022-02-18 Signal naming cleanup/ dsp pin pairing
    [ADCSlots.sch, Backplane.sch, DSPSlot.sch, DeltaSigmasSlots.sch, GateDriveSlots.sch, GateDriveSlots4-6.sch]
2022-02-21 ADC refs, FTDI changes, and more
    [CONMMCX001.step, MC-DSP-ADCrefs.sch, MC-DSP-CLK.sch, MC-DSP-DACtoBNC.sch, MC-DSP-EtherCAT.sch, MC-DSP-FTDI.sch, MC-DSP-StatusLEDs.sch, MC-DSP-VoltageMonitors.sch]
2022-02-21 Prep for DSP connector
    [ADCSlots.sch, Backplane.sch, DSPSlot.sch]
2022-02-21 fixed some dsp pin routing
    [MC-DSP-DACtoBNC.sch, MC-DSP.sch]
2022-02-28 updating SAFE_STATE_FLAG and EMITTER_ENABLE
    [Detector_circuit.sch, Emitter_Circuits.sch, MC-FO.sch, MC-LED.sch]
2022-03-01 schematic changes--> layout rev
    [Detector_circuit.sch, Emitter_Circuits.sch, MC-FO.kicad_pcb, MC-FO.sch, MC-LED.sch, Voltage_Regulation.sch]
2022-03-02 Pre final revision Layout
    [MC-FO.kicad_pcb]
2022-03-04 simplify vias, mechanical hole change
    [MC-FO.csv, MC-FO.kicad_pcb]
2022-03-07 All parts labeled, just need to pick passives basically.
    [MC-DSP-ADCrefs.sch, MC-DSP-CLK.sch, MC-DSP-DACtoBNC.sch, MC-DSP-Ethernet.sch, MC-DSP-FTDI.sch, MC-DSP-StatusLEDs.sch, MC-DSP-VoltageMonitors.sch, MC-DSP-Vregs.sch]
2022-03-07 DSP interface pin out
    [ADCSlots.sch, Backplane.sch, DSPSlot.sch, DeltaSigmasSlots.sch, GateDriveSlots.sch, GateDriveSlots4-6.sch]
2022-03-08 beginning layout
    [ADCSlots.sch, Backplane.kicad_pcb, Backplane.sch, DSPSlot.sch, DeltaSigmasSlots.sch, GateDriveSlots.sch, GateDriveSlots4-6.sch, ReversePolarityProtection.sch]
2022-03-09 schematic reorg and layout begins
    [ADCSlots.sch, AnalogSlot.sch, Backplane.kicad_pcb, Backplane.sch, DSPSlot.sch, DeltaSigmaSlot.sch, DeltaSigmasSlots.sch, GateDriveSlot.sch]
2022-03-09 ADC Work + Start Layout
    [BNC_Inputs.sch, MC-ADC.kicad_pcb, MC-ADC.sch, Voltage_Regulation.sch]
2022-03-09 ADC Work + Layout
    [MC-ADC.kicad_pcb, MC-ADC.sch, Voltage_Regulation.sch]
2022-03-09 DSP - added footprints and links to most parts
    [MC-DSP-ADCrefs.sch, MC-DSP-CLK.sch, MC-DSP-DACtoBNC.sch, MC-DSP-Ethernet.sch, MC-DSP-FTDI.sch, MC-DSP-StatusLEDs.sch, MC-DSP-VoltageMonitors.sch, MC-DSP-Vregs.sch]
2022-03-09 ADC work for Alpha
    [MC-ADC.kicad_pcb, MC-ADC.sch]
2022-03-09 Removed clock buffer, misc leds, ethernet
    [MC-DSP-ADCrefs.sch, MC-DSP-CLK.sch, MC-DSP-DACtoBNC.sch, MC-DSP-Ethernet.sch, MC-DSP-FTDI.sch, MC-DSP-StatusLEDs.sch, MC-DSP-VoltageMonitors.sch, MC-DSP-Vregs.sch]
2022-03-09 placement done- tracks started
    [Backplane.kicad_pcb, Backplane.sch, DSPSlot.sch, DeltaSigmaSlot.sch, GateDriveSlot.sch]
2022-03-11 ADC LAYOUT
    [BNC_Inputs.sch, MC-ADC.kicad_pcb, MC-ADC.sch, Voltage_Regulation.sch]
2022-03-11 layout done: cleaning up and checking MH
    [AnalogSlot.sch, Backplane.kicad_pcb, Backplane.sch, DSPSlot.sch, DeltaSigmaSlot.sch, GateDriveSlot.sch]
2022-03-11 Prelim ADC layout complete
    [BNC_Inputs.sch, MC-ADC.kicad_pcb, MC-ADC.sch]
2022-03-12 Layout done: ready for revisions
    - double check measurements and connector placement
    -passes DRC schematic and layout
    [Backplane.kicad_pcb]
2022-03-12 Layout ready for review
    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
    [AnalogSlot.sch, Backplane.kicad_pcb, DeltaSigmaSlot.sch, GateDriveSlot.sch]
2022-03-12 Layout Revision
    -removed MH1 from emitter/detector symbol
    -pin out changes to assist with routing on the backplane
    [Detector_circuit.sch, Emitter_Circuits.sch, MC-FO.kicad_pcb, MC-FO.sch]
2022-03-14 some DRC edits and pinout changes
    still need to:
    - add gnd test points
    - fix pad too close to pad errors
    - spread the reference vias on the traces that change layers farther apart
    -allow more layout around U2 and U3 in the layout due to 24V
    [Emitter_Circuits.sch, MC-FO.kicad_pcb, MC-FO.sch]
2022-03-14 spread tracks across available space
    could still add some test points
    [Backplane.kicad_pcb, Backplane.sch, DSPSlot.sch, DeltaSigmaSlot.sch]
2022-03-14 DRC error fixes, added gnd testpoints
    [Detector1.sch, Detector_Circuits.sch, Detector_circuit.sch, Emitter_Circuits.sch, MC-FO.csv, MC-FO.kicad_pcb, MC-FO.sch, MC-LED.sch]
2022-03-14 DRC error fixes and gnd test points added
    [Detector_circuit.sch, Emitter_Circuits.sch, MC-FO.kicad_pcb, MC-FO.sch]
2022-03-14 added testpoints
    [AnalogSlot.sch, Backplane.kicad_pcb, Backplane.sch, DSPSlot.sch, DeltaSigmaSlot.sch, GateDriveSlot.sch]
2022-03-16 removed some MHs and attempted to fix library
    [Backplane.kicad_pcb, GateDriveSlot.sch, ReversePolarityProtection.sch]
2022-03-16 slot label correction
    [Backplane.kicad_pcb]
2022-03-18 moved global lib to project lib
    [Backplane.kicad_pcb]
2022-03-19 added backplane connector, changed right angle headers, added FP for bigger reg caps, all ICs arranged, routed isolated section.
    [MC-DSP-ADCrefs.sch, MC-DSP-DACtoBNC.sch, MC-DSP-FTDI.sch, MC-DSP-VoltageMonitors.sch, MC-DSP-Vregs.sch, MC-DSP.kicad_pcb, MC-DSP.sch]
2022-03-21 connected DSP signals to BP connector symbol, routed most non-signal traces on PCB
    [MC-DSP-ADCrefs.sch, MC-DSP-DACtoBNC.sch, MC-DSP-DSPSlot.sch, MC-DSP-FTDI.sch, MC-DSP-VoltageMonitors.sch, MC-DSP-Vregs.sch, MC-DSP.kicad_pcb, MC-DSP.sch]
2022-03-22 ADC Gerbers Generated
    [MC-ADC-B_Cu.gbl, MC-ADC-B_Mask.gbs, MC-ADC-B_Paste.gbp, MC-ADC-B_SilkS.gbo, MC-ADC-Edge_Cuts.gm1, MC-ADC-F_Cu.gtl, MC-ADC-F_Mask.gts, MC-ADC-F_Paste.gtp]
2022-03-30 Total overhaul of power planes. Routed whole Analog section, middle of digital section.
    [MC-DSP-ADCrefs.sch, MC-DSP-DACtoBNC.sch, MC-DSP-FTDI.sch, MC-DSP-VoltageMonitors.sch, MC-DSP-Vregs.sch, MC-DSP.kicad_pcb, MC-DSP.sch]
2022-03-31 DSP breakout to backplane done, just need to route final 11 signals.
    [MC-DSP-Vregs.sch, MC-DSP.sch]
2022-04-01 fixed V7 gnd issue
    [MC-DSP.kicad_pcb]
2022-04-01 Fixed all DSP symbol and footprint Library paths to be implicit
    [74ACT08SCX.stl, 74ACT08SCX.stp, R-78E3.3-0.5.stp, R-78E5.0-0.5.stp, TPS3702CX33DDCR.step, TPS3703A5500DSER.stl, TPS3703A5500DSER.stp, Texas_Instruments_-_CDCLVC1104PW.step]
2022-04-01 Fixed ADC ref low pass filter positions (moved them closer to the DSP) and fixed board outline
    [MC-DSP.kicad_pcb]
2022-04-01 Routed Last 11 tracks, fixed cu.4 gnd pour
    [MC-DSP-DACtoBNC.sch, MC-DSP.kicad_pcb]
2022-04-01 Added labels on the silkscreen
    [MC-DSP.kicad_pcb]
2022-04-01 generated gerbers
    [MC-DSP-B_Cu.gbl, MC-DSP-B_Mask.gbs, MC-DSP-B_Paste.gbp, MC-DSP-B_SilkS.gbo, MC-DSP-Edge_Cuts.gm1, MC-DSP-F_Cu.gtl, MC-DSP-F_Mask.gts, MC-DSP-F_Paste.gtp]
2022-04-16 - updated PMOSFET&Zener footprint
    reverse polarity protection circuit
    [Backplane.kicad_pcb, ReversePolarityProtection.sch]
2022-04-26 Voltage detector footprint correction
    [MC-FO.kicad_pcb, MC-LED.sch]
2022-04-26 increased 24V trace width.
    [Backplane.kicad_pcb, ReversePolarityProtection.sch]
